shumov-ag/wp2017/README.md

# wp2017

The attempt to make the hardware write blocker for SATA drives.
As a result the sata repeater was made based on a Xilinx Artix-7 FPGA
