shumov-ag/wp2017/doc/WP2017-1803051133-N.pdf

#COMPANY# | #WP#2017#/1803051133-N

Страница 1 из 23

### Черновик

### Блокиратор записи для дисков с интерфейсом SATA –

### Заметки

### История расходов #2

Страница 2 из 23

## Оглавление

Страница 3 из 23

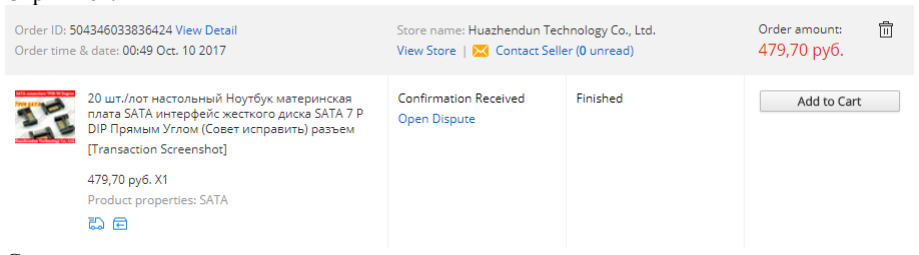
[picture p24: figure]
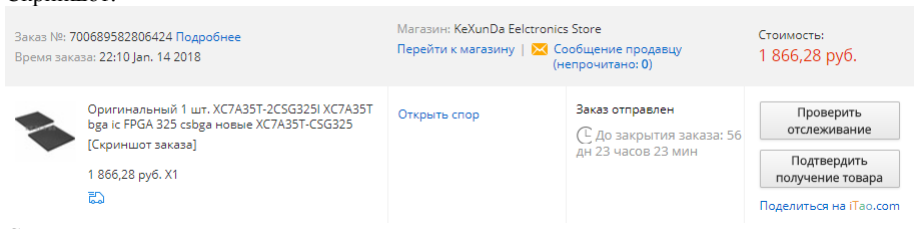
[picture p25: figure]
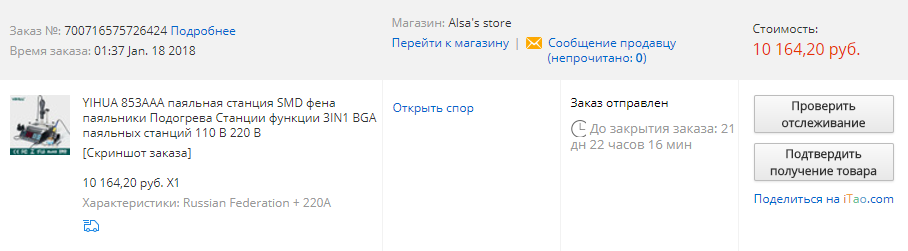
[picture p26: figure]

Страница 4 из 23

## Список заказов на aliexpress.com

### Заказ от 2017.10.10 00:49

Информация о заказе | Цена
Скриншот: Ссылки: • https://www.aliexpress.com/item/20pcs-lot-Notebook-desktop-motherboard-SATA-hard-disk-drive-interface-SATA-7P-DIP-Right-Angle-Board/32394016162.html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 (https://www.aliexpress.com/item/20pcs-lot-Notebook-desktop-motherboard-SATA-hard-disk-drive-interface-SATA-7P-DIP-Right-Angle-Board/32394016162.html) | 479 руб.

### Заказ от 2018.01.14 22:10

Информация о заказе | Цена
Скриншот: Ссылки: • https://www.aliexpress.com/item/Original-1PCS-XC7A35T-2CSG325I-XC7A35T-BGA-IC-FPGA-325CSBGA-NEWEST-XC7A35T-CSG325/32840221798.html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 (https://www.aliexpress.com/item/Original-1PCS-XC7A35T-2CSG325I-XC7A35T-BGA-IC-FPGA-325CSBGA-NEWEST-XC7A35T-CSG325/32840221798.html) | 1866 руб.

### Заказ от 2018.01.18 01:37

Информация о заказе | Цена
Скриншот: Ссылки: • https://www.aliexpress.com/item/YIHUA-853AAA-Bga-Rework-Station-SMD-Hot-Air-Gun-Soldering-Irons-Preheating-Station-Functions-3IN1-Bga/32663262041.html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 (https://www.aliexpress.com/item/YIHUA-853AAA-Bga-Rework-Station-SMD-Hot-Air-Gun-Soldering-Irons-Preheating-Station-Functions-3IN1-Bga/32663262041.html) | 10164 руб.

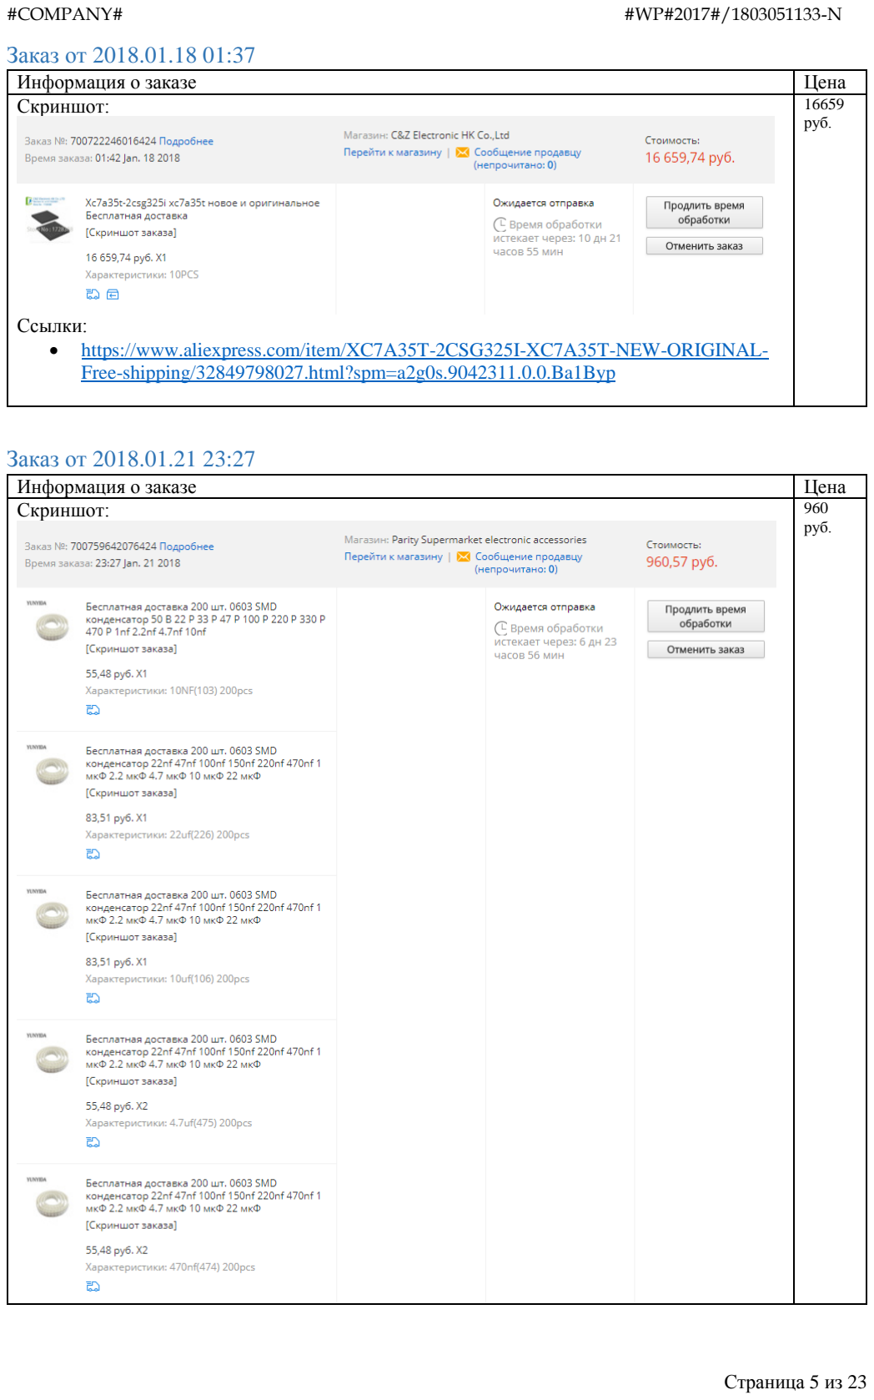
[picture p27: page 5]

Страница 5 из 23

### Заказ от 2018.01.18 01:37

Информация о заказе | Цена
Скриншот: Ссылки: • https://www.aliexpress.com/item/XC7A35T-2CSG325I-XC7A35T-NEW-ORIGINAL-Free-shipping/32849798027.html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 (https://www.aliexpress.com/item/XC7A35T-2CSG325I-XC7A35T-NEW-ORIGINAL-Free-shipping/32849798027.html) | 16659 руб.

### Заказ от 2018.01.21 23:27

Информация о заказе | Цена
Скриншот: | 960 руб.

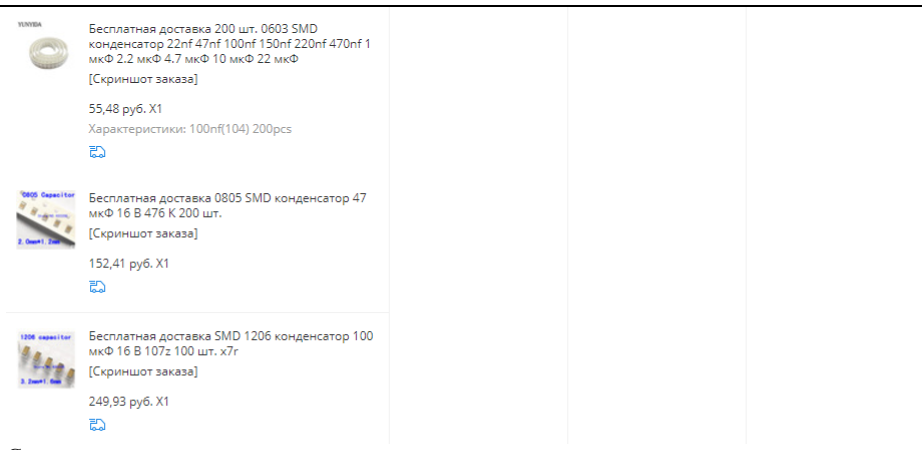
[picture p28: figure]

Страница 6 из 23

Ссылки:
- https://www.aliexpress.com/item/Free-shipping-200pcs-0603-SMD-capacitor-50V-22P-33P-47P-100P-220P-330P-470P-1NF-2/32371748593.html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 (https://www.aliexpress.com/item/Free-shipping-200pcs-0603-SMD-capacitor-50V-22P-33P-47P-100P-220P-330P-470P-1NF-2/32371748593.html)
- https://www.aliexpress.com/item/Free-shipping-200pcs-0603-SMD-capacitor-22nf-47nf-100nf-150nf-220nf-470nf-1uf-2-2uf-4/32371820116.html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
- https://www.aliexpress.com/item/Free-shipping-200pcs-0603-SMD-capacitor-22nf-47nf-100nf-150nf-220nf-470nf-1uf-2-2uf-4/32371820116.html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
- https://www.aliexpress.com/item/Free-shipping-200pcs-0603-SMD-capacitor-22nf-47nf-100nf-150nf-220nf-470nf-1uf-2-2uf-4/32371820116.html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
- https://www.aliexpress.com/item/Free-shipping-200pcs-0603-SMD-capacitor-22nf-47nf-100nf-150nf-220nf-470nf-1uf-2-2uf-4/32371820116.html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
- https://www.aliexpress.com/item/Free-shipping-200pcs-0603-SMD-capacitor-22nf-47nf-100nf-150nf-220nf-470nf-1uf-2-2uf-4/32371820116.html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 (https://www.aliexpress.com/item/Free-shipping-200pcs-0603-SMD-capacitor-22nf-47nf-100nf-150nf-220nf-470nf-1uf-2-2uf-4/32371820116.html)
- https://www.aliexpress.com/item/Free-shipping-0805-SMD-capacitor-47uf-16V-476K-200PCS/32374775645.html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 (https://www.aliexpress.com/item/Free-shipping-0805-SMD-capacitor-47uf-16V-476K-200PCS/32374775645.html)
- https://www.aliexpress.com/item/Free-shipping-1206-SMD-capacitor-100uf-16V-107Z-100pcs-X7R/32376068793.html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 (https://www.aliexpress.com/item/Free-shipping-1206-SMD-capacitor-100uf-16V-107Z-100pcs-X7R/32376068793.html)

### Заказ от 2018.01.21 23:28

Информация о заказе | Цена
Скриншот: Ссылки: • https://www.aliexpress.com/item/M705-Lead-free-silver-3-DIY-preferred-0-8mm-solder-wire-3Meters-tube-package/32472497164.html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 (https://www.aliexpress.com/item/M705-Lead-free-silver-3-DIY-preferred-0-8mm-solder-wire-3Meters-tube-package/32472497164.html) | 397 руб.

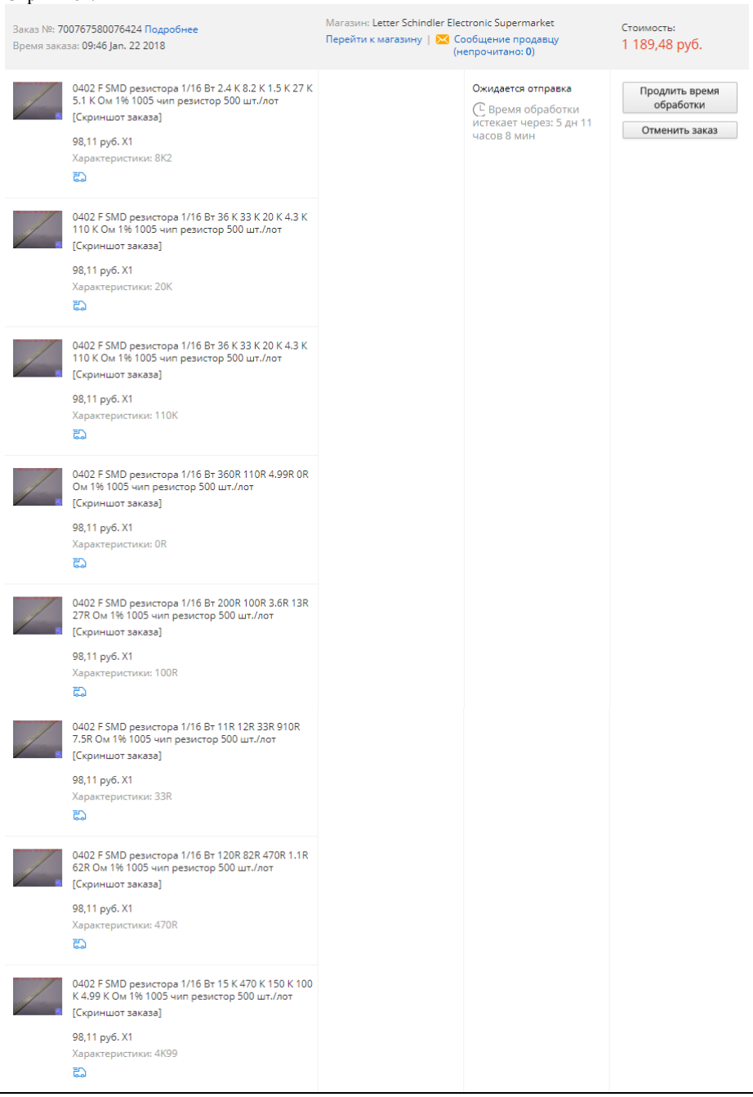
[picture p29: figure]

Страница 7 из 23

### Заказ от 2018.01.22 09:46

Информация о заказе | Цена
Скриншот: | 1189 руб.

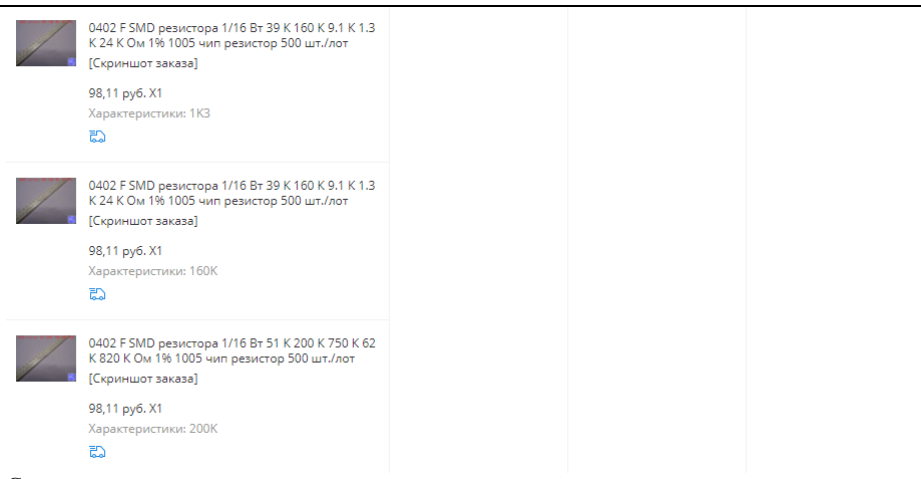
[picture p30: figure]

Страница 8 из 23

Ссылки:
- https://www.aliexpress.com/item/0402-F-SMD-resistor-1-16W-2-4K-8-2K-1-5K-27K-5-1K-ohm/32803590701.html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 (https://www.aliexpress.com/item/0402-F-SMD-resistor-1-16W-2-4K-8-2K-1-5K-27K-5-1K-ohm/32803590701.html)
- https://www.aliexpress.com/item/0402-F-SMD-resistor-1-16W-36K-33K-20K-4-3K-110K-ohm-1-1005-Chip/32803606372.html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
- https://www.aliexpress.com/item/0402-F-SMD-resistor-1-16W-36K-33K-20K-4-3K-110K-ohm-1-1005-Chip/32803606372.html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 (https://www.aliexpress.com/item/0402-F-SMD-resistor-1-16W-36K-33K-20K-4-3K-110K-ohm-1-1005-Chip/32803606372.html)
- https://www.aliexpress.com/item/0402-F-SMD-resistor-1-16W-360R-110R-4-99R-0R-ohm-1-1005-Chip-resistor/32803614373.html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 (https://www.aliexpress.com/item/0402-F-SMD-resistor-1-16W-360R-110R-4-99R-0R-ohm-1-1005-Chip-resistor/32803614373.html)
- https://www.aliexpress.com/item/0402-F-SMD-resistor-1-16W-200R-100R-3-6R-13R-27R-ohm-1-1005-Chip/32803860683.html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 (https://www.aliexpress.com/item/0402-F-SMD-resistor-1-16W-200R-100R-3-6R-13R-27R-ohm-1-1005-Chip/32803860683.html)
- https://www.aliexpress.com/item/0402-F-SMD-resistor-1-16W-11R-12R-33R-910R-7-5R-ohm-1-1005-Chip/32803868569.html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 (https://www.aliexpress.com/item/0402-F-SMD-resistor-1-16W-11R-12R-33R-910R-7-5R-ohm-1-1005-Chip/32803868569.html)
- https://www.aliexpress.com/item/0402-F-SMD-resistor-1-16W-120R-82R-470R-1-1R-62R-ohm-1-1005-Chip/32803900324.html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 (https://www.aliexpress.com/item/0402-F-SMD-resistor-1-16W-120R-82R-470R-1-1R-62R-ohm-1-1005-Chip/32803900324.html)
- https://www.aliexpress.com/item/0402-F-SMD-resistor-1-16W-15K-470K-150K-100K-4-99K-ohm-1-1005-Chip/32803908209.html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 (https://www.aliexpress.com/item/0402-F-SMD-resistor-1-16W-15K-470K-150K-100K-4-99K-ohm-1-1005-Chip/32803908209.html)
- https://www.aliexpress.com/item/0402-F-SMD-resistor-1-16W-39K-160K-9-1K-1-3K-24K-ohm-1-1005/32803928083.html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
- https://www.aliexpress.com/item/0402-F-SMD-resistor-1-16W-39K-160K-9-1K-1-3K-24K-ohm-1-1005/32803928083.html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 (https://www.aliexpress.com/item/0402-F-SMD-resistor-1-16W-39K-160K-9-1K-1-3K-24K-ohm-1-1005/32803928083.html)
- https://www.aliexpress.com/item/0402-F-SMD-resistor-1-16W-51K-200K-750K-62K-820K-ohm-1-1005-Chip-resistor/32805763665.html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 (https://www.aliexpress.com/item/0402-F-SMD-resistor-1-16W-51K-200K-750K-62K-820K-ohm-1-1005-Chip-resistor/32805763665.html)

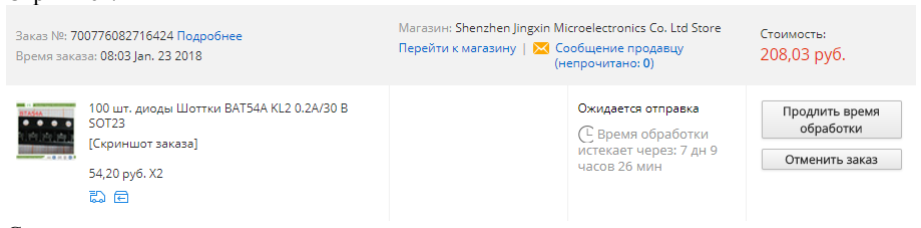
[picture p31: figure]
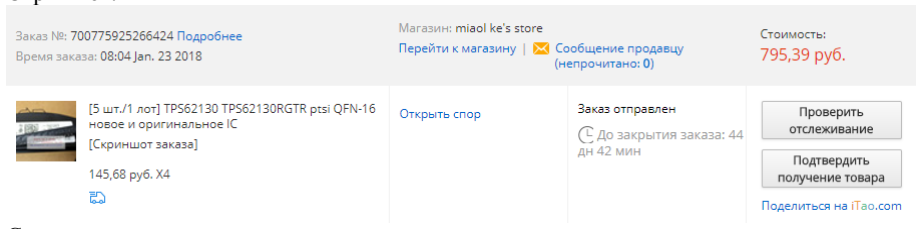
[picture p32: figure]

Страница 9 из 23

### Заказ от 2018.01.23 08:03

Информация о заказе | Цена
Скриншот: Ссылки: • https://www.aliexpress.com/item/100PCS-Schottky-diodes-BAT54A-KL2-0-2A-30V-SOT23/32759763930.html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 (https://www.aliexpress.com/item/100PCS-Schottky-diodes-BAT54A-KL2-0-2A-30V-SOT23/32759763930.html) | 208 руб.

### Заказ от 2018.01.23 08:04

Информация о заказе | Цена
Скриншот: Ссылки: • https://www.aliexpress.com/item/5pcs-1lot-TPS62130-TPS62130RGTR-PTSI-QFN-16-new-and-original-IC/32844557119.html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 (https://www.aliexpress.com/item/5pcs-1lot-TPS62130-TPS62130RGTR-PTSI-QFN-16-new-and-original-IC/32844557119.html) | 795 руб.


Страница 10 из 23

### Заказ от 2018.01.23 08:05

Информация о заказе | Цена
Скриншот:

Ссылки:
- https://www.aliexpress.com/item/MCIGICM-100pcs-0805-SMD-LED-light-Package-LED-Package-Red-White-Green-Blue-Yellow-0805-led/32669899450.html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 (https://www.aliexpress.com/item/MCIGICM-100pcs-0805-SMD-LED-light-Package-LED-Package-Red-White-Green-Blue-Yellow-0805-led/32669899450.html)
- https://www.aliexpress.com/item/MCIGICM-500pcs-0402-smd-capacitor-ceramic-10nf-100nf-1uf-2-2uf-4-7uf-10uf-capacitorsdiy/32840316447.html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
- https://www.aliexpress.com/item/MCIGICM-500pcs-0402-smd-capacitor-ceramic-10nf-100nf-1uf-2-2uf-4-7uf-10uf-capacitorsdiy/32840316447.html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
- https://www.aliexpress.com/item/MCIGICM-500pcs-0402-smd-capacitor-ceramic-10nf-100nf-1uf-2-2uf-4-7uf-10uf-capacitorsdiy/32840316447.html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
- https://www.aliexpress.com/item/MCIGICM-500pcs-0402-smd-capacitor-ceramic-10nf-100nf-1uf-2-2uf-4-7uf-10uf-capacitorsdiy/32840316447.html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 (https://www.aliexpress.com/item/MCIGICM-500pcs-0402-smd-capacitor-ceramic-10nf-100nf-1uf-2-2uf-4-7uf-10uf-capacitors-diy/32840316447.html)

1390
руб.

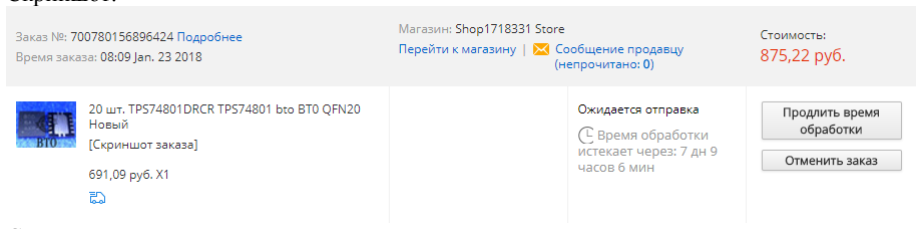
[picture p33: figure]

Страница 11 из 23

### Заказ от 2018.01.23 08:07

Информация о заказе | Цена
Скриншот: Ссылки: • https://www.aliexpress.com/item/1PCS-original-XHX-lead-free-high-temperature-solder-paste-Sn96-5Ag3Cu0-5-SAC305-Soldering-Flux-Welding/32794187353.html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 (https://www.aliexpress.com/item/1PCS-original-XHX-lead-free-high-temperature-solder-paste-Sn96-5Ag3Cu0-5-SAC305-Soldering-Flux-Welding/32794187353.html) | 485 руб.

### Заказ от 2018.01.23 08:09

Информация о заказе | Цена
Скриншот: Ссылки: • https://www.aliexpress.com/item/Free-shipping-high-quality-BAT54AW-7-F-BAT54AW-SOT323-50-PCS/32542328485.html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 (https://www.aliexpress.com/item/Free-shipping-high-quality-BAT54AW-7-F-BAT54AW-SOT323-50-PCS/32542328485.html) | 322 руб.

### Заказ от 2018.01.23 08:09

Информация о заказе | Цена
Скриншот: Ссылки: • https://www.aliexpress.com/item/20Pcs-TPS74801DRCR-TPS74801-BTO-BT0-QFN20-New/32829444686.html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 (https://www.aliexpress.com/item/20Pcs-TPS74801DRCR-TPS74801-BTO-BT0-QFN20-New/32829444686.html) | 875 руб.

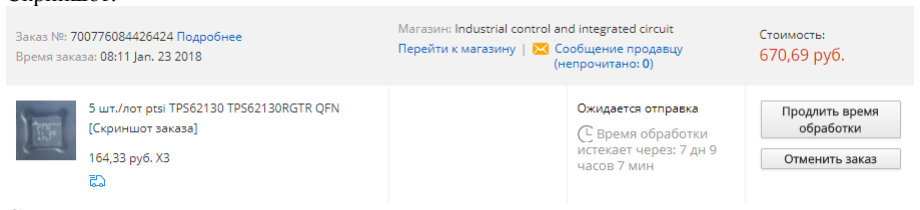
[picture p34: figure]
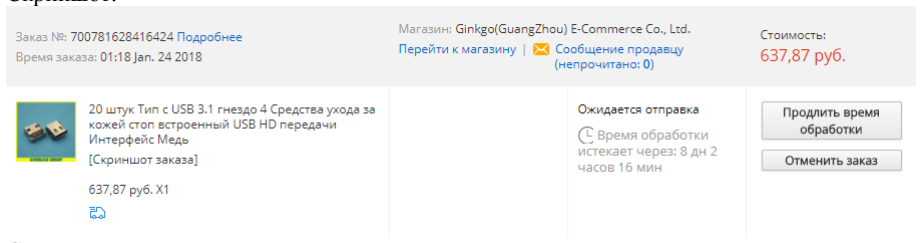
[picture p35: figure]

Страница 12 из 23

### Заказ от 2018.01.23 08:10

Информация о заказе | Цена
Скриншот: Ссылки: • https://www.aliexpress.com/item/2017-TPS74801DRCR-TPS74801DRCRG4-TPS74801-BTO-DFN10/32840690816.html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 (https://www.aliexpress.com/item/2017-TPS74801DRCR-TPS74801DRCRG4-TPS74801-BTO-DFN10/32840690816.html) | 527 руб.

### Заказ от 2018.01.23 08:11

Информация о заказе | Цена
Скриншот: Ссылки: • https://www.aliexpress.com/item/5pcs-lot-PTSI-TPS62130-TPS62130RGTR-QFN/32726983473.html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 (https://www.aliexpress.com/item/5pcs-lot-PTSI-TPS62130-TPS62130RGTR-QFN/32726983473.html) | 670 руб.

### Заказ от 2018.01.24 01:18

Информация о заказе | Цена
Скриншот: Ссылки: • https://www.aliexpress.com/item/20pcs-Type-C-USB-3-1-Female-Socket-4-Feet-Inline-USB-HD-Transfer-Interface-Copper/32847217188.html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 (https://www.aliexpress.com/item/20pcs-Type-C-USB-3-1-Female-Socket-4-Feet-Inline-USB-HD-Transfer-Interface-Copper/32847217188.html) | 637 руб.

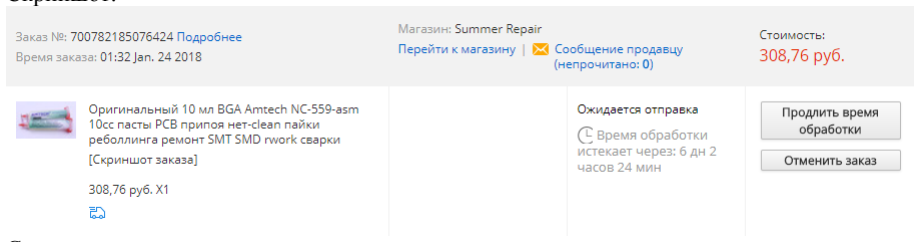
[picture p36: figure]
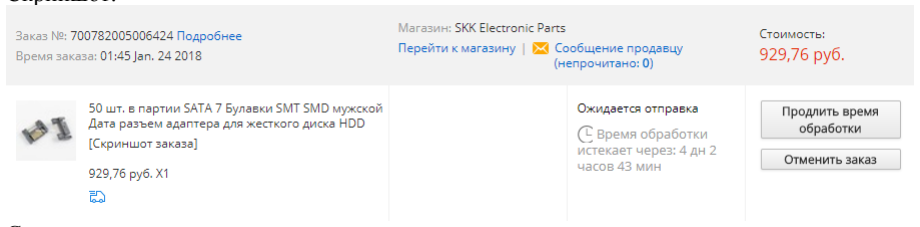
[picture p37: figure]
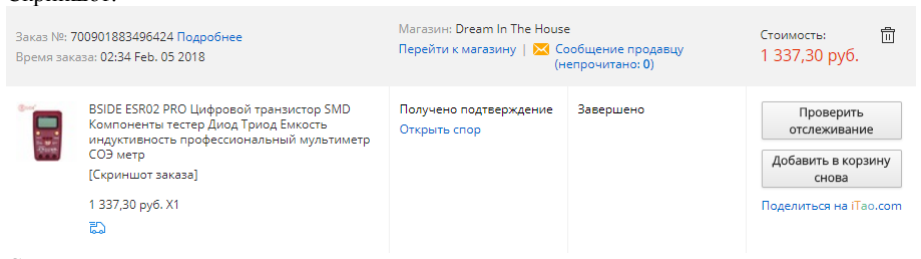
[picture p38: figure]

Страница 13 из 23

### Заказ от 2018.01.24 01:32

Информация о заказе | Цена
Скриншот: Ссылки: • https://www.aliexpress.com/item/Original-10ml-BGA-AMTECH-NC-559-ASM-10cc-Paste-PCB-Solder-Flux-No-Clean-Soldering-Reballing/32634810349.html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 (https://www.aliexpress.com/item/Original-10ml-BGA-AMTECH-NC-559-ASM-10cc-Paste-PCB-Solder-Flux-No-Clean-Soldering-Reballing/32634810349.html) | 308 руб.

### Заказ от 2018.01.24 01:45

Информация о заказе | Цена
Скриншот: Ссылки: • https://www.aliexpress.com/item/50pcs-Per-Lot-Sata-7-Pin-SMT-SMD-Male-Date-Adapter-Connector-For-Hard-Drive-HDD/32766705009.html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 (https://www.aliexpress.com/item/50pcs-Per-Lot-Sata-7-Pin-SMT-SMD-Male-Date-Adapter-Connector-For-Hard-Drive-HDD/32766705009.html) | 929 руб.

### Заказ от 2018.02.05 02:34

Информация о заказе | Цена
Скриншот: Ссылки: • https://ru.aliexpress.com/item/BSIDE-ESR02-PRO-SMD/32838890524.html?spm=a2g0s.9042311.0.0.Z4YG04 (https://ru.aliexpress.com/item/BSIDE-ESR02-PRO-SMD/32838890524.html?spm=a2g0s.9042311.0.0.Z4YG04) | 1337 руб.

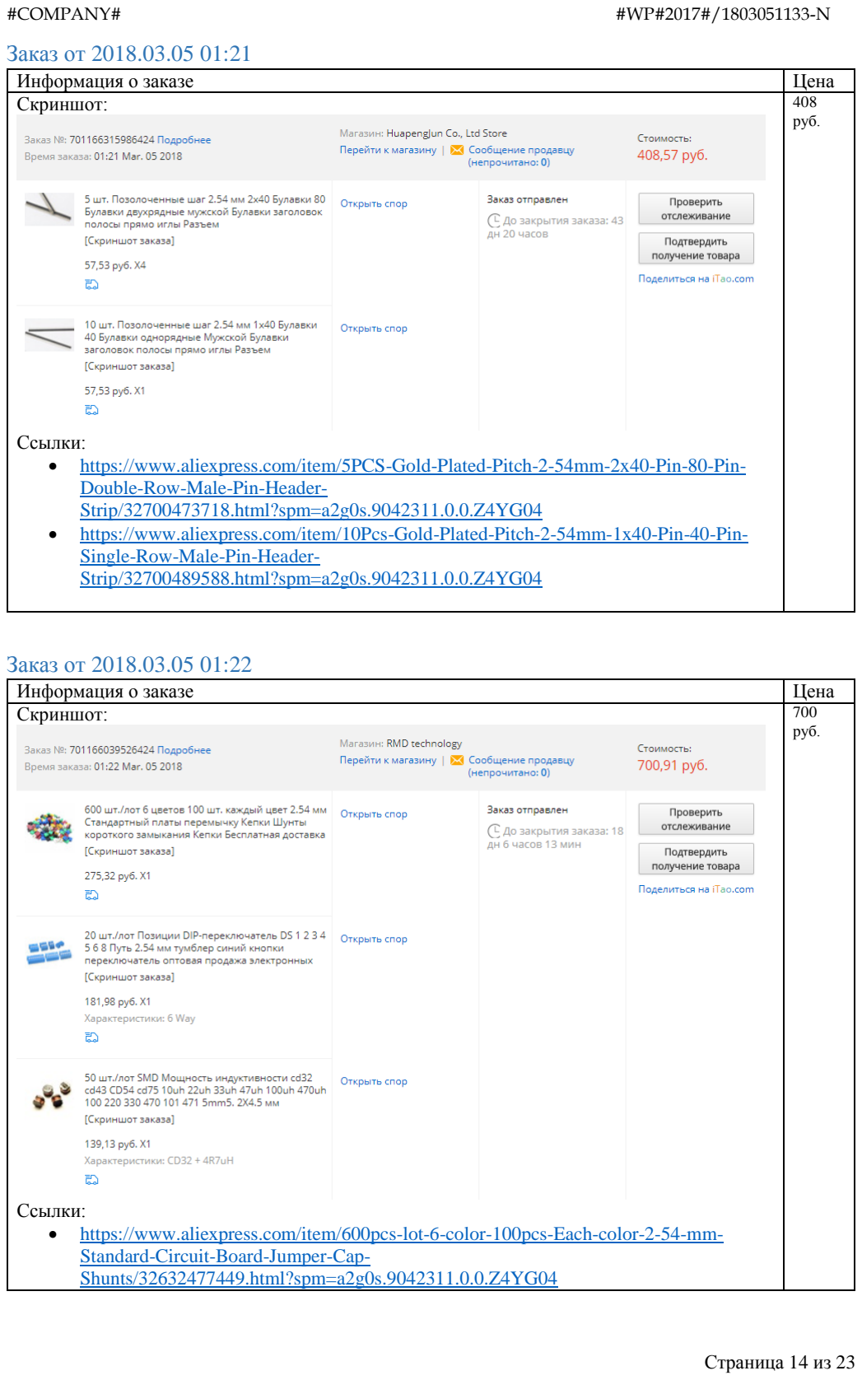
[picture p39: page 14]

Страница 14 из 23

### Заказ от 2018.03.05 01:21

Информация о заказе | Цена
Скриншот:

Ссылки:
- https://www.aliexpress.com/item/5PCS-Gold-Plated-Pitch-2-54mm-2x40-Pin-80-Pin-Double-Row-Male-Pin-Header-Strip/32700473718.html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 (https://www.aliexpress.com/item/5PCS-Gold-Plated-Pitch-2-54mm-2x40-Pin-80-Pin-Double-Row-Male-Pin-Header-Strip/32700473718.html)
- https://www.aliexpress.com/item/10Pcs-Gold-Plated-Pitch-2-54mm-1x40-Pin-40-Pin-Single-Row-Male-Pin-Header-Strip/32700489588.html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 (https://www.aliexpress.com/item/10Pcs-Gold-Plated-Pitch-2-54mm-1x40-Pin-40-Pin-Single-Row-Male-Pin-Header-Strip/32700489588.html)

408
руб.

### Заказ от 2018.03.05 01:22

Информация о заказе | Цена
Скриншот:

Ссылки:
- https://www.aliexpress.com/item/600pcs-lot-6-color-100pcs-Each-color-2-54-mm-Standard-Circuit-Board-Jumper-Cap-Shunts/32632477449.html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 (https://www.aliexpress.com/item/600pcs-lot-6-color-100pcs-Each-color-2-54-mm-Standard-Circuit-Board-Jumper-Cap-Shunts/32632477449.html)

700
руб.

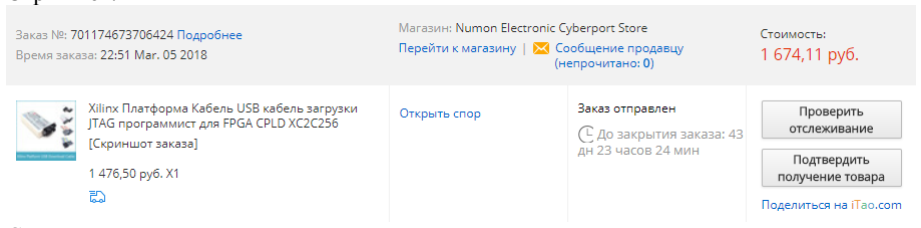
[picture p40: figure]

Страница 15 из 23

- https://www.aliexpress.com/item/20PCS-Lot-Positions-DIP-Switch-DS-1-2-3-4-5-6-8-Way-2-54/32653269068.html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 (https://www.aliexpress.com/item/20PCS-Lot-Positions-DIP-Switch-DS-1-2-3-4-5-6-8-Way-2-54/32653269068.html)
- https://www.aliexpress.com/item/50pcs-lot-SMD-Power-Inductor-CD32-CD43-CD54-CD75-10uH-22uH-33uH-47uH-100uH-470uH-100/32675375093.html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 (https://www.aliexpress.com/item/50pcs-lot-SMD-Power-Inductor-CD32-CD43-CD54-CD75-10uH-22uH-33uH-47uH-100uH-470uH-100/32675375093.html)

### Заказ от 2018.03.05 22:51

Информация о заказе | Цена
Скриншот: Ссылки: • https://www.aliexpress.com/item/Xilinx-Platform-Cable-USB-Download-Cable-Jtag-Programmer-for-FPGA-CPLD-XC2C256/32691266814.html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 (https://www.aliexpress.com/item/Xilinx-Platform-Cable-USB-Download-Cable-Jtag-Programmer-for-FPGA-CPLD-XC2C256/32691266814.html) | 1674 руб.

Страница 16 из 23

## Список заказов на alibaba.com

### Заказ от 2018.01.15 01:53

Информация о заказе | Цена
Скриншот: Ссылки: • https://wholesaler.alibaba.com/product-detail/-Interface-IC-VL716-Q4_60718969695.html (https://wholesaler.alibaba.com/product-detail/-Interface-IC-VL716-Q4_60718969695.html) | $38.60 (2289 руб.)


Страница 17 из 23

## Список заказов на ickey.com

### Заказ от 2017.09.17

Информация о заказе | Цена
Скриншот:

Ссылки:
- http://www.ickey.com/product/detail/1000210719492/TE0714-02-35-2I.html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 (http://www.ickey.com/product/detail/1000210719492/TE0714-02-35-2I.html)
- http://www.ickey.com/product/detail/100029247344/TE0790-02.html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 (http://www.ickey.com/product/detail/100029247344/TE0790-02.html)
- http://www.ickey.com/product/detail/1000210802015/TEBB0714-01.html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 (http://www.ickey.com/product/detail/1000210802015/TEBB0714-01.html)

$246
(14400
руб.)


Страница 18 из 23

### Заказ от 2018.01.23

Информация о заказе | Цена
Скриншот:

Ссылки:
- http://www.ickey.com/product/detail/10025041346533/TPD4E05U06DQAR.html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 (http://www.ickey.com/product/detail/10025041346533/TPD4E05U06DQAR.html)
- http://www.ickey.com/product/detail/10025031399757/HD3SS3415RUAR.html?_ga=2. 160502334.2057210972.1516871647-506423710.1515499514 (http://www.ickey.com/product/detail/10025031399757/HD3SS3415RUAR.html)
- http://www.ickey.com/product/detail/10025031399782/SN75LVPE802RTJR.html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 (http://www.ickey.com/product/detail/10025031399782/SN75LVPE802RTJR.html)
- http://www.ickey.com/product/detail/10025031291659/IHLP1212BZER2R2M11.html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 (http://www.ickey.com/product/detail/10025031291659/IHLP1212BZER2R2M11.html)
- http://www.ickey.com/product/detail/10025031399198/SiT1602BI-23-33E-25.000000G.html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 (http://www.ickey.com/product/detail/10025031399198/SiT1602BI-23-33E-25.000000G.html)
- http://www.ickey.com/product/detail/10025041347132/BKP1608HS121-T.html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 (http://www.ickey.com/product/detail/10025041347132/BKP1608HS121-T.html)
- http://www.ickey.com/product/detail/10025031296564/SN74LVC1G14DBVR.html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 (http://www.ickey.com/product/detail/10025031296564/SN74LVC1G14DBVR.html)
- http://www.ickey.com/product/detail/10025031348963/DSC1123CI2-200.0000.html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 (http://www.ickey.com/product/detail/10025031348963/DSC1123CI2-200.0000.html)
- http://www.ickey.com/product/detail/10025031359166/TPS3805H33DCKR.html?_ga=2 .194581038.2057210972.1516871647-506423710.1515499514 (http://www.ickey.com/product/detail/10025031359166/TPS3805H33DCKR.html)

$379
(21982
руб.)

Страница 19 из 23

- http://www.ickey.com/product/detail/10025031398039/TPS22918DBVR.html?_ga=2.18 6897835.2057210972.1516871647-506423710.1515499514 (http://www.ickey.com/product/detail/10025031398039/TPS22918DBVR.html)
- http://www.ickey.com/product/detail/10025031328175/TPS82085SILR.html?_ga=2.221 83480.2057210972.1516871647-506423710.1515499514 (http://www.ickey.com/product/detail/10025031328175/TPS82085SILR.html)
- http://www.ickey.com/product/detail/10025031392363/LXDC2HL18A-052.html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 (http://www.ickey.com/product/detail/10025031392363/LXDC2HL18A-052.html)
- http://www.ickey.com/product/detail/1000210719492/TE0714-02-35-2I.html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 (http://www.ickey.com/product/detail/1000210719492/TE0714-02-35-2I.html)
- http://www.ickey.com/product/detail/10025031355738/S25FL256SAGNFI001.html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 (http://www.ickey.com/product/detail/10025031355738/S25FL256SAGNFI001.html)


Страница 20 из 23

## Список заказов на migoff.net

### Заказ от 2017.10.31

Информация о заказе | Цена
Скриншот: Ссылки: • https://migoff.net/ | $50 (2890 руб.)

### Заказ от 2018.02.08

Информация о заказе | Цена
Скриншот: Ссылки: • https://migoff.net/ | $57 (3415 руб.)


Страница 21 из 23

## Список заказов на domko.ru

### Заказ от 2017.11.02

Информация о заказе | Цена
Скриншот: Ссылки: • https://www.domko.ru/item/MCRCH/DSC1123CI2-200.0000 | 1274 руб.

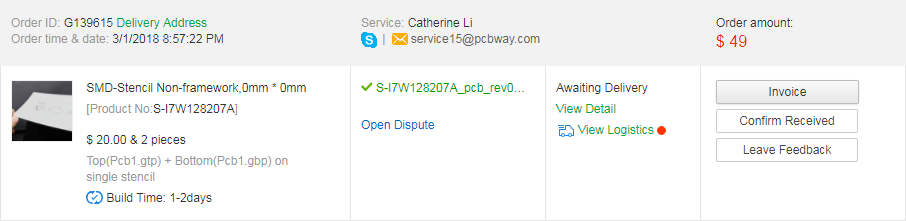
[picture p41: figure]
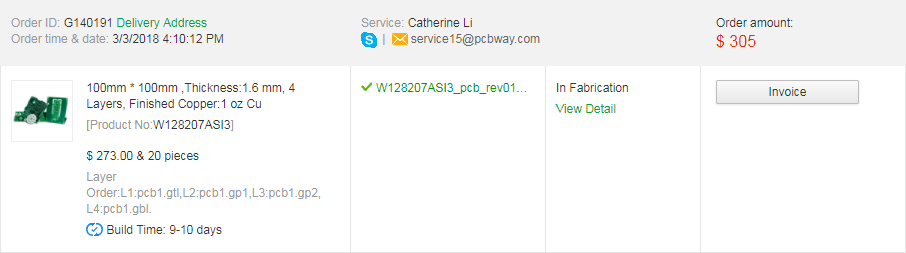
[picture p42: figure]

Страница 22 из 23

## Список заказов на pcbway.com

### Заказ от 2018.03.01

Информация о заказе | Цена
Скриншот: Ссылки: • https://www.pcbway.com | $49 (2856 руб.)

### Заказ от 2018.03.03

Информация о заказе | Цена
Скриншот: Ссылки: • https://www.pcbway.com | $305 (17926 руб.)

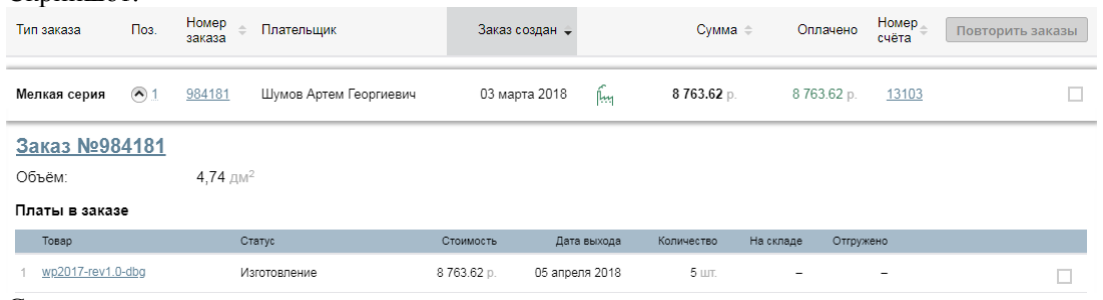
[picture p43: figure]

Страница 23 из 23

## Список заказов на rezonit.ru

### Заказ от 2018.03.03

Информация о заказе | Цена
Скриншот: Ссылки: • https://www.rezonit.ru | 8763 руб.
