shumov-ag/wp2017/doc/WP2017-1804291737-N.pdf

#COMPANY# | #WP#2017#/1804291737-N

Страница 1 из 6

### Черновик

### Блокиратор записи для дисков с интерфейсом SATA –

### Заметки

### Сборка отладочной печатной платы (не завершено)

Страница 2 из 6

## Оглавление

## Сравнение печатных плат под микроскопом

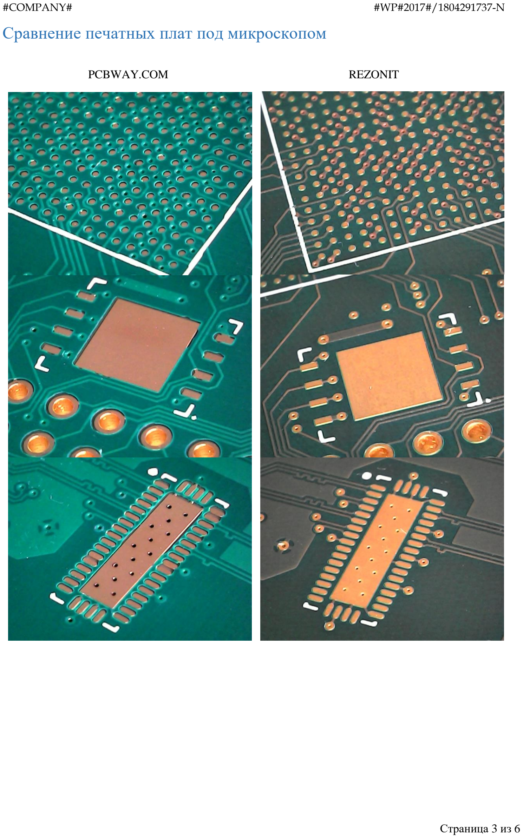
[picture p64: page 3]

Страница 3 из 6

PCBWAY.COM | REZONIT

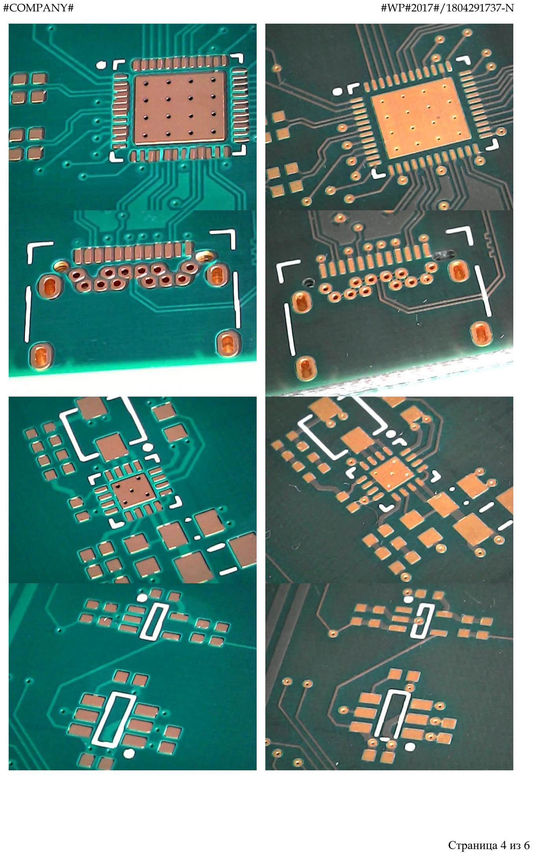
[picture p65: page 4]

Страница 4 из 6

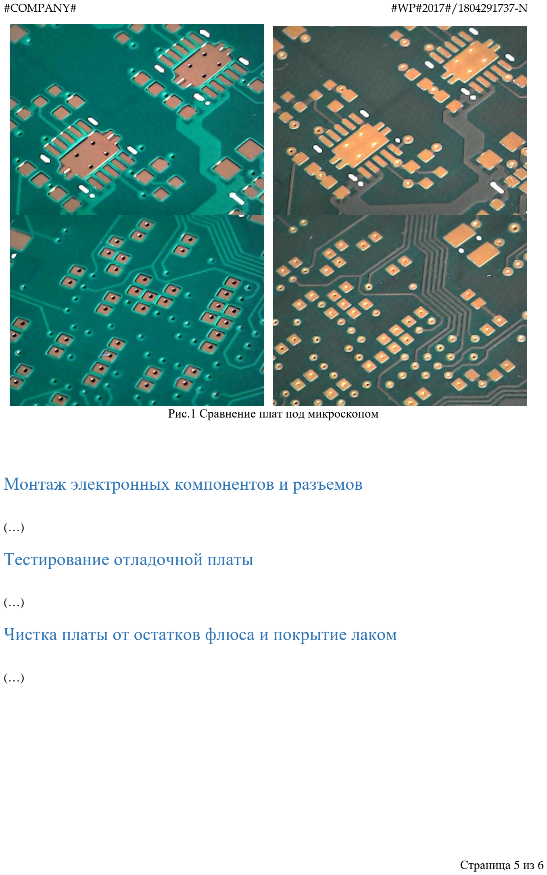
[picture p66: page 5]

Страница 5 из 6

Рис.1 Сравнение плат под микроскопом

## Монтаж электронных компонентов и разъемов

(…)

## Тестирование отладочной платы

(…)

## Чистка платы от остатков флюса и покрытие лаком

(…)

Страница 6 из 6

## Итог

Качество печатных плат, изготовленных Резонитом выше чем у PCBWAY. В первую очередь это касается качества нанесения паяльной маски. Толщина фольги на платах Резонита в 2 раза меньше, однако сопротивление проводников на них меньше чем на платах PCBWAY где-то на 20%.

Тем не менее отличий в работе устройств, собранных на базе этих плат, не замечено.
