shumov-ag/wp2017/doc/WP2017-1801091425-N.pdf

#COMPANY# | #WP#2017#/1801091425-N

Страница 1 из 6

### Черновик

### Блокиратор записи для дисков с интерфейсом SATA –

### Заметки

Страница 2 из 6

## Оглавление

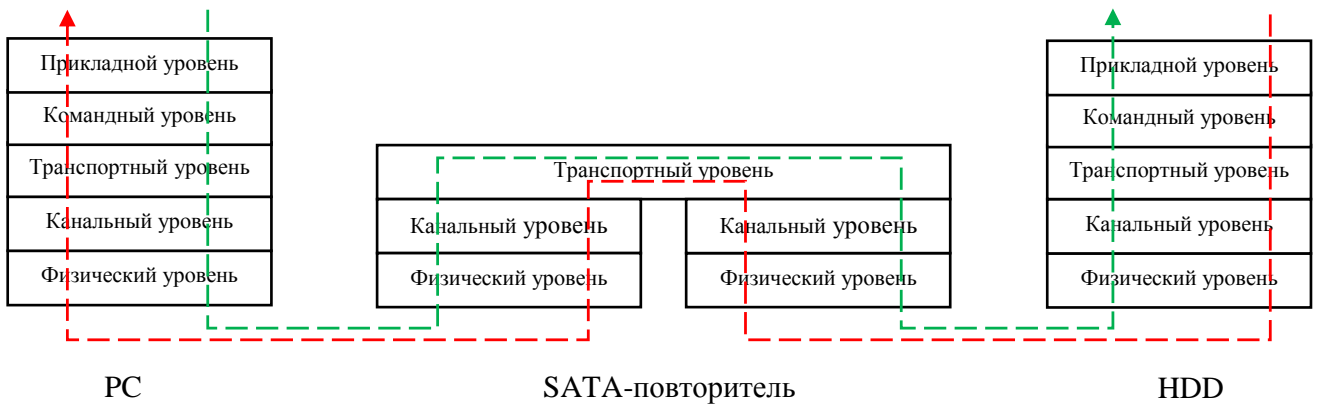
[picture p70: figure]
Физический уровень; Канальный уровень; Транспортный уровень; Командный уровень; Прикладной уровень; SATA-повторитель; HDD

Страница 3 из 6

## SATA-повторитель (теория)

SATA-повторитель – это устройство, прозрачно передающее данные между хостом (PC) и девайсом (HDD) через интерфейс SATA. Идеальный SATA-повторитель PC и HDD воспринимают как обычный SATA-кабель.

Аппаратный блокиратор записи данных на диск с интерфейсом SATA – это идеальный SATA-повторитель, снабженный логикой, ограничивающей передачу запрещенных команд от PC к HDD. Т.к. для работы этой логики необходимо иметь возможность управления потоком данных, то SATA-повторитель должен работать на канальном или более высоком уровне протокола SATA. Схема взаимодействия PC и HDD через SATA-повторитель показана на рис.1.

Рис.1 Схема взаимодействия PC и HDD через с SATA-повторитель

Логика работы такого устройства напоминает логику работы SATA-мультиплексора (SATA Multiplier), которая подробно описана в последних спецификациях на Serial ATA.

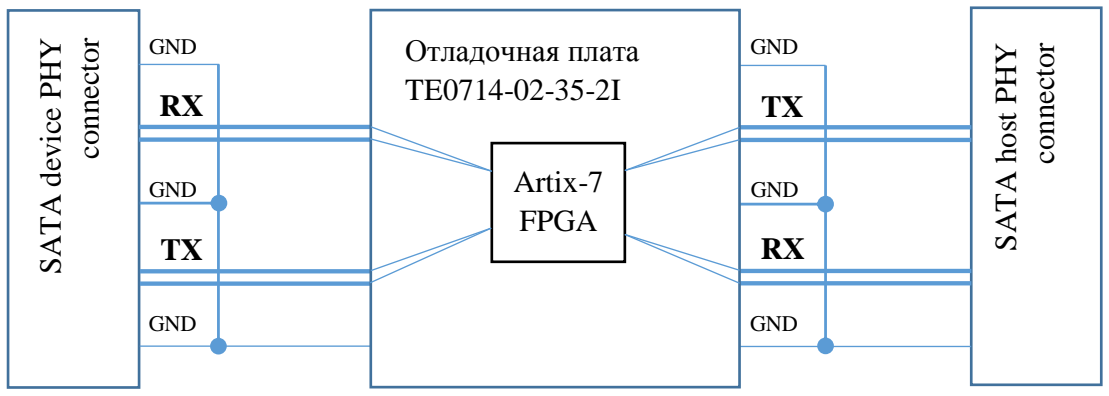
[picture p71: figure]
GND; SATA host PHY; connector; SATA device PHY; Отладочная плата TE0714-02-35-2I; Artix-7 FPGA
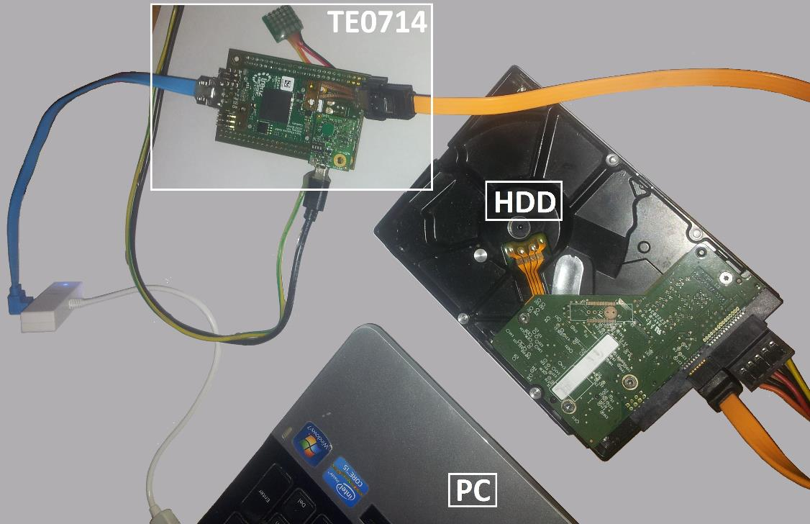
[picture p72: figure]

Страница 4 из 6

## SATA-повторитель (практика)

Для реализации простейшего SATA-повторителя использовался отладочный набор фирмы Trenz Electronic на базе FPGA Artix-7 XC7A35T-2CSG325I. Состав набора:

- TE0714-02-35-2I¹
(Artix Micromodule A35 with Xilinx XC7A35T-2CSG325I)
- TEBB0714-01²
(Simple Base for TE0714)
- TE0790-02³
(XMOD FTDI JTAG Adapter - Xilinx compatible)

Для программирования логики работы устройства использовалась среда Vivado Design Suite - HLx Editions - 2017.2⁴

Структурная схема реализованного SATA-повторителя показана на рис.2.

Рис.2 Структурная схема SATA-повторителя на базе отладочной платы TE0714-02-35-2I

Изображение реализованного SATA-повторителя показано на рис.3.

Рис.3 Изображение SATA-повторителя на базе отладочной платы TE0714-02-35-2I, подключенного к HDD с одной стороны, и к PC (через USB-SATA адаптер), с другой стороны.

1 https://shop.trenz-electronic.de/en/TE0714-02-35-2I-Artix-Micromodule-A35-with-Xilinx-XC7A35T-2CSG325Ispeedgrade-2I (https://shop.trenz-electronic.de/en/TE0714-02-35-2I-Artix-Micromodule-A35-with-Xilinx-XC7A35T-2CSG325I-speedgrade-2I)
2 https://shop.trenz-electronic.de/en/TEBB0714-01-Simple-Base-for-TE0714
3 https://shop.trenz-electronic.de/en/TE0790-02-XMOD-FTDI-JTAG-Adapter-Xilinx-compatible
4 https://www.xilinx.com/content/xilinx/en/downloadNav/vivado-design-tools/2017-2.html

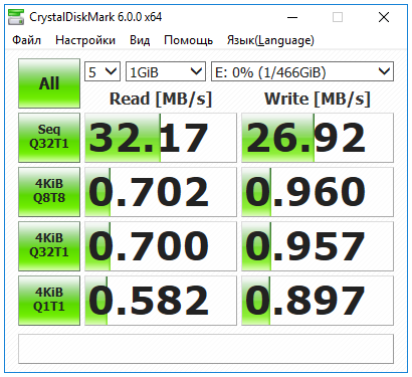
[picture p73: figure]
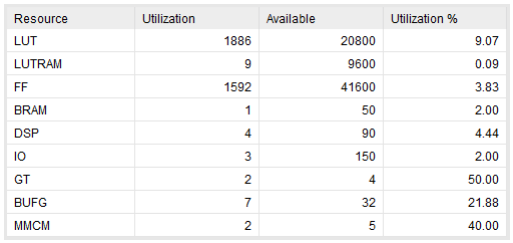
[picture p74: figure]

Страница 5 из 6

Скорость ввода-вывода данных с HDD через SATA-повторитель уменьшается. Результаты сравнения скорости ввода-вывода показаны на рис.4. Во время тестов диск подключался к ПК через USB2.0-SATA адаптер, из-за чего абсолютные скорости ввода-вывода были ограничены пропускной способностью интерфейса USB2.0. Тем не менее, величина относительного падения пропускной способности в случае использования текущей версии SATA-повторителя, может считаться допустимой.

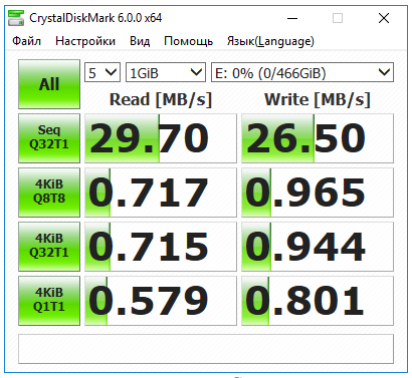
[picture p75: figure]

Рис.4 Сравнение скорости ввода-вывода данных с HDD. слева: [PC] – [USB2.0-to-SATA-адаптер] – [SATA-повторитель] – [HDD], справа: [PC] – [USB2.0-to-SATA-адаптер] – [HDD]

Из-за неполной (около 40 %) реализации физического (Phy) уровня, разработанный SATA-повторитель работает только на скорости 1.5 Гт/с. Канальный (Link) уровень большей частью реализован (около 70 %). Отсутствие некоторых функций не создает серьезных ограничений для работы устройства. Учитывая степень реализации проекта и количество занятого в FPGA пространства под этот проект (9 % наиболее используемых логических элементов LUT) можно предположить, что ресурса используемой FPGA достаточно для создания более завершенного SATA-повторителя, и на его основе – блокиратора записи данных.

Рис.5 Ресурсы FPGA XC7A35T-2CSG325I, занятые под логику работы SATA-повторителя.

Страница 6 из 6

## Итог

В итоге, имеем устройство, на базе которого можно создавать блокиратор записи. Параллельно с этим, можно дорабатывать физический и канальный уровни, делая их максимально соответствующими спецификации на протокол.
