shumov-ag/wp2017/pcb/img/5607-4200-SH.stp

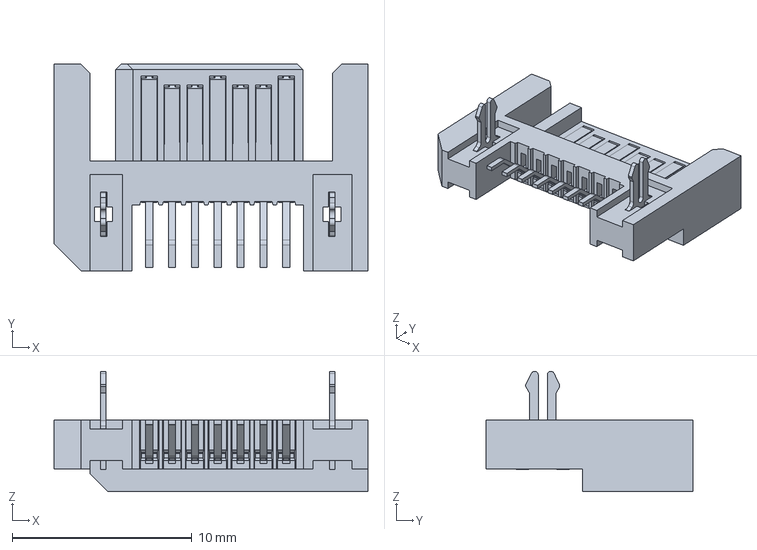
[picture p76: CAD file, 2023-07-20]
pcb/img/5607-4200-SH.stp
17.5 x 11.5 x 6.70 mm
