shumov-ag/wp2017/doc/WP2017-1803221239-SCH.pdf

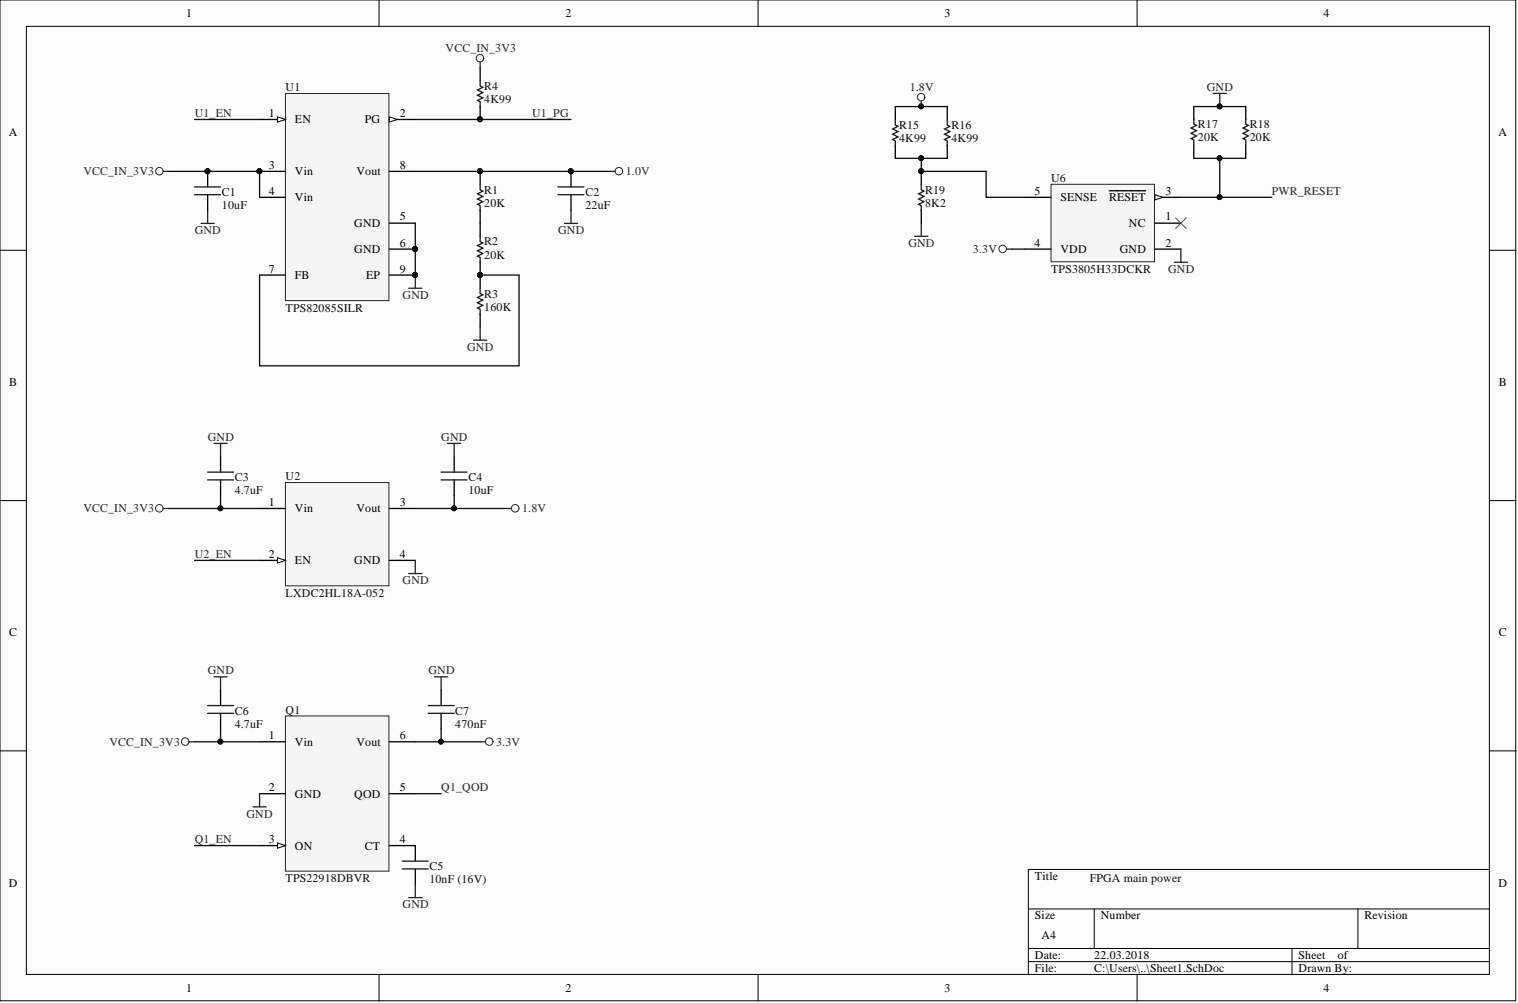
[picture p77: page 1]

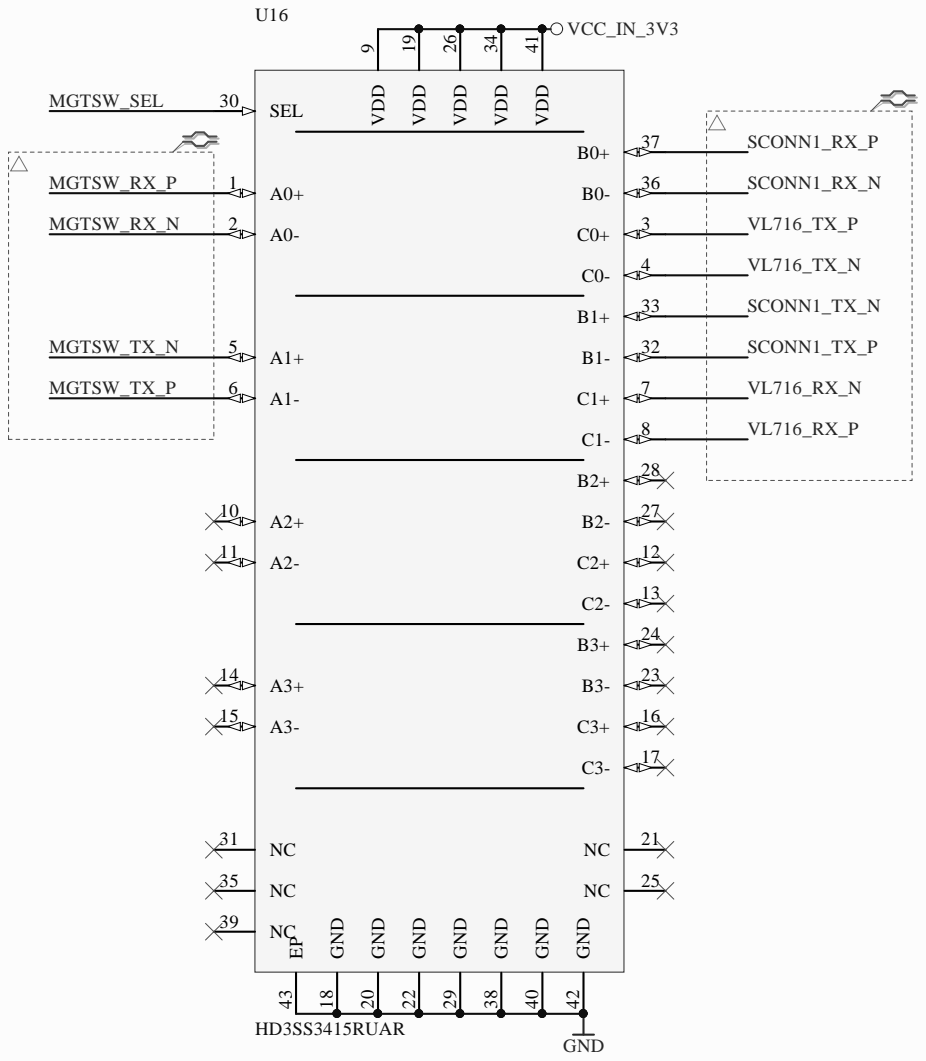
[picture p78: page 2]

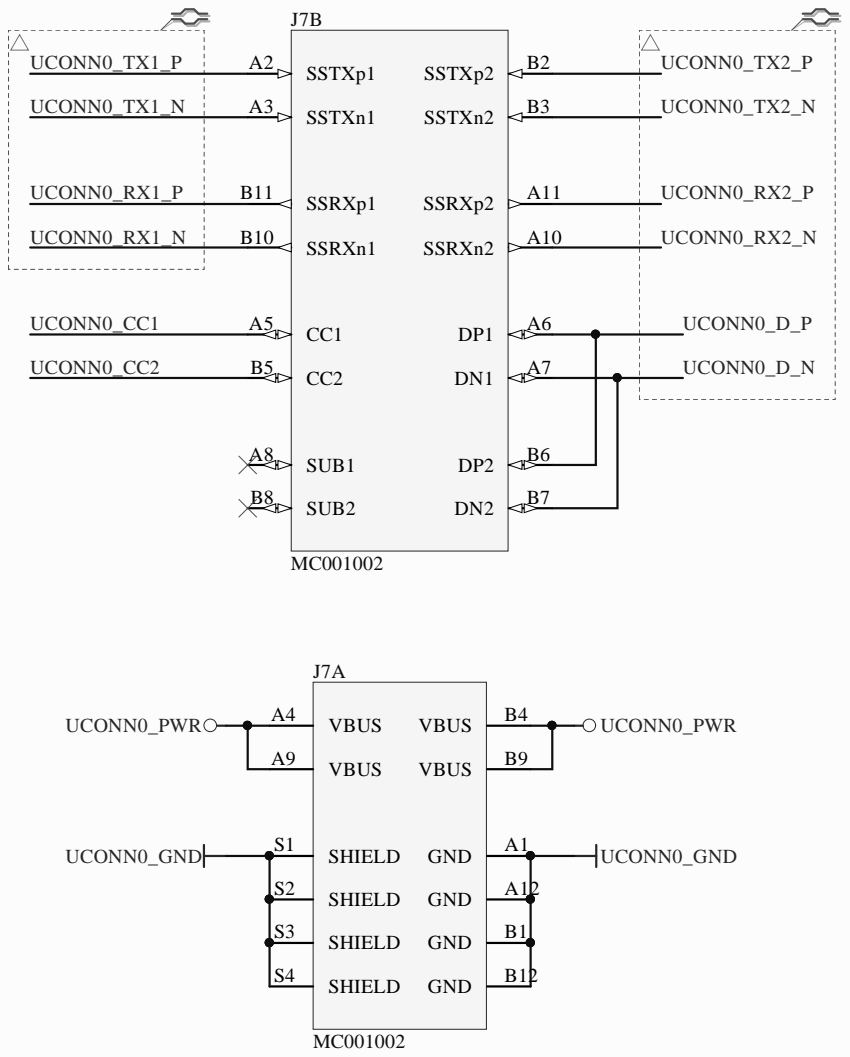
[picture p79: page 3]

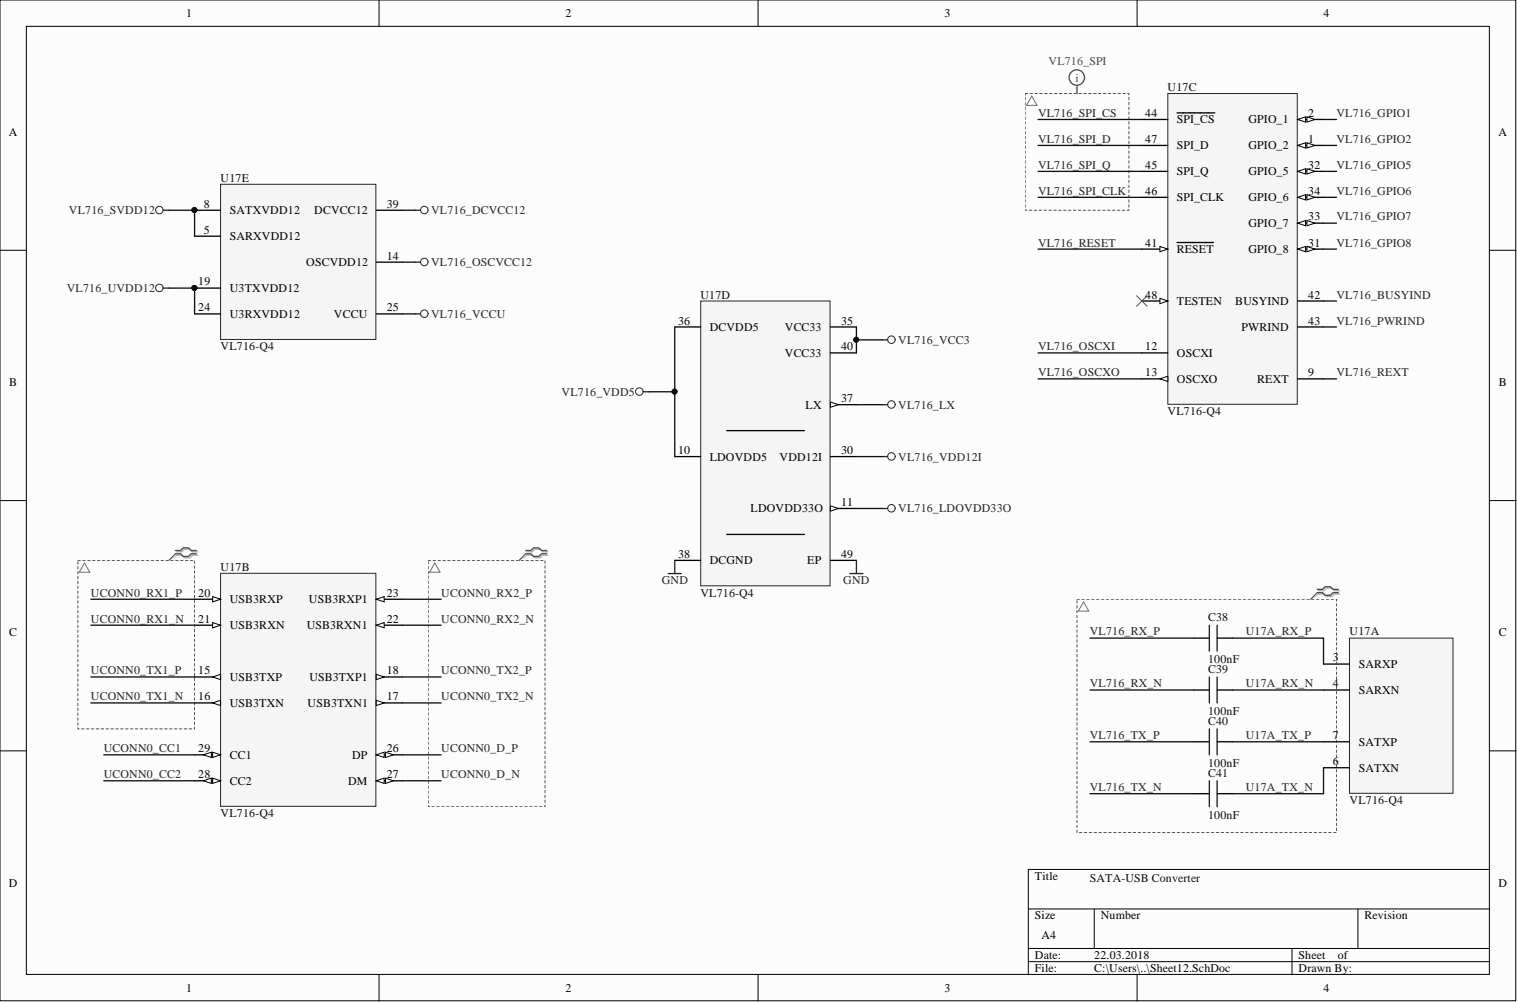
[picture p80: page 4]

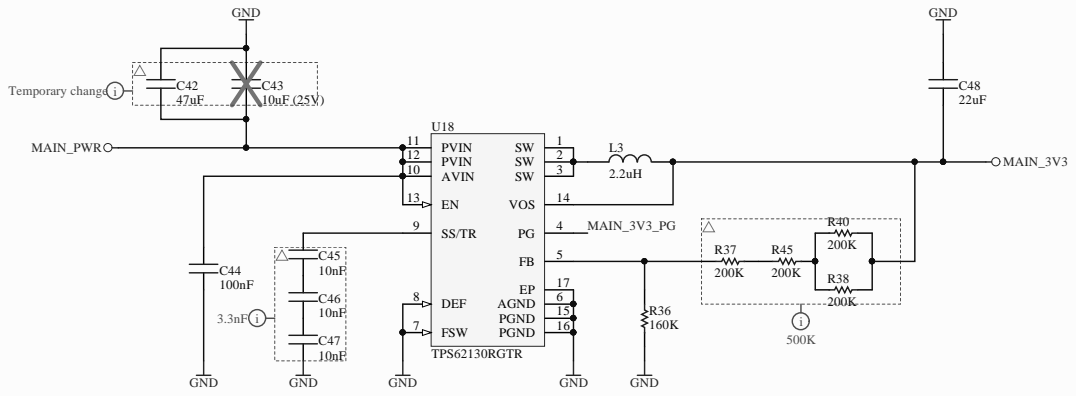
[picture p81: page 5]

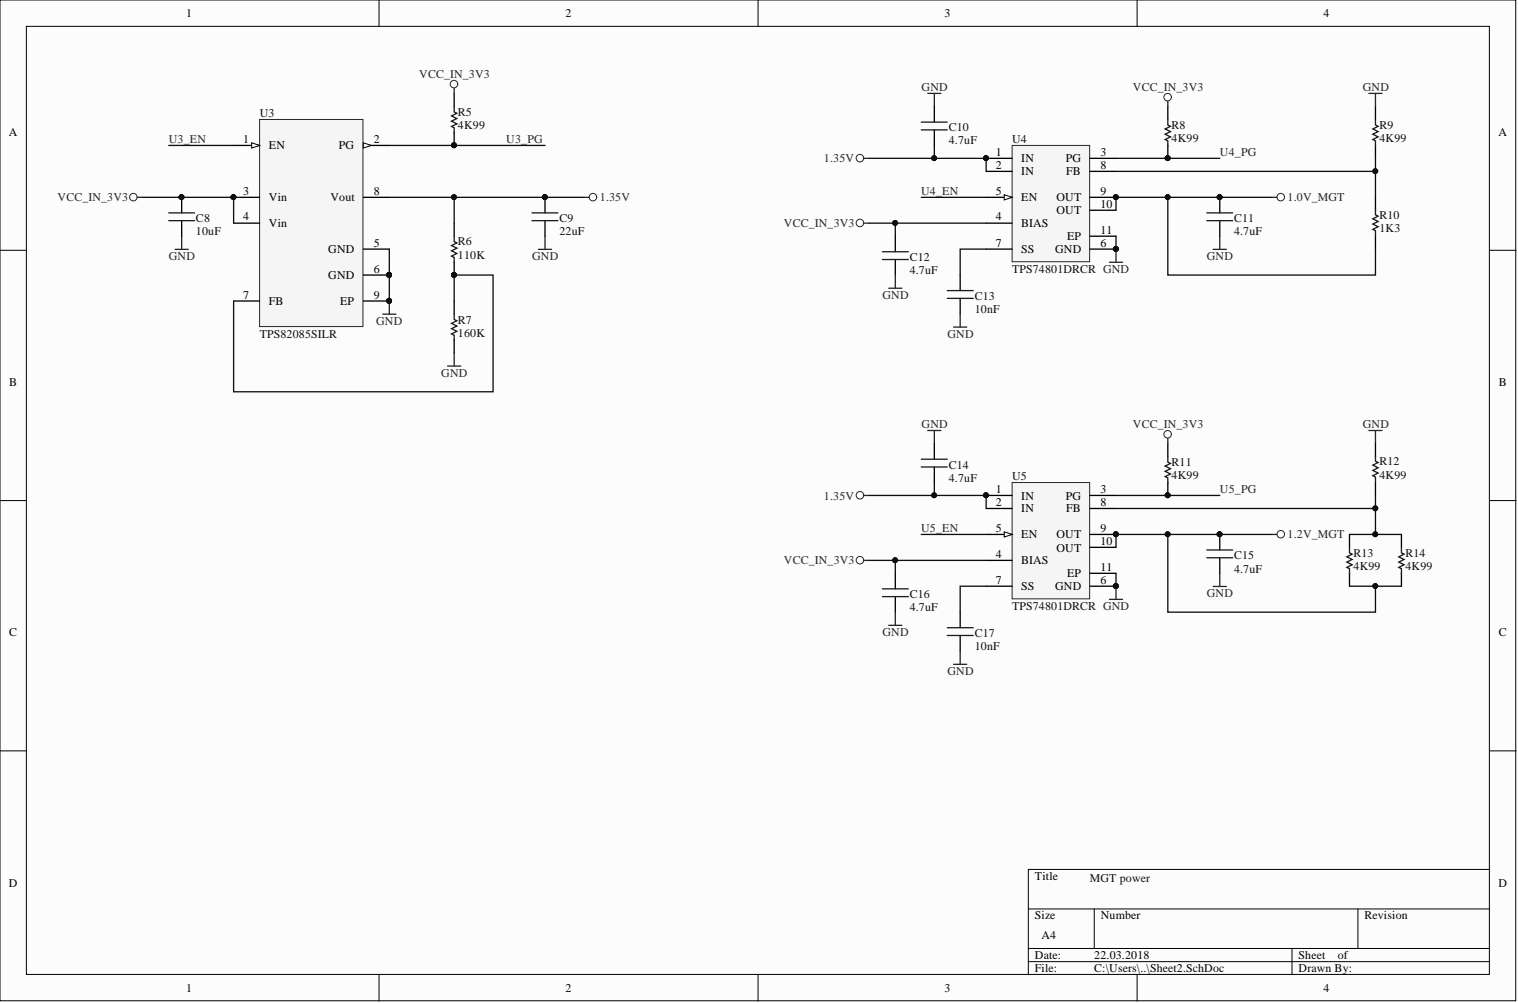
[picture p82: page 6]

1 0 | | | R1 3

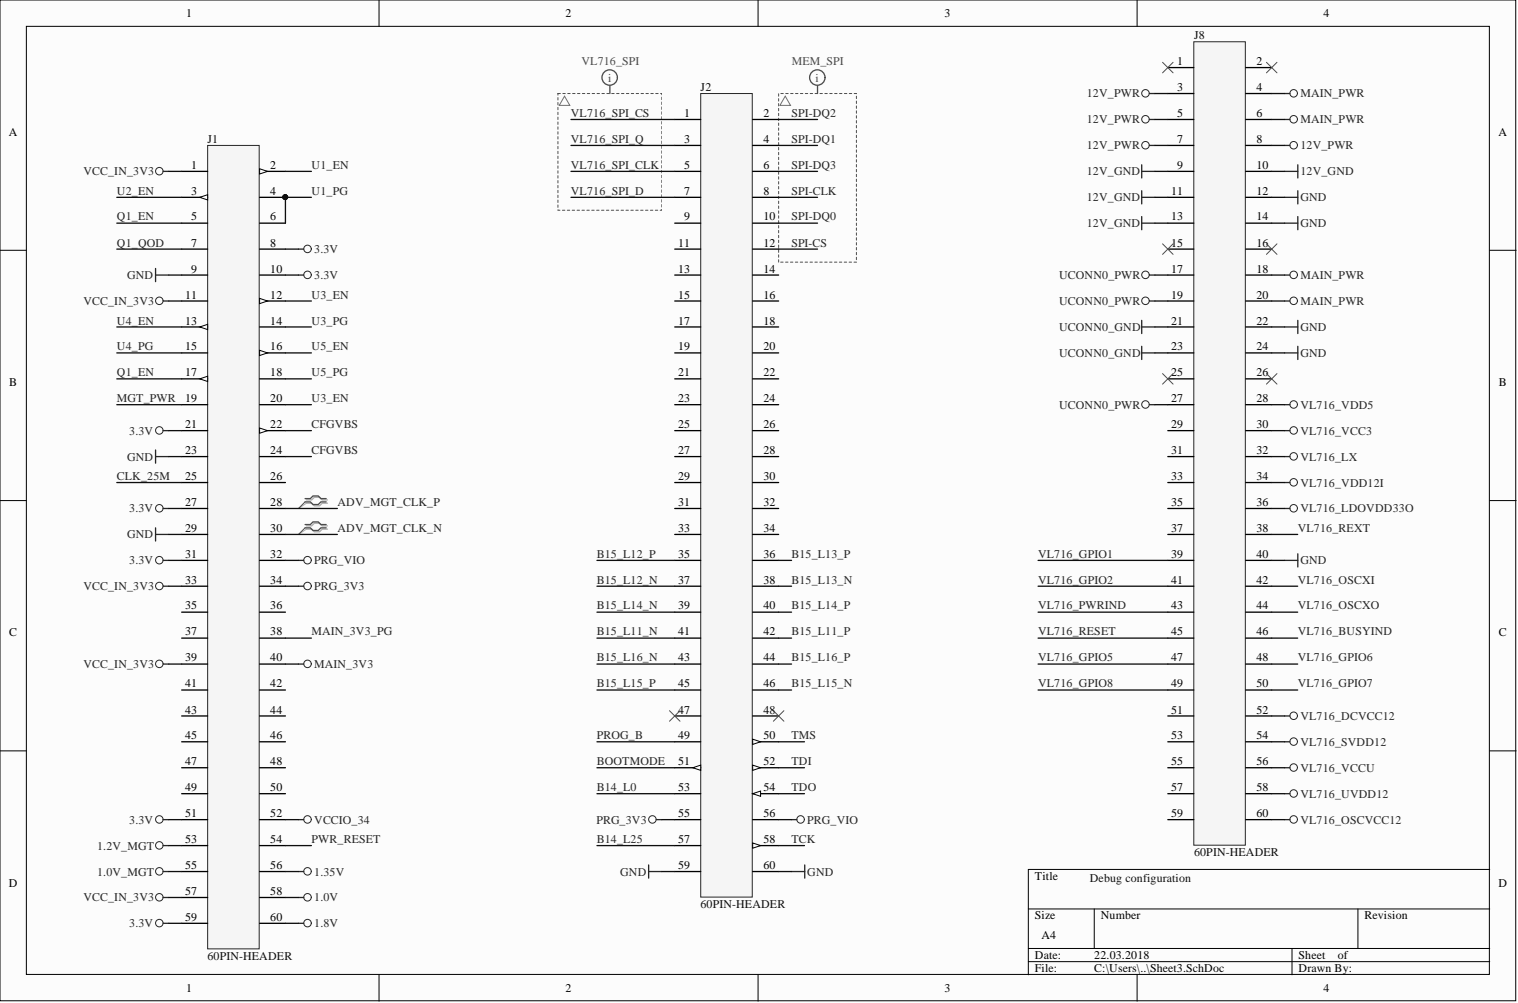
[picture p83: page 7]

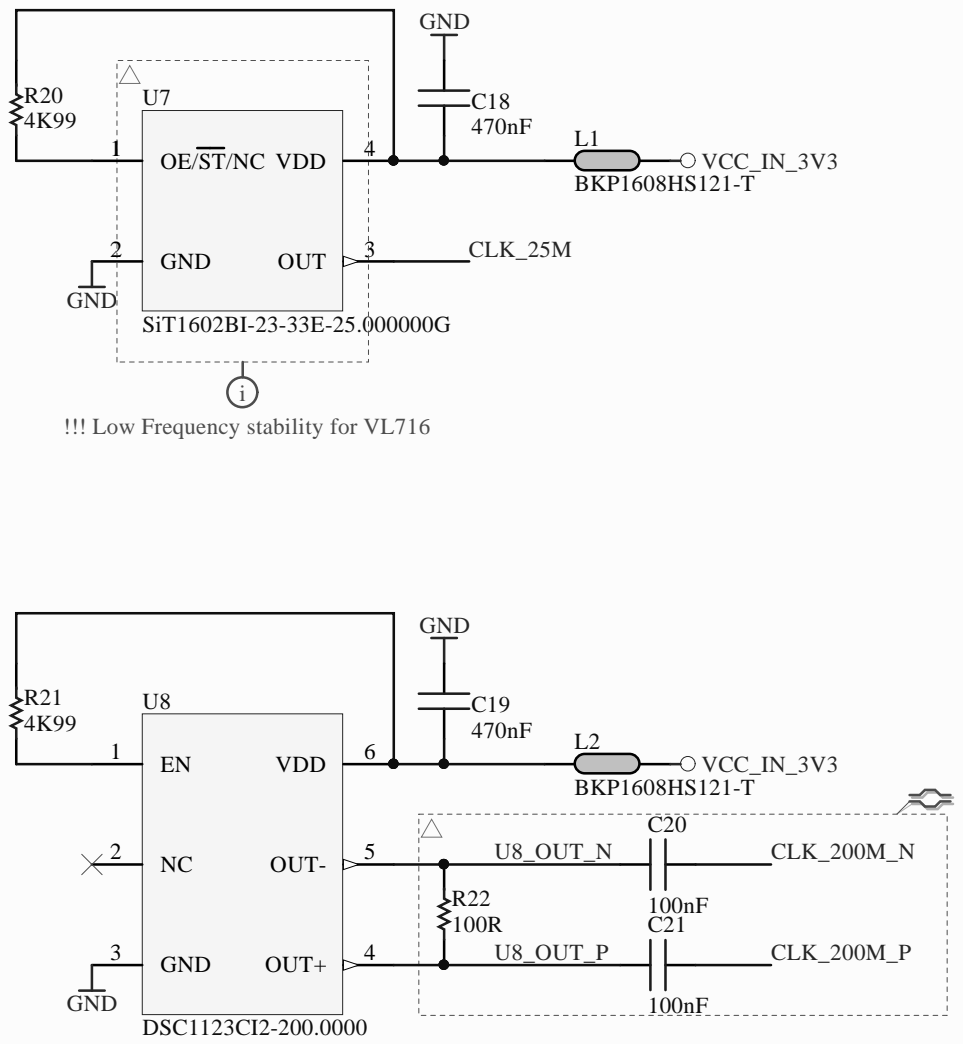
[picture p84: page 8]

!!! Low Frequency stability for VL716

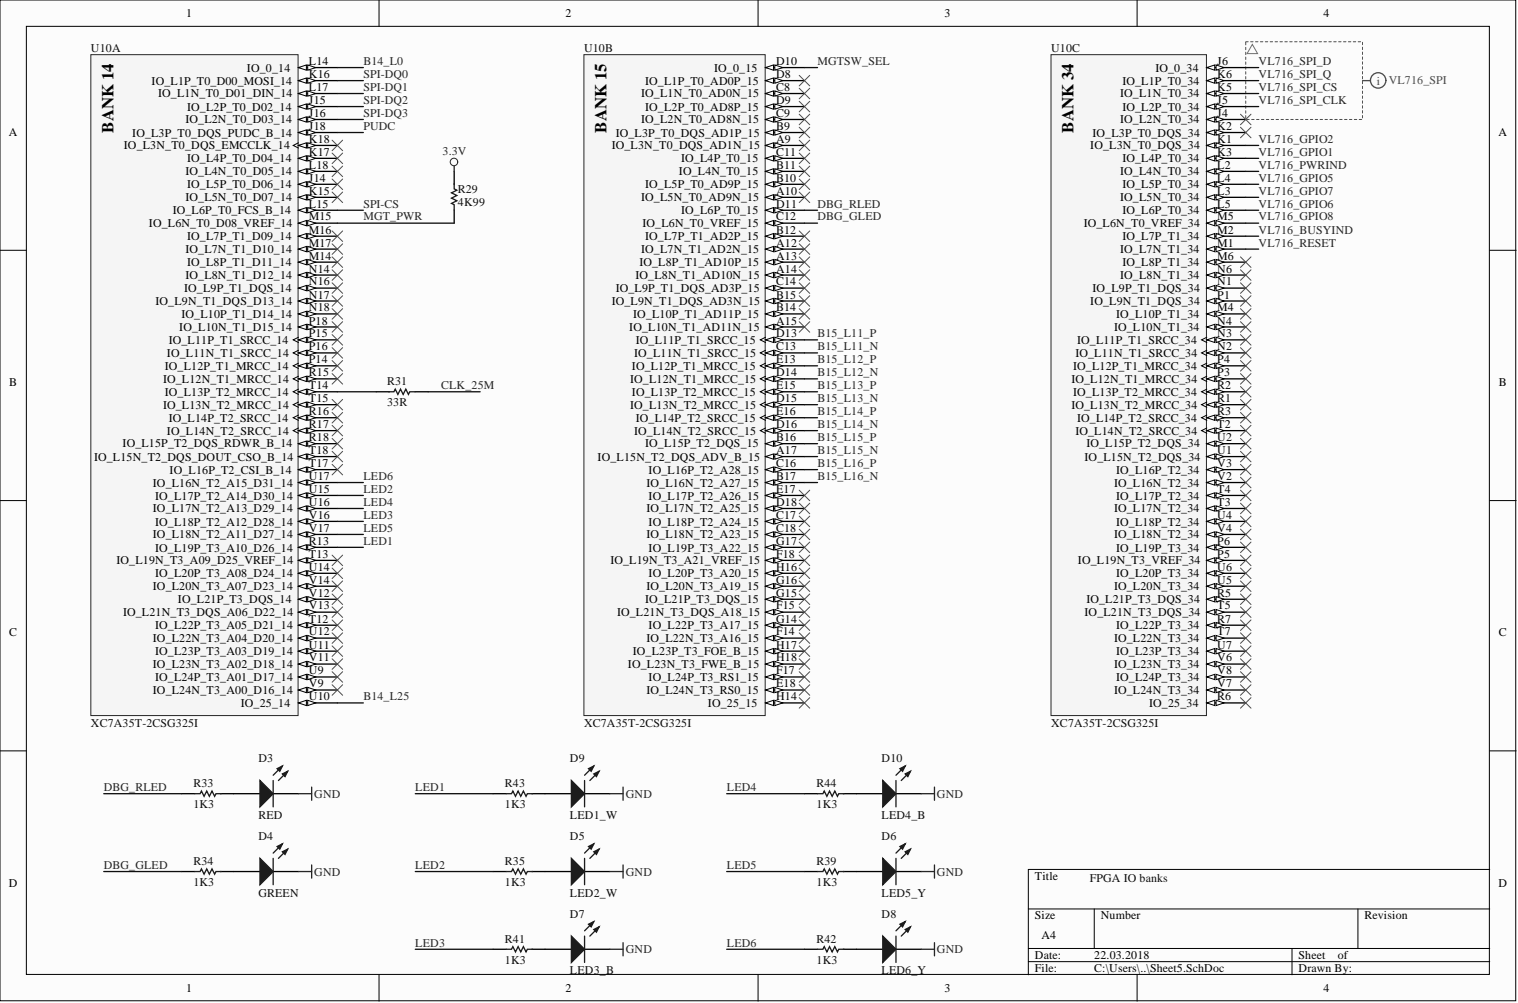
[picture p85: page 9]

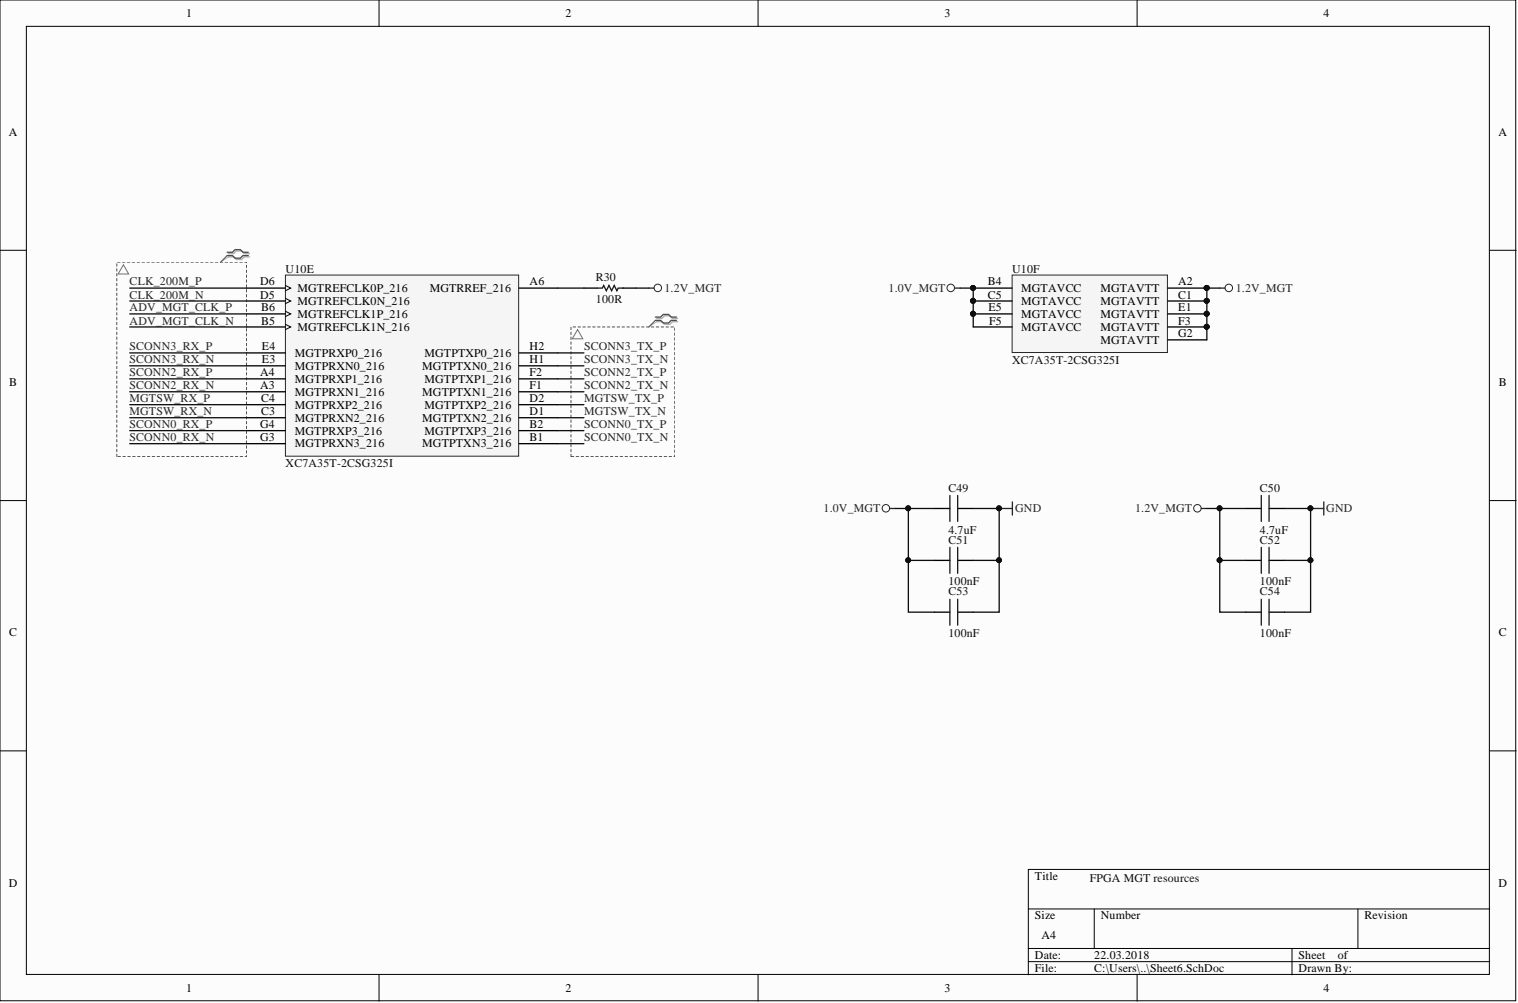
[picture p86: page 10]

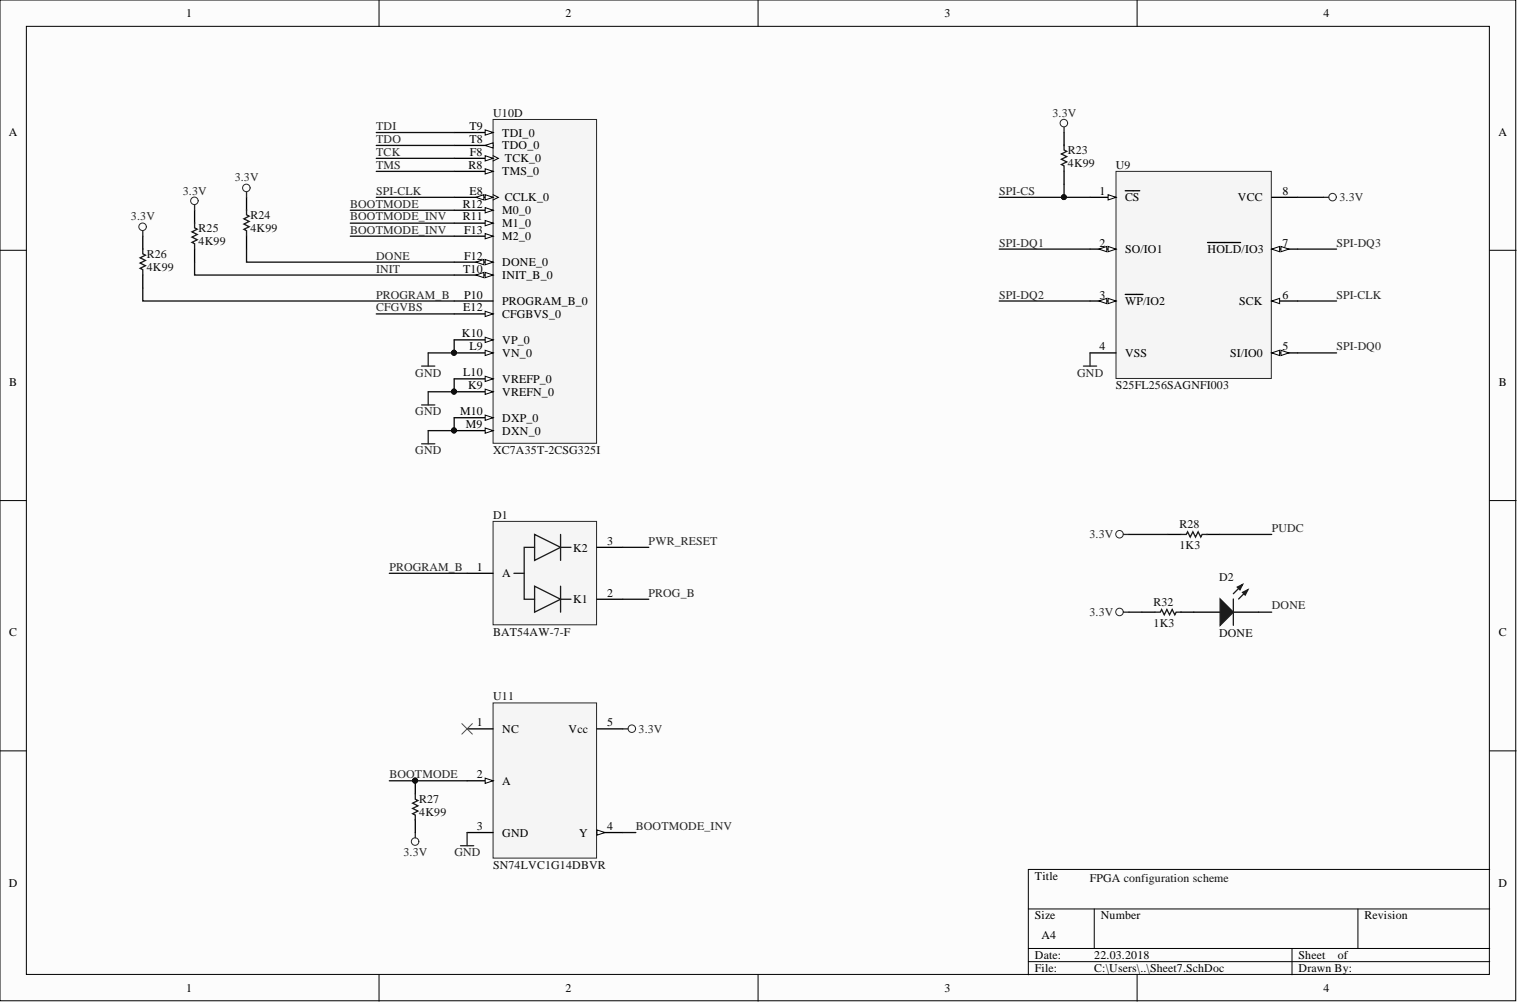
[picture p87: page 11]

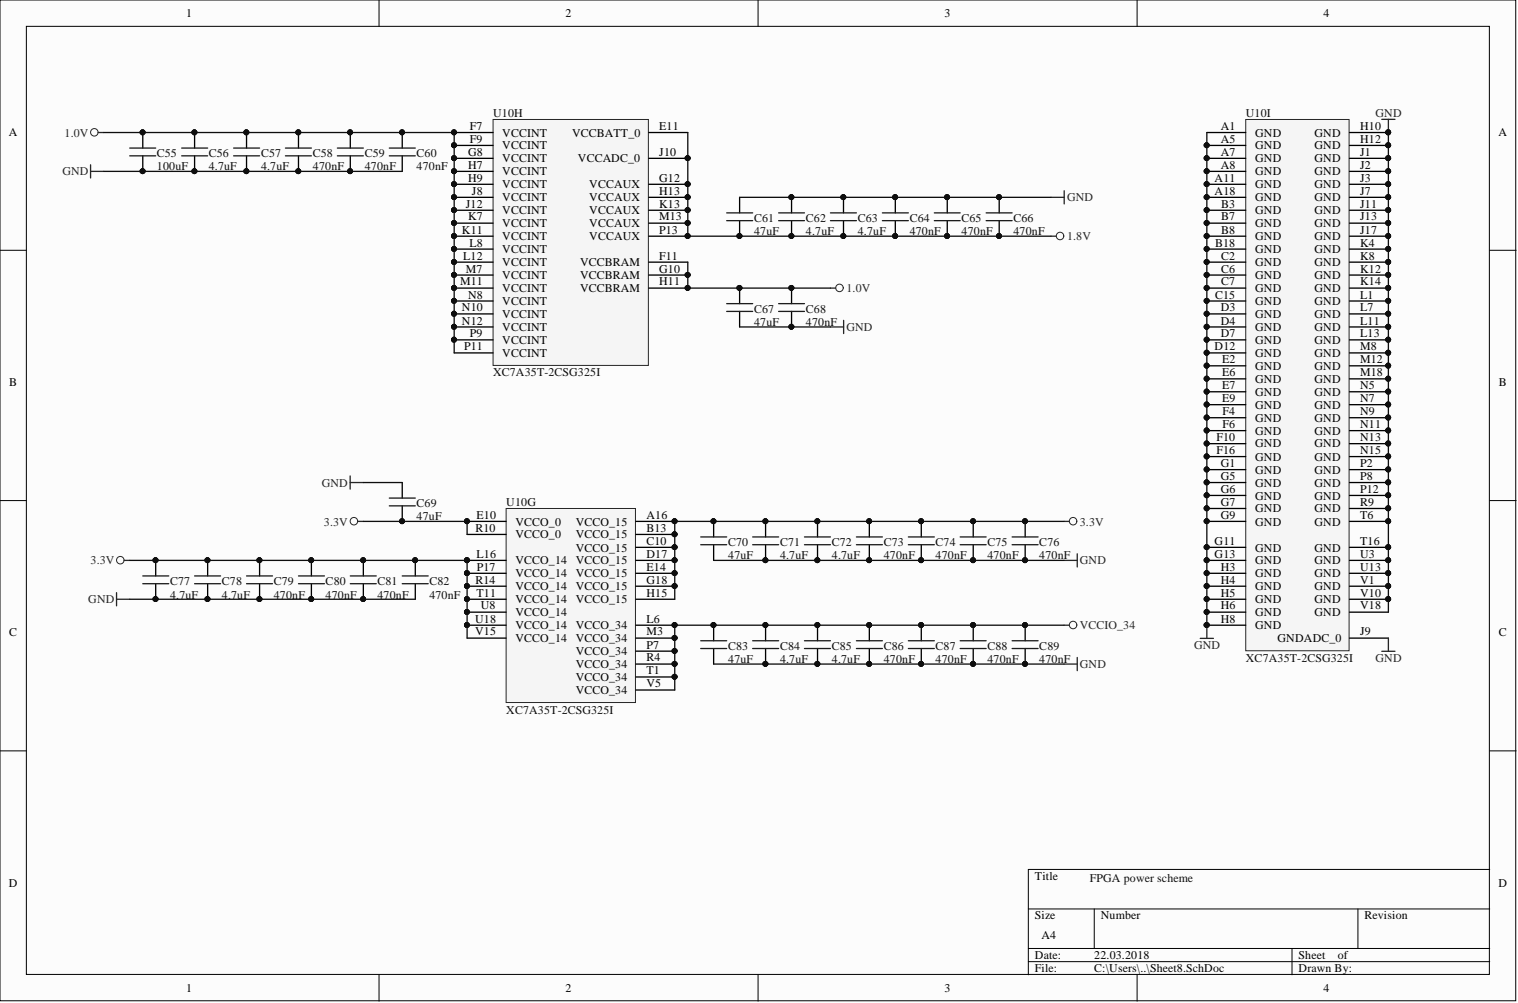
[picture p88: page 12]

E 1 4 | U 1 3
G 1 8 | V 1

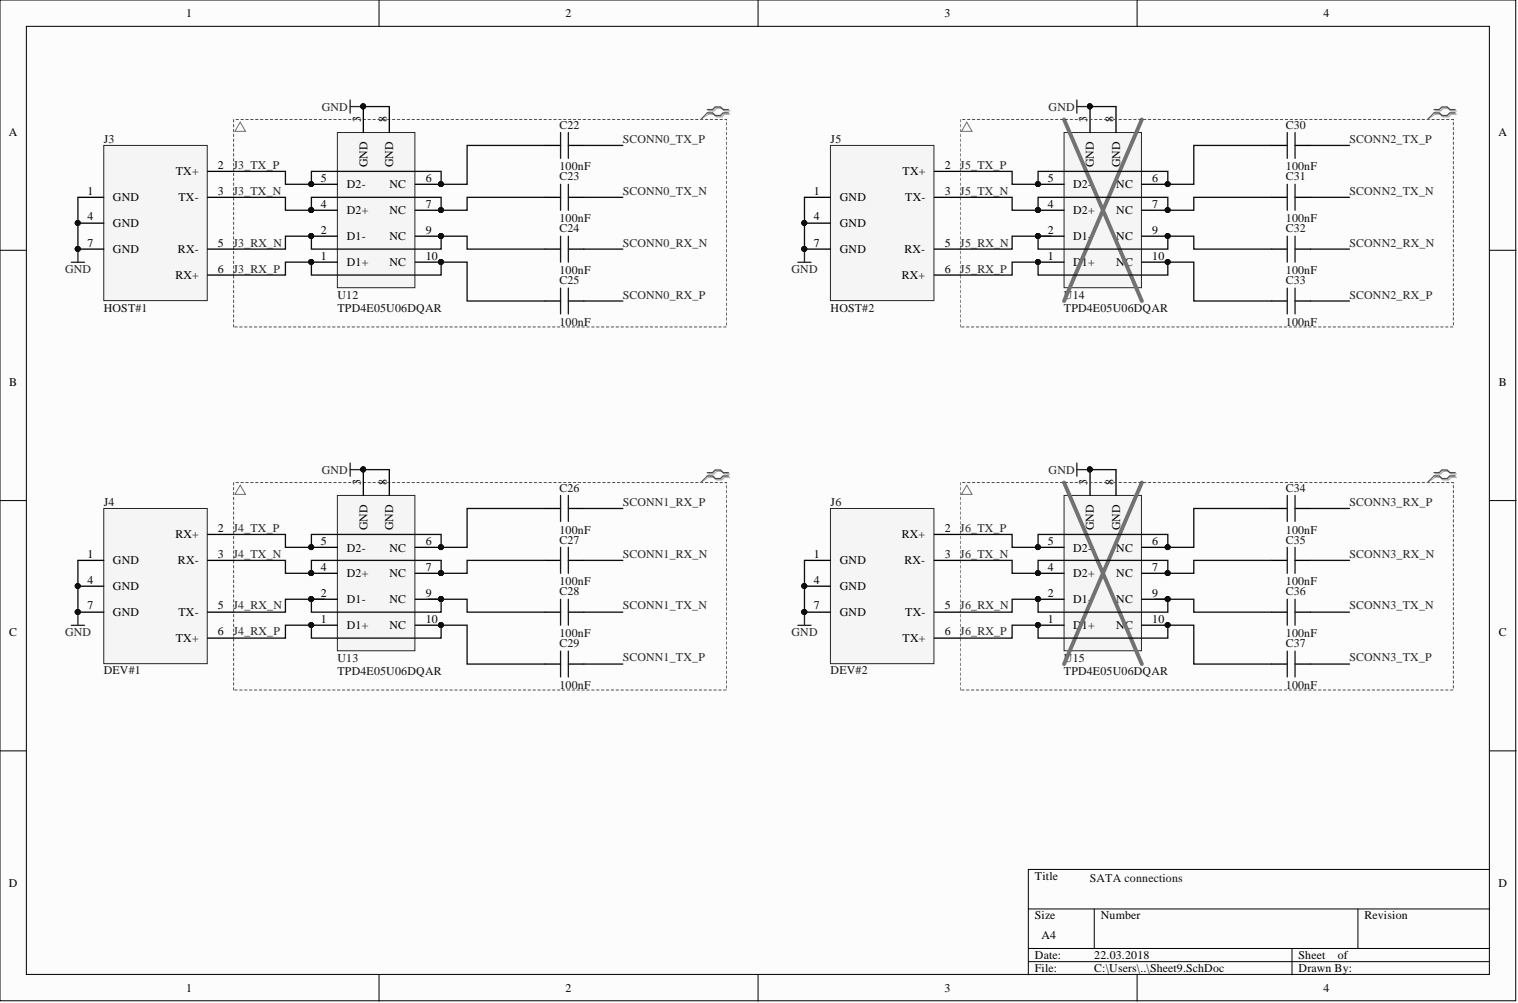
[picture p89: page 13]
