shumov-ag/wp2017/pcb/doc/5607-4200-SH__doc_tech.pdf

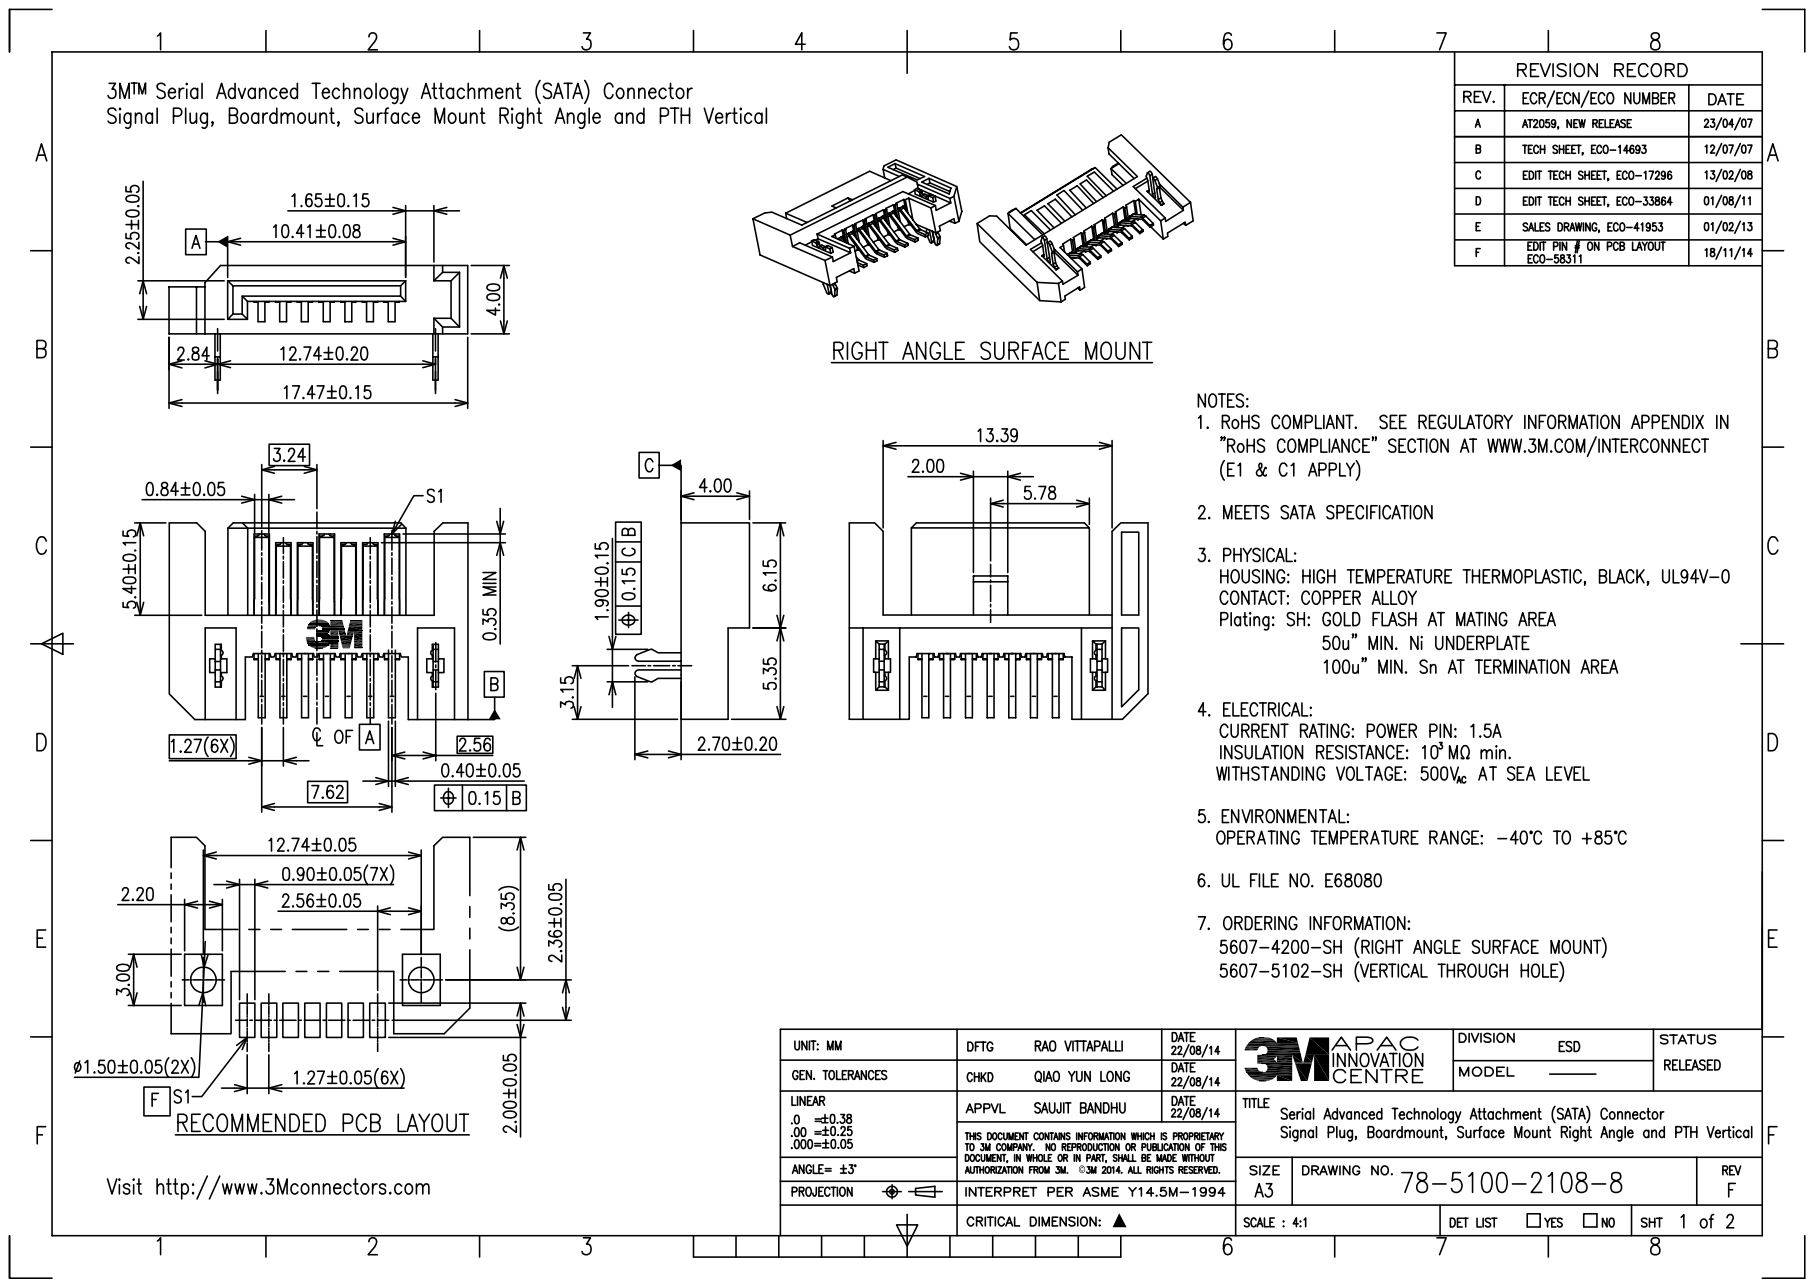
[picture p90: page 1]

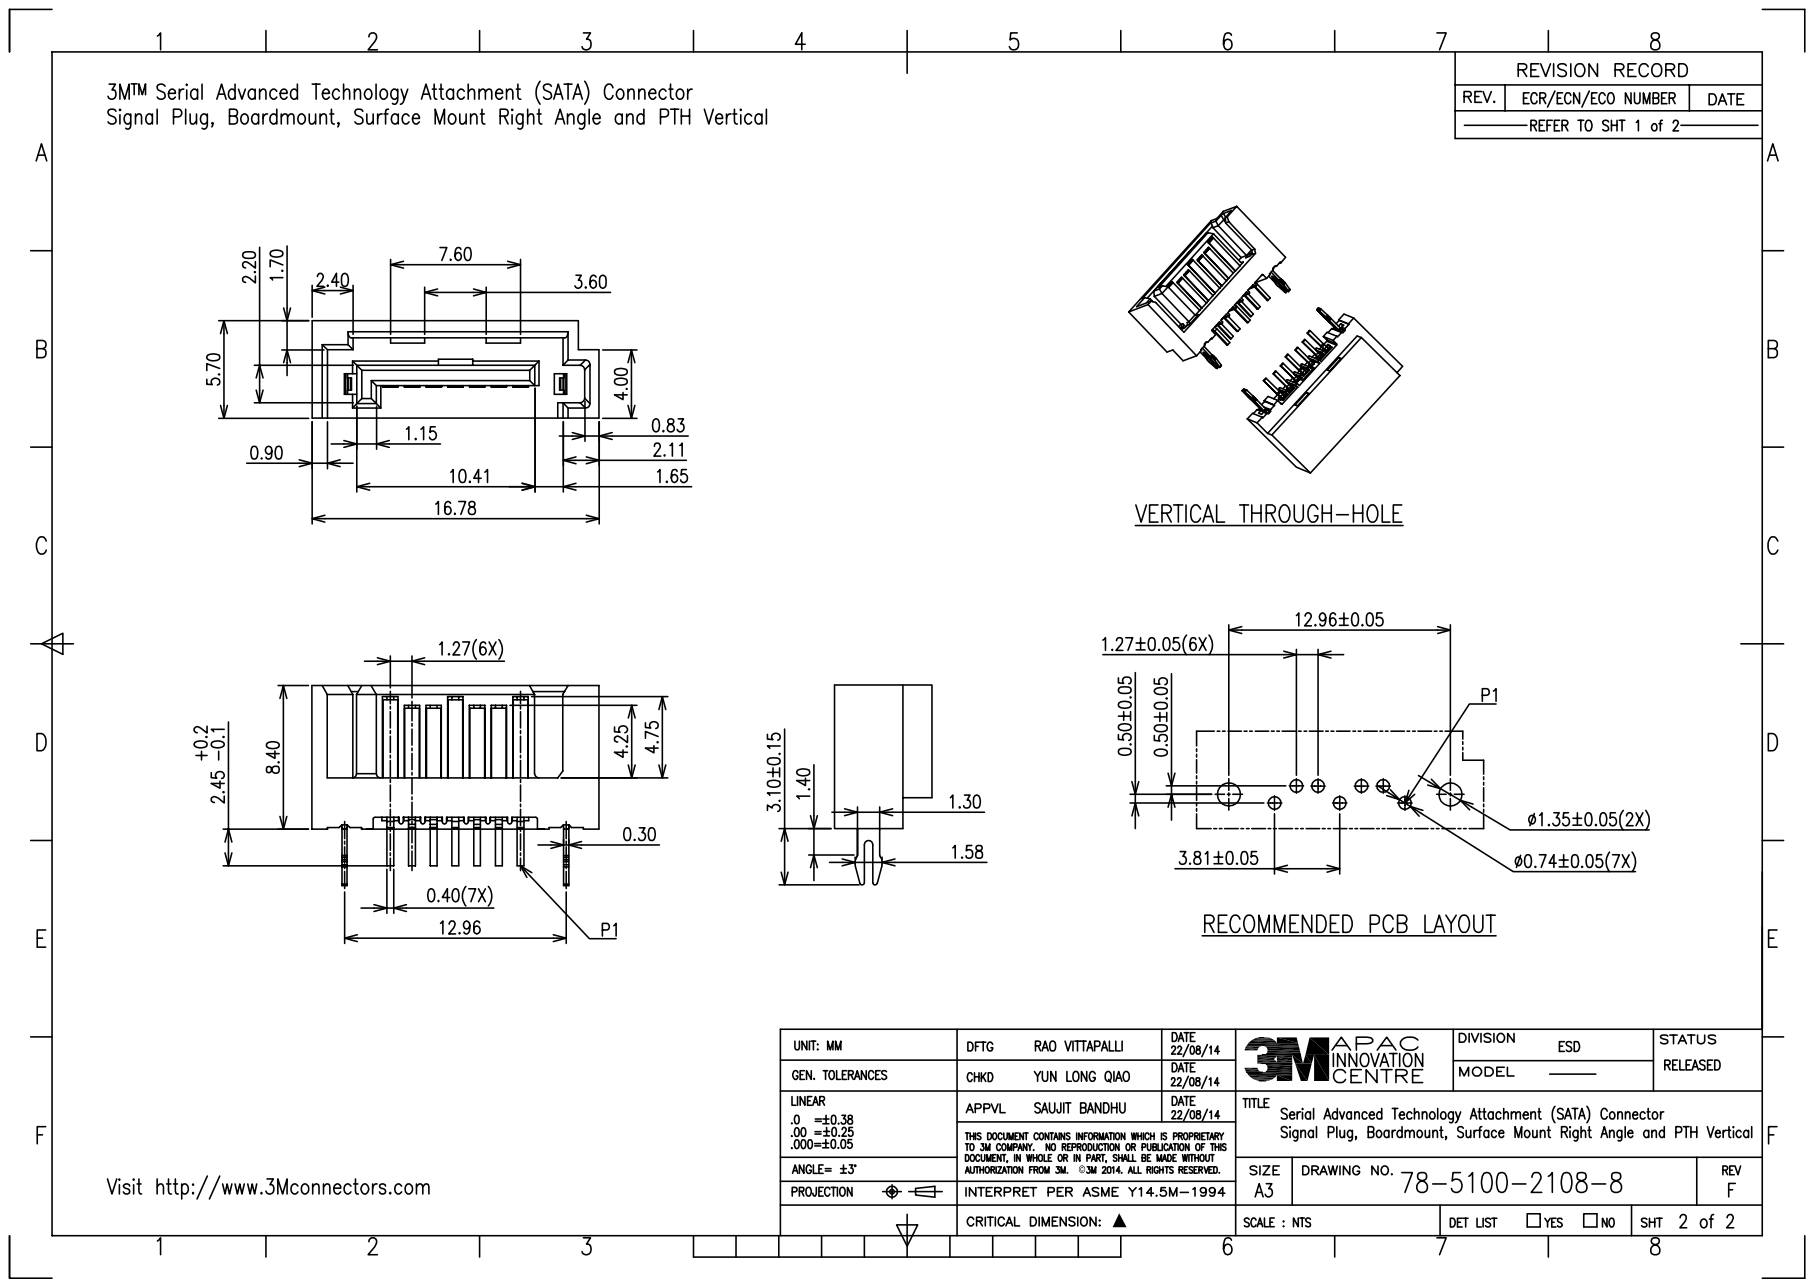
[picture p91: page 2]
