shumov-ag/wp2017/(list of files, drawings)

Other design files:
pcb/prj/pcb_rev01/PCB1.PcbDoc
pcb/prj/pcb_rev01/pcb_rev01.PrjPcb
pcb/prj/pcb_rev01/Sheet1.SchDoc
pcb/prj/pcb_rev01/Sheet2.SchDoc
pcb/prj/pcb_rev01/Sheet3.SchDoc
pcb/prj/pcb_rev01/Sheet4.SchDoc
pcb/prj/pcb_rev01/Sheet5.SchDoc
pcb/prj/pcb_rev01/Sheet6.SchDoc
pcb/prj/pcb_rev01/Sheet7.SchDoc
pcb/prj/pcb_rev01/Sheet8.SchDoc
pcb/prj/pcb_rev01/Sheet9.SchDoc
pcb/prj/pcb_rev01/Sheet10.SchDoc
pcb/prj/pcb_rev01/Sheet11.SchDoc
pcb/prj/pcb_rev01/Sheet12.SchDoc
pcb/prj/pcb_rev01/Sheet13.SchDoc
