shumov-ag/wp2017/src/sata_repeater_gen1/sata_repeater_gen1.srcs/sources_1/ip/gtwizard_0/gtwizard_0_init.v

//------------------------------------------------------------------------------
//   ____  ____
//  /   /\/   /
// /___/  \  /    Vendor: Xilinx
// \   \   \/     Version : 3.6
//  \   \         Application : 7 Series FPGAs Transceivers Wizard 
//  /   /         Filename : gtwizard_0_init.v
// /___/   /\      
// \   \  /  \ 
//  \___\/\___\
//
//  Description : This module instantiates the modules required for
//                reset and initialisation of the Transceiver
//
// Module gtwizard_0_init
// Generated by Xilinx 7 Series FPGAs Transceivers Wizard
// 
// 
// (c) Copyright 2010-2012 Xilinx, Inc. All rights reserved.
// 
// This file contains confidential and proprietary information
// of Xilinx, Inc. and is protected under U.S. and
// international copyright and other intellectual property
// laws.
// 
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
// CRITICAL APPLICATIONS
// Xilinx products are not designed or intended to be fail-
// safe, or for use in any application requiring fail-safe
// performance, such as life-support or safety devices or
// systems, Class III medical devices, nuclear facilities,
// applications related to the deployment of airbags, or any
// other applications that could lead to death, personal
// injury, or severe property or environmental damage
// (individually and collectively, "Critical
// Applications"). Customer assumes the sole risk and
// liability of any use of Xilinx products in Critical
// Applications, subject only to applicable laws and
// regulations governing limitations on product liability.
// 
// THIS COPYRIGHT NOTICE AND DISCLAIMER MUST BE RETAINED AS
// PART OF THIS FILE AT ALL TIMES. 


`timescale 1ns / 1ps
`define DLY #1

//***********************************Entity Declaration************************
(* DowngradeIPIdentifiedWarnings="yes" *)
module gtwizard_0_init #
(
    parameter EXAMPLE_SIM_GTRESET_SPEEDUP            = "FALSE",     // Simulation setting for GT SecureIP model
    parameter EXAMPLE_SIMULATION                     =  0,         // Set to 1 for simulation
    parameter STABLE_CLOCK_PERIOD                    = 40,         //Period of the stable clock driving this state-machine, unit is [ns]
    parameter EXAMPLE_USE_CHIPSCOPE                  =  0          // Set to 1 to use Chipscope to drive resets

)
(
input           sysclk_in,
input           soft_reset_tx_in,
input           soft_reset_rx_in,
input           dont_reset_on_data_error_in,
output          gt0_drp_busy_out,
output          gt0_tx_fsm_reset_done_out,
output          gt0_rx_fsm_reset_done_out,
input           gt0_data_valid_in,
input           gt0_tx_mmcm_lock_in,
output          gt0_tx_mmcm_reset_out,
output          gt1_drp_busy_out,
output          gt1_tx_fsm_reset_done_out,
output          gt1_rx_fsm_reset_done_out,
input           gt1_data_valid_in,
input           gt1_tx_mmcm_lock_in,
output          gt1_tx_mmcm_reset_out,

    //_________________________________________________________________________
    //GT0  (X0Y2)
    //____________________________CHANNEL PORTS________________________________
    //-------------------------- Channel - DRP Ports  --------------------------
    input   [8:0]   gt0_drpaddr_in,
    input           gt0_drpclk_in,
    input   [15:0]  gt0_drpdi_in,
    output  [15:0]  gt0_drpdo_out,
    input           gt0_drpen_in,
    output          gt0_drprdy_out,
    input           gt0_drpwe_in,
    //--------------------------- PCI Express Ports ----------------------------
    input   [2:0]   gt0_rxrate_in,
    //------------------- RX Initialization and Reset Ports --------------------
    input           gt0_eyescanreset_in,
    input           gt0_rxuserrdy_in,
    //------------------------ RX Margin Analysis Ports ------------------------
    output          gt0_eyescandataerror_out,
    input           gt0_eyescantrigger_in,
    //----------------------------- Receive Ports ------------------------------
    input           gt0_sigvalidclk_in,
    //----------------------- Receive Ports - CDR Ports ------------------------
    input           gt0_rxcdrhold_in,
    //---------------- Receive Ports - FPGA RX Interface Ports -----------------
    output  [15:0]  gt0_rxdata_out,
    input           gt0_rxusrclk_in,
    input           gt0_rxusrclk2_in,
    //---------------- Receive Ports - RX 8B/10B Decoder Ports -----------------
    output  [1:0]   gt0_rxchariscomma_out,
    output  [1:0]   gt0_rxcharisk_out,
    output  [1:0]   gt0_rxdisperr_out,
    output  [1:0]   gt0_rxnotintable_out,
    //---------------------- Receive Ports - RX AFE Ports ----------------------
    input           gt0_gtprxn_in,
    input           gt0_gtprxp_in,
    //------------ Receive Ports - RX Byte and Word Alignment Ports ------------
    output          gt0_rxbyteisaligned_out,
    output          gt0_rxbyterealign_out,
    output          gt0_rxcommadet_out,
    //---------- Receive Ports - RX Decision Feedback Equalizer(DFE) -----------
    output  [14:0]  gt0_dmonitorout_out,
    //------------------ Receive Ports - RX Equailizer Ports -------------------
    input           gt0_rxlpmhfhold_in,
    input           gt0_rxlpmhfovrden_in,
    input           gt0_rxlpmlfhold_in,
    //---------- Receive Ports - RX Fabric ClocK Output Control Ports ----------
    output          gt0_rxratedone_out,
    //------------- Receive Ports - RX Fabric Output Control Ports -------------
    output          gt0_rxoutclk_out,
    output          gt0_rxoutclkfabric_out,
    //----------- Receive Ports - RX Initialization and Reset Ports ------------
    input           gt0_gtrxreset_in,
    input           gt0_rxlpmreset_in,
    input           gt0_rxpmareset_in,
    //----------------- Receive Ports - RX OOB Signaling ports -----------------
    output          gt0_rxcomsasdet_out,
    output          gt0_rxcomwakedet_out,
    //---------------- Receive Ports - RX OOB Signaling ports  -----------------
    output          gt0_rxcominitdet_out,
    //---------------- Receive Ports - RX OOB signalling Ports -----------------
    output          gt0_rxelecidle_out,
    //--------------- Receive Ports - RX Polarity Control Ports ----------------
    input           gt0_rxpolarity_in,
    //------------ Receive Ports -RX Initialization and Reset Ports ------------
    output          gt0_rxresetdone_out,
    //------------------- TX Initialization and Reset Ports --------------------
    input           gt0_gttxreset_in,
    input           gt0_txuserrdy_in,
    //---------------- Transmit Ports - FPGA TX Interface Ports ----------------
    input   [15:0]  gt0_txdata_in,
    input           gt0_txusrclk_in,
    input           gt0_txusrclk2_in,
    //------------------- Transmit Ports - PCI Express Ports -------------------
    input           gt0_txelecidle_in,
    input   [2:0]   gt0_txrate_in,
    //---------------- Transmit Ports - TX 8B/10B Encoder Ports ----------------
    input   [1:0]   gt0_txcharisk_in,
    //------------- Transmit Ports - TX Configurable Driver Ports --------------
    output          gt0_gtptxn_out,
    output          gt0_gtptxp_out,
    //--------- Transmit Ports - TX Fabric Clock Output Control Ports ----------
    output          gt0_txoutclk_out,
    output          gt0_txoutclkfabric_out,
    output          gt0_txoutclkpcs_out,
    output          gt0_txratedone_out,
    //----------- Transmit Ports - TX Initialization and Reset Ports -----------
    output          gt0_txresetdone_out,
    //---------------- Transmit Ports - TX OOB signalling Ports ----------------
    output          gt0_txcomfinish_out,
    input           gt0_txcominit_in,
    input           gt0_txcomwake_in,
    //--------------- Transmit Ports - TX Polarity Control Ports ---------------
    input           gt0_txpolarity_in,

    //GT1  (X0Y3)
    //____________________________CHANNEL PORTS________________________________
    //-------------------------- Channel - DRP Ports  --------------------------
    input   [8:0]   gt1_drpaddr_in,
    input           gt1_drpclk_in,
    input   [15:0]  gt1_drpdi_in,
    output  [15:0]  gt1_drpdo_out,
    input           gt1_drpen_in,
    output          gt1_drprdy_out,
    input           gt1_drpwe_in,
    //--------------------------- PCI Express Ports ----------------------------
    input   [2:0]   gt1_rxrate_in,
    //------------------- RX Initialization and Reset Ports --------------------
    input           gt1_eyescanreset_in,
    input           gt1_rxuserrdy_in,
    //------------------------ RX Margin Analysis Ports ------------------------
    output          gt1_eyescandataerror_out,
    input           gt1_eyescantrigger_in,
    //----------------------------- Receive Ports ------------------------------
    input           gt1_sigvalidclk_in,
    //----------------------- Receive Ports - CDR Ports ------------------------
    input           gt1_rxcdrhold_in,
    //---------------- Receive Ports - FPGA RX Interface Ports -----------------
    output  [15:0]  gt1_rxdata_out,
    input           gt1_rxusrclk_in,
    input           gt1_rxusrclk2_in,
    //---------------- Receive Ports - RX 8B/10B Decoder Ports -----------------
    output  [1:0]   gt1_rxchariscomma_out,
    output  [1:0]   gt1_rxcharisk_out,
    output  [1:0]   gt1_rxdisperr_out,
    output  [1:0]   gt1_rxnotintable_out,
    //---------------------- Receive Ports - RX AFE Ports ----------------------
    input           gt1_gtprxn_in,
    input           gt1_gtprxp_in,
    //------------ Receive Ports - RX Byte and Word Alignment Ports ------------
    output          gt1_rxbyteisaligned_out,
    output          gt1_rxbyterealign_out,
    output          gt1_rxcommadet_out,
    //---------- Receive Ports - RX Decision Feedback Equalizer(DFE) -----------
    output  [14:0]  gt1_dmonitorout_out,
    //------------------ Receive Ports - RX Equailizer Ports -------------------
    input           gt1_rxlpmhfhold_in,
    input           gt1_rxlpmhfovrden_in,
    input           gt1_rxlpmlfhold_in,
    //---------- Receive Ports - RX Fabric ClocK Output Control Ports ----------
    output          gt1_rxratedone_out,
    //------------- Receive Ports - RX Fabric Output Control Ports -------------
    output          gt1_rxoutclk_out,
    output          gt1_rxoutclkfabric_out,
    //----------- Receive Ports - RX Initialization and Reset Ports ------------
    input           gt1_gtrxreset_in,
    input           gt1_rxlpmreset_in,
    input           gt1_rxpmareset_in,
    //----------------- Receive Ports - RX OOB Signaling ports -----------------
    output          gt1_rxcomsasdet_out,
    output          gt1_rxcomwakedet_out,
    //---------------- Receive Ports - RX OOB Signaling ports  -----------------
    output          gt1_rxcominitdet_out,
    //---------------- Receive Ports - RX OOB signalling Ports -----------------
    output          gt1_rxelecidle_out,
    //--------------- Receive Ports - RX Polarity Control Ports ----------------
    input           gt1_rxpolarity_in,
    //------------ Receive Ports -RX Initialization and Reset Ports ------------
    output          gt1_rxresetdone_out,
    //------------------- TX Initialization and Reset Ports --------------------
    input           gt1_gttxreset_in,
    input           gt1_txuserrdy_in,
    //---------------- Transmit Ports - FPGA TX Interface Ports ----------------
    input   [15:0]  gt1_txdata_in,
    input           gt1_txusrclk_in,
    input           gt1_txusrclk2_in,
    //------------------- Transmit Ports - PCI Express Ports -------------------
    input           gt1_txelecidle_in,
    input   [2:0]   gt1_txrate_in,
    //---------------- Transmit Ports - TX 8B/10B Encoder Ports ----------------
    input   [1:0]   gt1_txcharisk_in,
    //------------- Transmit Ports - TX Configurable Driver Ports --------------
    output          gt1_gtptxn_out,
    output          gt1_gtptxp_out,
    //--------- Transmit Ports - TX Fabric Clock Output Control Ports ----------
    output          gt1_txoutclk_out,
    output          gt1_txoutclkfabric_out,
    output          gt1_txoutclkpcs_out,
    output          gt1_txratedone_out,
    //----------- Transmit Ports - TX Initialization and Reset Ports -----------
    output          gt1_txresetdone_out,
    //---------------- Transmit Ports - TX OOB signalling Ports ----------------
    output          gt1_txcomfinish_out,
    input           gt1_txcominit_in,
    input           gt1_txcomwake_in,
    //--------------- Transmit Ports - TX Polarity Control Ports ---------------
    input           gt1_txpolarity_in,


    //____________________________COMMON PORTS________________________________
   output     gt0_pll0reset_out,
    input          gt0_pll0outclk_in,
    input          gt0_pll0outrefclk_in,
    input          gt0_pll0lock_in,
    input          gt0_pll0refclklost_in,    
    input          gt0_pll1outclk_in,
    input          gt0_pll1outrefclk_in

);



//***********************************Parameter Declarations********************


    //Typical CDRLOCK Time is 50,000UI, as per DS183
    localparam RX_CDRLOCK_TIME      = (EXAMPLE_SIMULATION == 1) ? 1000 : 100000/1.5;
       
    localparam integer   WAIT_TIME_CDRLOCK    = RX_CDRLOCK_TIME / STABLE_CLOCK_PERIOD;      

//-------------------------- GT Wrapper Wires ------------------------------
    wire           gt0_rxpmaresetdone_i;
    wire           gt0_txpmaresetdone_i;
    wire           gt0_txresetdone_i;
    wire           gt0_txresetdone_ii;
    wire           gt0_rxresetdone_i;
    wire           gt0_rxresetdone_ii;
    wire           gt0_gttxreset_i;
    wire           gt0_gttxreset_t;
    wire           gt0_gtrxreset_i;
    wire           gt0_gtrxreset_t;
    wire           gt0_txuserrdy_i;
    wire           gt0_txuserrdy_t;
    wire           gt0_rxuserrdy_i;
    wire           gt0_rxuserrdy_t;



    wire           gt1_rxpmaresetdone_i;
    wire           gt1_txpmaresetdone_i;
    wire           gt1_txresetdone_i;
    wire           gt1_txresetdone_ii;
    wire           gt1_rxresetdone_i;
    wire           gt1_rxresetdone_ii;
    wire           gt1_gttxreset_i;
    wire           gt1_gttxreset_t;
    wire           gt1_gtrxreset_i;
    wire           gt1_gtrxreset_t;
    wire           gt1_txuserrdy_i;
    wire           gt1_txuserrdy_t;
    wire           gt1_rxuserrdy_i;
    wire           gt1_rxuserrdy_t;




    wire           gt0_pll0reset_i;
    wire           gt0_pll0reset_t;
    wire           gt0_pll0refclklost_i;
    wire           gt0_pll0lock_i;


//------------------------------- Global Signals -----------------------------
    wire          tied_to_ground_i;
    wire          tied_to_vcc_i;

    wire           gt0_txoutclk_i;
    wire           gt0_rxoutclk_i;
    wire           gt0_rxoutclk_i2;
    wire           gt0_txoutclk_i2;
    wire           gt0_recclk_stable_i;
    reg            gt0_rx_cdrlocked;
    integer  gt0_rx_cdrlock_counter= 0;

    wire           gt1_txoutclk_i;
    wire           gt1_rxoutclk_i;
    wire           gt1_rxoutclk_i2;
    wire           gt1_txoutclk_i2;
    wire           gt1_recclk_stable_i;
    reg            gt1_rx_cdrlocked;
    integer  gt1_rx_cdrlock_counter= 0;







reg              rx_cdrlocked;


 


//**************************** Main Body of Code *******************************
    //  Static signal Assigments
assign  tied_to_ground_i                     =  1'b0;
assign  tied_to_vcc_i                        =  1'b1;

//    ----------------------------- The GT Wrapper -----------------------------
    
    // Use the instantiation template in the example directory to add the GT wrapper to your design.
    // In this example, the wrapper is wired up for basic operation with a frame generator and frame 
    // checker. The GTs will reset, then attempt to align and transmit data. If channel bonding is 
    // enabled, bonding should occur after alignment.


    gtwizard_0_multi_gt #
    (
        .EXAMPLE_SIMULATION             (EXAMPLE_SIMULATION),
        .WRAPPER_SIM_GTRESET_SPEEDUP    (EXAMPLE_SIM_GTRESET_SPEEDUP)
    )
    gtwizard_0_i
    (
        .gt0_drp_busy_out               (gt0_drp_busy_out),
        .gt0_rxpmaresetdone_out         (gt0_rxpmaresetdone_i),
        .gt0_txpmaresetdone_out         (gt0_txpmaresetdone_i),
 
        //_____________________________________________________________________
        //_____________________________________________________________________
        //GT0  (X0Y2)

        //-------------------------- Channel - DRP Ports  --------------------------
        .gt0_drpaddr_in                 (gt0_drpaddr_in), // input wire [8:0] gt0_drpaddr_in
        .gt0_drpclk_in                  (gt0_drpclk_in), // input wire gt0_drpclk_in
        .gt0_drpdi_in                   (gt0_drpdi_in), // input wire [15:0] gt0_drpdi_in
        .gt0_drpdo_out                  (gt0_drpdo_out), // output wire [15:0] gt0_drpdo_out
        .gt0_drpen_in                   (gt0_drpen_in), // input wire gt0_drpen_in
        .gt0_drprdy_out                 (gt0_drprdy_out), // output wire gt0_drprdy_out
        .gt0_drpwe_in                   (gt0_drpwe_in), // input wire gt0_drpwe_in
        //--------------------------- PCI Express Ports ----------------------------
        .gt0_rxrate_in                  (gt0_rxrate_in), // input wire [2:0] gt0_rxrate_in
        //------------------- RX Initialization and Reset Ports --------------------
        .gt0_eyescanreset_in            (gt0_eyescanreset_in), // input wire gt0_eyescanreset_in
        .gt0_rxuserrdy_in               (gt0_rxuserrdy_i), // input wire gt0_rxuserrdy_i
        //------------------------ RX Margin Analysis Ports ------------------------
        .gt0_eyescandataerror_out       (gt0_eyescandataerror_out), // output wire gt0_eyescandataerror_out
        .gt0_eyescantrigger_in          (gt0_eyescantrigger_in), // input wire gt0_eyescantrigger_in
        //----------------------------- Receive Ports ------------------------------
        .gt0_sigvalidclk_in             (gt0_sigvalidclk_in), // input wire gt0_sigvalidclk_in
        //----------------------- Receive Ports - CDR Ports ------------------------
        .gt0_rxcdrhold_in               (gt0_rxcdrhold_in), // input wire gt0_rxcdrhold_in
        //---------------- Receive Ports - FPGA RX Interface Ports -----------------
        .gt0_rxdata_out                 (gt0_rxdata_out), // output wire [15:0] gt0_rxdata_out
        .gt0_rxusrclk_in                (gt0_rxusrclk_in), // input wire gt0_rxusrclk_in
        .gt0_rxusrclk2_in               (gt0_rxusrclk2_in), // input wire gt0_rxusrclk2_in
        //---------------- Receive Ports - RX 8B/10B Decoder Ports -----------------
        .gt0_rxchariscomma_out          (gt0_rxchariscomma_out), // output wire [1:0] gt0_rxchariscomma_out
        .gt0_rxcharisk_out              (gt0_rxcharisk_out), // output wire [1:0] gt0_rxcharisk_out
        .gt0_rxdisperr_out              (gt0_rxdisperr_out), // output wire [1:0] gt0_rxdisperr_out
        .gt0_rxnotintable_out           (gt0_rxnotintable_out), // output wire [1:0] gt0_rxnotintable_out
        //---------------------- Receive Ports - RX AFE Ports ----------------------
        .gt0_gtprxn_in                  (gt0_gtprxn_in), // input wire gt0_gtprxn_in
        .gt0_gtprxp_in                  (gt0_gtprxp_in), // input wire gt0_gtprxp_in
        //------------ Receive Ports - RX Byte and Word Alignment Ports ------------
        .gt0_rxbyteisaligned_out        (gt0_rxbyteisaligned_out), // output wire gt0_rxbyteisaligned_out
        .gt0_rxbyterealign_out          (gt0_rxbyterealign_out), // output wire gt0_rxbyterealign_out
        .gt0_rxcommadet_out             (gt0_rxcommadet_out), // output wire gt0_rxcommadet_out
        //---------- Receive Ports - RX Decision Feedback Equalizer(DFE) -----------
        .gt0_dmonitorout_out            (gt0_dmonitorout_out), // output wire [14:0] gt0_dmonitorout_out
        //------------------ Receive Ports - RX Equailizer Ports -------------------
        .gt0_rxlpmhfhold_in             (gt0_rxlpmhfhold_in), // input wire gt0_rxlpmhfhold_in
        .gt0_rxlpmhfovrden_in           (gt0_rxlpmhfovrden_in), // input wire gt0_rxlpmhfovrden_in
        .gt0_rxlpmlfhold_in             (gt0_rxlpmlfhold_in), // input wire gt0_rxlpmlfhold_in
        //---------- Receive Ports - RX Fabric ClocK Output Control Ports ----------
        .gt0_rxratedone_out             (gt0_rxratedone_out), // output wire gt0_rxratedone_out
        //------------- Receive Ports - RX Fabric Output Control Ports -------------
        .gt0_rxoutclk_out               (gt0_rxoutclk_i), // output wire gt0_rxoutclk_i
        .gt0_rxoutclkfabric_out         (gt0_rxoutclkfabric_out), // output wire gt0_rxoutclkfabric_out
        //----------- Receive Ports - RX Initialization and Reset Ports ------------
        .gt0_gtrxreset_in               (gt0_gtrxreset_i), // input wire gt0_gtrxreset_i
        .gt0_rxlpmreset_in              (gt0_rxlpmreset_in), // input wire gt0_rxlpmreset_in
        .gt0_rxpmareset_in              (gt0_rxpmareset_in), // input wire gt0_rxpmareset_in
        //----------------- Receive Ports - RX OOB Signaling ports -----------------
        .gt0_rxcomsasdet_out            (gt0_rxcomsasdet_out), // output wire gt0_rxcomsasdet_out
        .gt0_rxcomwakedet_out           (gt0_rxcomwakedet_out), // output wire gt0_rxcomwakedet_out
        //---------------- Receive Ports - RX OOB Signaling ports  -----------------
        .gt0_rxcominitdet_out           (gt0_rxcominitdet_out), // output wire gt0_rxcominitdet_out
        //---------------- Receive Ports - RX OOB signalling Ports -----------------
        .gt0_rxelecidle_out             (gt0_rxelecidle_out), // output wire gt0_rxelecidle_out
        //--------------- Receive Ports - RX Polarity Control Ports ----------------
        .gt0_rxpolarity_in              (gt0_rxpolarity_in), // input wire gt0_rxpolarity_in
        //------------ Receive Ports -RX Initialization and Reset Ports ------------
        .gt0_rxresetdone_out            (gt0_rxresetdone_i), // output wire gt0_rxresetdone_i
        //------------------- TX Initialization and Reset Ports --------------------
        .gt0_gttxreset_in               (gt0_gttxreset_i), // input wire gt0_gttxreset_i
        .gt0_txuserrdy_in               (gt0_txuserrdy_i), // input wire gt0_txuserrdy_i
        //---------------- Transmit Ports - FPGA TX Interface Ports ----------------
        .gt0_txdata_in                  (gt0_txdata_in), // input wire [15:0] gt0_txdata_in
        .gt0_txusrclk_in                (gt0_txusrclk_in), // input wire gt0_txusrclk_in
        .gt0_txusrclk2_in               (gt0_txusrclk2_in), // input wire gt0_txusrclk2_in
        //------------------- Transmit Ports - PCI Express Ports -------------------
        .gt0_txelecidle_in              (gt0_txelecidle_in), // input wire gt0_txelecidle_in
        .gt0_txrate_in                  (gt0_txrate_in), // input wire [2:0] gt0_txrate_in
        //---------------- Transmit Ports - TX 8B/10B Encoder Ports ----------------
        .gt0_txcharisk_in               (gt0_txcharisk_in), // input wire [1:0] gt0_txcharisk_in
        //------------- Transmit Ports - TX Configurable Driver Ports --------------
        .gt0_gtptxn_out                 (gt0_gtptxn_out), // output wire gt0_gtptxn_out
        .gt0_gtptxp_out                 (gt0_gtptxp_out), // output wire gt0_gtptxp_out
        //--------- Transmit Ports - TX Fabric Clock Output Control Ports ----------
        .gt0_txoutclk_out               (gt0_txoutclk_i), // output wire gt0_txoutclk_i
        .gt0_txoutclkfabric_out         (gt0_txoutclkfabric_out), // output wire gt0_txoutclkfabric_out
        .gt0_txoutclkpcs_out            (gt0_txoutclkpcs_out), // output wire gt0_txoutclkpcs_out
        .gt0_txratedone_out             (gt0_txratedone_out), // output wire gt0_txratedone_out
        //----------- Transmit Ports - TX Initialization and Reset Ports -----------
        .gt0_txresetdone_out            (gt0_txresetdone_i), // output wire gt0_txresetdone_i
        //---------------- Transmit Ports - TX OOB signalling Ports ----------------
        .gt0_txcomfinish_out            (gt0_txcomfinish_out), // output wire gt0_txcomfinish_out
        .gt0_txcominit_in               (gt0_txcominit_in), // input wire gt0_txcominit_in
        .gt0_txcomwake_in               (gt0_txcomwake_in), // input wire gt0_txcomwake_in
        //--------------- Transmit Ports - TX Polarity Control Ports ---------------
        .gt0_txpolarity_in              (gt0_txpolarity_in), // input wire gt0_txpolarity_in


        .gt1_drp_busy_out               (gt1_drp_busy_out),
        .gt1_rxpmaresetdone_out         (gt1_rxpmaresetdone_i),
        .gt1_txpmaresetdone_out         (gt1_txpmaresetdone_i),
 
        //_____________________________________________________________________
        //_____________________________________________________________________
        //GT1  (X0Y3)

        //-------------------------- Channel - DRP Ports  --------------------------
        .gt1_drpaddr_in                 (gt1_drpaddr_in), // input wire [8:0] gt1_drpaddr_in
        .gt1_drpclk_in                  (gt1_drpclk_in), // input wire gt1_drpclk_in
        .gt1_drpdi_in                   (gt1_drpdi_in), // input wire [15:0] gt1_drpdi_in
        .gt1_drpdo_out                  (gt1_drpdo_out), // output wire [15:0] gt1_drpdo_out
        .gt1_drpen_in                   (gt1_drpen_in), // input wire gt1_drpen_in
        .gt1_drprdy_out                 (gt1_drprdy_out), // output wire gt1_drprdy_out
        .gt1_drpwe_in                   (gt1_drpwe_in), // input wire gt1_drpwe_in
        //--------------------------- PCI Express Ports ----------------------------
        .gt1_rxrate_in                  (gt1_rxrate_in), // input wire [2:0] gt1_rxrate_in
        //------------------- RX Initialization and Reset Ports --------------------
        .gt1_eyescanreset_in            (gt1_eyescanreset_in), // input wire gt1_eyescanreset_in
        .gt1_rxuserrdy_in               (gt1_rxuserrdy_i), // input wire gt1_rxuserrdy_i
        //------------------------ RX Margin Analysis Ports ------------------------
        .gt1_eyescandataerror_out       (gt1_eyescandataerror_out), // output wire gt1_eyescandataerror_out
        .gt1_eyescantrigger_in          (gt1_eyescantrigger_in), // input wire gt1_eyescantrigger_in
        //----------------------------- Receive Ports ------------------------------
        .gt1_sigvalidclk_in             (gt1_sigvalidclk_in), // input wire gt1_sigvalidclk_in
        //----------------------- Receive Ports - CDR Ports ------------------------
        .gt1_rxcdrhold_in               (gt1_rxcdrhold_in), // input wire gt1_rxcdrhold_in
        //---------------- Receive Ports - FPGA RX Interface Ports -----------------
        .gt1_rxdata_out                 (gt1_rxdata_out), // output wire [15:0] gt1_rxdata_out
        .gt1_rxusrclk_in                (gt1_rxusrclk_in), // input wire gt1_rxusrclk_in
        .gt1_rxusrclk2_in               (gt1_rxusrclk2_in), // input wire gt1_rxusrclk2_in
        //---------------- Receive Ports - RX 8B/10B Decoder Ports -----------------
        .gt1_rxchariscomma_out          (gt1_rxchariscomma_out), // output wire [1:0] gt1_rxchariscomma_out
        .gt1_rxcharisk_out              (gt1_rxcharisk_out), // output wire [1:0] gt1_rxcharisk_out
        .gt1_rxdisperr_out              (gt1_rxdisperr_out), // output wire [1:0] gt1_rxdisperr_out
        .gt1_rxnotintable_out           (gt1_rxnotintable_out), // output wire [1:0] gt1_rxnotintable_out
        //---------------------- Receive Ports - RX AFE Ports ----------------------
        .gt1_gtprxn_in                  (gt1_gtprxn_in), // input wire gt1_gtprxn_in
        .gt1_gtprxp_in                  (gt1_gtprxp_in), // input wire gt1_gtprxp_in
        //------------ Receive Ports - RX Byte and Word Alignment Ports ------------
        .gt1_rxbyteisaligned_out        (gt1_rxbyteisaligned_out), // output wire gt1_rxbyteisaligned_out
        .gt1_rxbyterealign_out          (gt1_rxbyterealign_out), // output wire gt1_rxbyterealign_out
        .gt1_rxcommadet_out             (gt1_rxcommadet_out), // output wire gt1_rxcommadet_out
        //---------- Receive Ports - RX Decision Feedback Equalizer(DFE) -----------
        .gt1_dmonitorout_out            (gt1_dmonitorout_out), // output wire [14:0] gt1_dmonitorout_out
        //------------------ Receive Ports - RX Equailizer Ports -------------------
        .gt1_rxlpmhfhold_in             (gt1_rxlpmhfhold_in), // input wire gt1_rxlpmhfhold_in
        .gt1_rxlpmhfovrden_in           (gt1_rxlpmhfovrden_in), // input wire gt1_rxlpmhfovrden_in
        .gt1_rxlpmlfhold_in             (gt1_rxlpmlfhold_in), // input wire gt1_rxlpmlfhold_in
        //---------- Receive Ports - RX Fabric ClocK Output Control Ports ----------
        .gt1_rxratedone_out             (gt1_rxratedone_out), // output wire gt1_rxratedone_out
        //------------- Receive Ports - RX Fabric Output Control Ports -------------
        .gt1_rxoutclk_out               (gt1_rxoutclk_i), // output wire gt1_rxoutclk_i
        .gt1_rxoutclkfabric_out         (gt1_rxoutclkfabric_out), // output wire gt1_rxoutclkfabric_out
        //----------- Receive Ports - RX Initialization and Reset Ports ------------
        .gt1_gtrxreset_in               (gt1_gtrxreset_i), // input wire gt1_gtrxreset_i
        .gt1_rxlpmreset_in              (gt1_rxlpmreset_in), // input wire gt1_rxlpmreset_in
        .gt1_rxpmareset_in              (gt1_rxpmareset_in), // input wire gt1_rxpmareset_in
        //----------------- Receive Ports - RX OOB Signaling ports -----------------
        .gt1_rxcomsasdet_out            (gt1_rxcomsasdet_out), // output wire gt1_rxcomsasdet_out
        .gt1_rxcomwakedet_out           (gt1_rxcomwakedet_out), // output wire gt1_rxcomwakedet_out
        //---------------- Receive Ports - RX OOB Signaling ports  -----------------
        .gt1_rxcominitdet_out           (gt1_rxcominitdet_out), // output wire gt1_rxcominitdet_out
        //---------------- Receive Ports - RX OOB signalling Ports -----------------
        .gt1_rxelecidle_out             (gt1_rxelecidle_out), // output wire gt1_rxelecidle_out
        //--------------- Receive Ports - RX Polarity Control Ports ----------------
        .gt1_rxpolarity_in              (gt1_rxpolarity_in), // input wire gt1_rxpolarity_in
        //------------ Receive Ports -RX Initialization and Reset Ports ------------
        .gt1_rxresetdone_out            (gt1_rxresetdone_i), // output wire gt1_rxresetdone_i
        //------------------- TX Initialization and Reset Ports --------------------
        .gt1_gttxreset_in               (gt1_gttxreset_i), // input wire gt1_gttxreset_i
        .gt1_txuserrdy_in               (gt1_txuserrdy_i), // input wire gt1_txuserrdy_i
        //---------------- Transmit Ports - FPGA TX Interface Ports ----------------
        .gt1_txdata_in                  (gt1_txdata_in), // input wire [15:0] gt1_txdata_in
        .gt1_txusrclk_in                (gt1_txusrclk_in), // input wire gt1_txusrclk_in
        .gt1_txusrclk2_in               (gt1_txusrclk2_in), // input wire gt1_txusrclk2_in
        //------------------- Transmit Ports - PCI Express Ports -------------------
        .gt1_txelecidle_in              (gt1_txelecidle_in), // input wire gt1_txelecidle_in
        .gt1_txrate_in                  (gt1_txrate_in), // input wire [2:0] gt1_txrate_in
        //---------------- Transmit Ports - TX 8B/10B Encoder Ports ----------------
        .gt1_txcharisk_in               (gt1_txcharisk_in), // input wire [1:0] gt1_txcharisk_in
        //------------- Transmit Ports - TX Configurable Driver Ports --------------
        .gt1_gtptxn_out                 (gt1_gtptxn_out), // output wire gt1_gtptxn_out
        .gt1_gtptxp_out                 (gt1_gtptxp_out), // output wire gt1_gtptxp_out
        //--------- Transmit Ports - TX Fabric Clock Output Control Ports ----------
        .gt1_txoutclk_out               (gt1_txoutclk_i), // output wire gt1_txoutclk_i
        .gt1_txoutclkfabric_out         (gt1_txoutclkfabric_out), // output wire gt1_txoutclkfabric_out
        .gt1_txoutclkpcs_out            (gt1_txoutclkpcs_out), // output wire gt1_txoutclkpcs_out
        .gt1_txratedone_out             (gt1_txratedone_out), // output wire gt1_txratedone_out
        //----------- Transmit Ports - TX Initialization and Reset Ports -----------
        .gt1_txresetdone_out            (gt1_txresetdone_i), // output wire gt1_txresetdone_i
        //---------------- Transmit Ports - TX OOB signalling Ports ----------------
        .gt1_txcomfinish_out            (gt1_txcomfinish_out), // output wire gt1_txcomfinish_out
        .gt1_txcominit_in               (gt1_txcominit_in), // input wire gt1_txcominit_in
        .gt1_txcomwake_in               (gt1_txcomwake_in), // input wire gt1_txcomwake_in
        //--------------- Transmit Ports - TX Polarity Control Ports ---------------
        .gt1_txpolarity_in              (gt1_txpolarity_in), // input wire gt1_txpolarity_in




    //____________________________COMMON PORTS________________________________
        .gt0_pll0reset_in               (gt0_pll0reset_t),
        .gt0_pll0outclk_in              (gt0_pll0outclk_in),
        .gt0_pll0outrefclk_in           (gt0_pll0outrefclk_in),
        .gt0_pll1outclk_in              (gt0_pll1outclk_in),
        .gt0_pll1outrefclk_in           (gt0_pll1outrefclk_in)

    );




assign  gt0_txresetdone_out                  =  gt0_txresetdone_i;
assign  gt0_rxresetdone_out                  =  gt0_rxresetdone_i;
assign  gt0_rxoutclk_out                     =  gt0_rxoutclk_i;
assign  gt0_txoutclk_out                     =  gt0_txoutclk_i;
assign  gt1_txresetdone_out                  =  gt1_txresetdone_i;
assign  gt1_rxresetdone_out                  =  gt1_rxresetdone_i;
assign  gt1_rxoutclk_out                     =  gt1_rxoutclk_i;
assign  gt1_txoutclk_out                     =  gt1_txoutclk_i;
assign  gt0_pll0reset_out                    =  gt0_pll0reset_t;

generate
if (EXAMPLE_USE_CHIPSCOPE == 1) 
begin : chipscope
assign  gt0_gttxreset_i                      =  gt0_gttxreset_in || gt0_gttxreset_t;
assign  gt0_gtrxreset_i                      =  gt0_gtrxreset_in || gt0_gtrxreset_t;
assign  gt0_txuserrdy_i                      =  gt0_txuserrdy_in && gt0_txuserrdy_t;
assign  gt0_rxuserrdy_i                      =  gt0_rxuserrdy_in && gt0_rxuserrdy_t;
assign  gt1_gttxreset_i                      =  gt1_gttxreset_in || gt1_gttxreset_t;
assign  gt1_gtrxreset_i                      =  gt1_gtrxreset_in || gt1_gtrxreset_t;
assign  gt1_txuserrdy_i                      =  gt1_txuserrdy_in && gt1_txuserrdy_t;
assign  gt1_rxuserrdy_i                      =  gt1_rxuserrdy_in && gt1_rxuserrdy_t;
end
endgenerate 

generate
if (EXAMPLE_USE_CHIPSCOPE == 0) 
begin : no_chipscope
assign  gt0_gttxreset_i                      =  gt0_gttxreset_t;
assign  gt0_gtrxreset_i                      =  gt0_gtrxreset_t;
assign  gt0_txuserrdy_i                      =  gt0_txuserrdy_t;
assign  gt0_rxuserrdy_i                      =  gt0_rxuserrdy_t;
assign  gt1_gttxreset_i                      =  gt1_gttxreset_t;
assign  gt1_gtrxreset_i                      =  gt1_gtrxreset_t;
assign  gt1_txuserrdy_i                      =  gt1_txuserrdy_t;
assign  gt1_rxuserrdy_i                      =  gt1_rxuserrdy_t;
end
endgenerate 


gtwizard_0_TX_STARTUP_FSM #
          (
           .EXAMPLE_SIMULATION       (EXAMPLE_SIMULATION),
           .STABLE_CLOCK_PERIOD      (STABLE_CLOCK_PERIOD),           // Period of the stable clock driving this state-machine, unit is [ns]
           .RETRY_COUNTER_BITWIDTH   (8), 
           .TX_PLL0_USED             ("TRUE"),                        // the TX and RX Reset FSMs must 
           .RX_PLL0_USED             ("TRUE"),                        // share these two generic values
           .PHASE_ALIGNMENT_MANUAL   ("FALSE")               // Decision if a manual phase-alignment is necessary or the automatic 
                                                                     // is enough. For single-lane applications the automatic alignment is 
                                                                     // sufficient              
             ) 
gt0_txresetfsm_i      
            ( 
        .STABLE_CLOCK                   (sysclk_in),
        .TXUSERCLK                      (gt0_txusrclk_in),
        .SOFT_RESET                     (soft_reset_tx_in),
        .PLL0REFCLKLOST                 (gt0_pll0refclklost_in),
        .PLL0LOCK                       (gt0_pll0lock_in),
        .PLL1REFCLKLOST                 (tied_to_ground_i),
        .PLL1LOCK                       (tied_to_vcc_i),
        .TXRESETDONE                    (gt0_txresetdone_i),
        .MMCM_LOCK                      (gt0_tx_mmcm_lock_in),
        .GTTXRESET                      (gt0_gttxreset_t),
        .MMCM_RESET                     (gt0_tx_mmcm_reset_out),
        .PLL0_RESET                     (gt0_pll0reset_t),
        .PLL1_RESET                     (),
        .TX_FSM_RESET_DONE              (gt0_tx_fsm_reset_done_out),
        .TXUSERRDY                      (gt0_txuserrdy_t),
        .RUN_PHALIGNMENT                (),
        .RESET_PHALIGNMENT              (),
        .PHALIGNMENT_DONE               (tied_to_vcc_i),
        .RETRY_COUNTER                  ()
           );


gtwizard_0_TX_STARTUP_FSM #
          (
           .EXAMPLE_SIMULATION       (EXAMPLE_SIMULATION),
           .STABLE_CLOCK_PERIOD      (STABLE_CLOCK_PERIOD),           // Period of the stable clock driving this state-machine, unit is [ns]
           .RETRY_COUNTER_BITWIDTH   (8), 
           .TX_PLL0_USED             ("TRUE"),                        // the TX and RX Reset FSMs must 
           .RX_PLL0_USED             ("TRUE"),                        // share these two generic values
           .PHASE_ALIGNMENT_MANUAL   ("FALSE")               // Decision if a manual phase-alignment is necessary or the automatic 
                                                                     // is enough. For single-lane applications the automatic alignment is 
                                                                     // sufficient              
             ) 
gt1_txresetfsm_i      
            ( 
        .STABLE_CLOCK                   (sysclk_in),
        .TXUSERCLK                      (gt1_txusrclk_in),
        .SOFT_RESET                     (soft_reset_tx_in),
        .PLL0REFCLKLOST                 (gt0_pll0refclklost_in),
        .PLL0LOCK                       (gt0_pll0lock_in),
        .PLL1REFCLKLOST                 (tied_to_ground_i),
        .PLL1LOCK                       (tied_to_vcc_i),
        .TXRESETDONE                    (gt1_txresetdone_i),
        .MMCM_LOCK                      (gt1_tx_mmcm_lock_in),
        .GTTXRESET                      (gt1_gttxreset_t),
        .MMCM_RESET                     (gt1_tx_mmcm_reset_out),
        .PLL0_RESET                     (),
        .PLL1_RESET                     (),
        .TX_FSM_RESET_DONE              (gt1_tx_fsm_reset_done_out),
        .TXUSERRDY                      (gt1_txuserrdy_t),
        .RUN_PHALIGNMENT                (),
        .RESET_PHALIGNMENT              (),
        .PHALIGNMENT_DONE               (tied_to_vcc_i),
        .RETRY_COUNTER                  ()
           );





gtwizard_0_RX_STARTUP_FSM  #
          (
           .EXAMPLE_SIMULATION       (EXAMPLE_SIMULATION),
           .STABLE_CLOCK_PERIOD      (STABLE_CLOCK_PERIOD),              //Period of the stable clock driving this state-machine, unit is [ns]
           .RETRY_COUNTER_BITWIDTH   (8), 
           .TX_PLL0_USED             ("TRUE"),                           // the TX and RX Reset FSMs must 
           .RX_PLL0_USED             ("TRUE"),                           // share these two generic values
           .PHASE_ALIGNMENT_MANUAL   ("FALSE")                 // Decision if a manual phase-alignment is necessary or the automatic 
                                                                         // is enough. For single-lane applications the automatic alignment is 
                                                                         // sufficient              
             )     
gt0_rxresetfsm_i
             ( 
        .STABLE_CLOCK                   (sysclk_in),
        .RXUSERCLK                      (gt0_rxusrclk_in),
        .SOFT_RESET                     (soft_reset_rx_in),
        .RXPMARESETDONE                 (gt0_rxpmaresetdone_i),
        .RXOUTCLK                       (gt0_rxusrclk_in),
        .DONT_RESET_ON_DATA_ERROR       (dont_reset_on_data_error_in),
        .PLL0REFCLKLOST                 (gt0_pll0refclklost_in),
        .PLL0LOCK                       (gt0_pll0lock_in),
        .PLL1REFCLKLOST                 (tied_to_ground_i),
        .PLL1LOCK                       (tied_to_vcc_i),
        .RXRESETDONE                    (gt0_rxresetdone_i),
        .MMCM_LOCK                      (tied_to_vcc_i),
        .RECCLK_STABLE                  (gt0_recclk_stable_i),
        .RECCLK_MONITOR_RESTART         (tied_to_ground_i),
        .DATA_VALID                     (gt0_data_valid_in),
        .TXUSERRDY                      (tied_to_vcc_i),
        .GTRXRESET                      (gt0_gtrxreset_t),
        .MMCM_RESET                     (),
        .PLL0_RESET                     (),
        .PLL1_RESET                     (),
        .RX_FSM_RESET_DONE              (gt0_rx_fsm_reset_done_out),
        .RXUSERRDY                      (gt0_rxuserrdy_t),
        .RUN_PHALIGNMENT                (),
        .RESET_PHALIGNMENT              (),
        .PHALIGNMENT_DONE               (tied_to_vcc_i),
        .RETRY_COUNTER                  ()
           );

gtwizard_0_RX_STARTUP_FSM  #
          (
           .EXAMPLE_SIMULATION       (EXAMPLE_SIMULATION),
           .STABLE_CLOCK_PERIOD      (STABLE_CLOCK_PERIOD),              //Period of the stable clock driving this state-machine, unit is [ns]
           .RETRY_COUNTER_BITWIDTH   (8), 
           .TX_PLL0_USED             ("TRUE"),                           // the TX and RX Reset FSMs must 
           .RX_PLL0_USED             ("TRUE"),                           // share these two generic values
           .PHASE_ALIGNMENT_MANUAL   ("FALSE")                 // Decision if a manual phase-alignment is necessary or the automatic 
                                                                         // is enough. For single-lane applications the automatic alignment is 
                                                                         // sufficient              
             )     
gt1_rxresetfsm_i
             ( 
        .STABLE_CLOCK                   (sysclk_in),
        .RXUSERCLK                      (gt1_rxusrclk_in),
        .SOFT_RESET                     (soft_reset_rx_in),
        .RXPMARESETDONE                 (gt1_rxpmaresetdone_i),
        .RXOUTCLK                       (gt1_rxusrclk_in),
        .DONT_RESET_ON_DATA_ERROR       (dont_reset_on_data_error_in),
        .PLL0REFCLKLOST                 (gt0_pll0refclklost_in),
        .PLL0LOCK                       (gt0_pll0lock_in),
        .PLL1REFCLKLOST                 (tied_to_ground_i),
        .PLL1LOCK                       (tied_to_vcc_i),
        .RXRESETDONE                    (gt1_rxresetdone_i),
        .MMCM_LOCK                      (tied_to_vcc_i),
        .RECCLK_STABLE                  (gt1_recclk_stable_i),
        .RECCLK_MONITOR_RESTART         (tied_to_ground_i),
        .DATA_VALID                     (gt1_data_valid_in),
        .TXUSERRDY                      (tied_to_vcc_i),
        .GTRXRESET                      (gt1_gtrxreset_t),
        .MMCM_RESET                     (),
        .PLL0_RESET                     (),
        .PLL1_RESET                     (),
        .RX_FSM_RESET_DONE              (gt1_rx_fsm_reset_done_out),
        .RXUSERRDY                      (gt1_rxuserrdy_t),
        .RUN_PHALIGNMENT                (),
        .RESET_PHALIGNMENT              (),
        .PHALIGNMENT_DONE               (tied_to_vcc_i),
        .RETRY_COUNTER                  ()
           );

  always @(posedge sysclk_in)
  begin
        if(gt0_gtrxreset_i)
        begin
          gt0_rx_cdrlocked       <= `DLY    1'b0;
          gt0_rx_cdrlock_counter <= `DLY    0;      
        end                
        else if (gt0_rx_cdrlock_counter == WAIT_TIME_CDRLOCK) 
        begin
          gt0_rx_cdrlocked       <= `DLY    1'b1;
          gt0_rx_cdrlock_counter <= `DLY    gt0_rx_cdrlock_counter;
        end
        else
          gt0_rx_cdrlock_counter <= `DLY    gt0_rx_cdrlock_counter + 1;
  end 

  always @(posedge sysclk_in)
  begin
        if(gt1_gtrxreset_i)
        begin
          gt1_rx_cdrlocked       <= `DLY    1'b0;
          gt1_rx_cdrlock_counter <= `DLY    0;      
        end                
        else if (gt1_rx_cdrlock_counter == WAIT_TIME_CDRLOCK) 
        begin
          gt1_rx_cdrlocked       <= `DLY    1'b1;
          gt1_rx_cdrlock_counter <= `DLY    gt1_rx_cdrlock_counter;
        end
        else
          gt1_rx_cdrlock_counter <= `DLY    gt1_rx_cdrlock_counter + 1;
  end 

assign  gt0_recclk_stable_i                  =  gt0_rx_cdrlocked;
assign  gt1_recclk_stable_i                  =  gt1_rx_cdrlocked;







endmodule
