shumov-ag/wp2017/src/sata_repeater_gen1/sata_repeater_gen1.srcs/sources_1/ip/gtwizard_0/gtwizard_0/example_design/gtwizard_0_rx_startup_fsm.v

////////////////////////////////////////////////////////////////////////////////
//   ____  ____ 
//  /   /\/   / 
// /___/  \  /    Vendor: Xilinx 
// \   \   \/     Version : 3.6
//  \   \         Application : 7 Series FPGAs Transceivers Wizard 
//  /   /         Filename : gtwizard_0_rx_startup_fsm.v
// /___/   /\     
// \   \  /  \ 
//  \___\/\___\ 
//
//
//  Description :     This module performs RX reset and initialization.
//                     
//
//
// Module gtwizard_0_rx_startup_fsm
// Generated by Xilinx 7 Series FPGAs Transceivers Wizard
// 
// 
// (c) Copyright 2010-2012 Xilinx, Inc. All rights reserved.
// 
// This file contains confidential and proprietary information
// of Xilinx, Inc. and is protected under U.S. and
// international copyright and other intellectual property
// laws.
// 
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
// CRITICAL APPLICATIONS
// Xilinx products are not designed or intended to be fail-
// safe, or for use in any application requiring fail-safe
// performance, such as life-support or safety devices or
// systems, Class III medical devices, nuclear facilities,
// applications related to the deployment of airbags, or any
// other applications that could lead to death, personal
// injury, or severe property or environmental damage
// (individually and collectively, "Critical
// Applications"). Customer assumes the sole risk and
// liability of any use of Xilinx products in Critical
// Applications, subject only to applicable laws and
// regulations governing limitations on product liability.
// 
// THIS COPYRIGHT NOTICE AND DISCLAIMER MUST BE RETAINED AS
// PART OF THIS FILE AT ALL TIMES. 


//*****************************************************************************

`timescale 1ns / 1ps
`define DLY #1
`define CLOG2(x) \
   (x <= 2) ? 1 : \
   (x <= 4) ? 2 : \
   (x <= 8) ? 3 : \
   (x <= 16) ? 4 : \
   (x <= 32) ? 5 : \
   (x <= 64) ? 6 : \
   (x <= 128) ? 7 : \
   (x <= 256) ? 8 : \
   (x <= 512) ? 9 : \
   (x <= 1024) ? 10 : \
   (x <= 2048) ? 11 : \
   (x <= 4096) ? 12 : \
   (x <= 8192) ? 13 : \
   (x <= 16384) ? 14 : \
   (x <= 32768) ? 15 : \
   (x <= 65536) ? 16 : \
   (x <= 131072) ? 17 : \
   (x <= 262144) ? 18 : \
   (x <= 524288) ? 19 : \
   -1

module gtwizard_0_RX_STARTUP_FSM #
   (
       parameter     EXAMPLE_SIMULATION      = 0,          // Set to 1 for Simulation
       parameter     STABLE_CLOCK_PERIOD     = 8,           //Period of the stable clock driving this state-machine, unit is [ns]
       parameter     RETRY_COUNTER_BITWIDTH  = 8, 
      parameter      TX_PLL0_USED            = "FALSE",  // the TX and RX Reset FSMs must
      parameter      RX_PLL0_USED            = "FALSE",  // share these two generic values

       parameter     PHASE_ALIGNMENT_MANUAL  = "TRUE"       // Decision if a manual phase-alignment is necessary or the automatic 
                                                            // is enough. For single-lane applications the automatic alignment is 
                                                            // sufficient                         
   )
   ( 
       input       wire     STABLE_CLOCK,     //Stable Clock, either a stable clock from the PCB
                                              //or reference-clock present at startup.
       input       wire     RXUSERCLK,        //RXUSERCLK as used in the design
       input       wire     SOFT_RESET,       //User Reset, can be pulled any time
      input  wire      RXPMARESETDONE,               
      input  wire      RXOUTCLK, 
              
       input       wire     PLL0REFCLKLOST,   //PLL0 Reference-clock for the GT is lost
       input       wire     PLL1REFCLKLOST,   //PLL1 Reference-clock for the GT is lost
       input       wire     PLL0LOCK,         //Lock Detect from the PLL0 of the GT
       input       wire     PLL1LOCK ,        //Lock Detect from the PLL1 of the GT
       input       wire     RXRESETDONE,
       input       wire     MMCM_LOCK,
       input       wire     RECCLK_STABLE,
       input       wire     RECCLK_MONITOR_RESTART,
       input       wire     DATA_VALID,
       input       wire     TXUSERRDY,                //TXUSERRDY from GT
       input       wire     DONT_RESET_ON_DATA_ERROR, //Used to control the Auto-Reset of FSM when Data Error is detected
       output            GTRXRESET ,
       output            MMCM_RESET ,
       output      reg      PLL0_RESET = 1'b0,        //Reset PLL0
       output      reg      PLL1_RESET = 1'b0,        //Reset PLL1
       output               RX_FSM_RESET_DONE,        //Reset-sequence has sucessfully been finished.
       output      reg      RXUSERRDY = 1'b0,
       output      wire     RUN_PHALIGNMENT,
       input       wire     PHALIGNMENT_DONE,
       output      reg      RESET_PHALIGNMENT = 1'b0,           
       output      wire     [RETRY_COUNTER_BITWIDTH-1:0] RETRY_COUNTER // Number of 
                                                                       // Retries it took to get the transceiver up and running
       ); 
           

//Interdependencies:
// * Timing depends on the frequency of the stable clock. Hence counters-sizes
//   are calculated at design-time based on the Generics
//   
// * if either of the PLLs is reset during TX-startup, it does not need to be reset again by RX
//   => signal which PLL has been reset
// * 



  localparam [3:0] 
             INIT                 = 4'b0000,
             ASSERT_ALL_RESETS    = 4'b0001,
             WAIT_FOR_PLL_LOCK    = 4'b0010,
             RELEASE_PLL_RESET    = 4'b0011,
             VERIFY_RECCLK_STABLE = 4'b0100,
             RELEASE_MMCM_RESET   = 4'b0101,
             WAIT_FOR_RXUSRCLK    = 4'b0110,
             WAIT_RESET_DONE      = 4'b0111,
             DO_PHASE_ALIGNMENT   = 4'b1000,
             MONITOR_DATA_VALID   = 4'b1001,
             FSM_DONE             = 4'b1010;
    
  reg [3:0] rx_state = INIT;

  //This function decides how many clock-cycle need to be waited until 
  // a time-out occurs for bypassing the TX-Buffer
  function [12:0] get_max_wait_bypass;
    input manual_mode;
    reg [12:0] max_wait_cnt;
  begin
    if (manual_mode == "TRUE") 
      max_wait_cnt = 5000;
    else
      max_wait_cnt = 3100;
    get_max_wait_bypass = max_wait_cnt;
  end
  endfunction

  localparam integer MMCM_LOCK_CNT_MAX = 256;
  localparam integer STARTUP_DELAY = 500;//AR43482: Transceiver needs to wait for 500 ns after configuration
  localparam integer WAIT_CYCLES = STARTUP_DELAY / STABLE_CLOCK_PERIOD; // Number of Clock-Cycles to wait after configuration
  localparam integer WAIT_MAX = WAIT_CYCLES + 10;                       // 500 ns plus some additional margin
  localparam integer WAIT_TIMEOUT_2ms   = 3000000 / STABLE_CLOCK_PERIOD;  //3 ms time-out
  localparam integer WAIT_TLOCK_MAX     = 100000 / STABLE_CLOCK_PERIOD;   //100 us time-out
  localparam integer WAIT_TIMEOUT_500us = 500000 / STABLE_CLOCK_PERIOD;   //500 us time-out
  localparam integer WAIT_TIMEOUT_1us   = 1000 / STABLE_CLOCK_PERIOD;     //1 us time-out
  localparam integer WAIT_TIMEOUT_100us = 100000 / STABLE_CLOCK_PERIOD;   //100us time-out
  localparam integer WAIT_TIME_ADAPT    = (37000000 /1.5)/STABLE_CLOCK_PERIOD;
  localparam integer WAIT_TIME_MAX   = EXAMPLE_SIMULATION? 100 : 10000 / STABLE_CLOCK_PERIOD;
  localparam integer PORT_WIDTH   = `CLOG2(WAIT_TIMEOUT_2ms);
    
  reg [7:0] init_wait_count = 0;
  reg       init_wait_done = 1'b0;
  reg       pll_reset_asserted = 1'b0;


  reg       rx_fsm_reset_done_int = 1'b0;
  wire      rx_fsm_reset_done_int_s2;
  reg       rx_fsm_reset_done_int_s3 = 1'b0;

  localparam integer MAX_RETRIES = 2**RETRY_COUNTER_BITWIDTH-1; 
  reg [7:0]  retry_counter_int = 0;  
  reg [PORT_WIDTH-1:0] time_out_counter = 0;
  reg [1:0]  recclk_mon_restart_count = 0 ;
  reg        recclk_mon_count_reset = 0;
  
  reg        reset_time_out = 1'b0;
  reg        time_out_2ms = 1'b0;  //--\Flags that the various time-out points 
  reg        time_tlock_max = 1'b0; //--|have been reached.
  reg        time_out_500us = 1'b0; //--|
  reg        time_out_1us = 1'b0;   //--|
  reg        time_out_100us = 1'b0;  //--/
  reg        check_tlock_max = 1'b0;
    
  reg [9:0]  mmcm_lock_count = 1'b0;
  reg        mmcm_lock_int = 1'b0;
  wire       mmcm_lock_i;
  reg        mmcm_lock_reclocked = 1'b0;
    
  reg       run_phase_alignment_int = 1'b0;
  wire      run_phase_alignment_int_s2;
  reg       run_phase_alignment_int_s3 = 1'b0;

  wire     txpmaresetdone_s;
  wire     reset_stage1;
  wire     reset_stage1_tx;
  wire     gtrxreset_s; 
  wire     gtrxreset_tx_s; 


  localparam integer MAX_WAIT_BYPASS = 5000;//5000 RXUSRCLK cycles is the max time for Multi Lane designs

  reg [12:0] wait_bypass_count = 0;
  reg        time_out_wait_bypass = 1'b0;
  wire       time_out_wait_bypass_s2;
  reg        time_out_wait_bypass_s3 = 1'b0;
  reg        gtrxreset_i = 1'b0;
  reg        mmcm_reset_i = 1'b1;
  reg        rxpmaresetdone_i = 1'b0;
  reg        txpmaresetdone_i = 1'b0;

  wire       refclk_lost;
  wire       rxpmaresetdone_sync;
  wire       txpmaresetdone_sync;
  wire       rxpmaresetdone_s;
  reg       rxpmaresetdone_ss = 1'b0;
  wire      rxpmaresetdone_rx_s ;
  reg       pmaresetdone_fallingedge_detect = 1'b0;
  wire       pmaresetdone_fallingedge_detect_s ;

  wire      rxresetdone_s2;
  reg       rxresetdone_s3 = 1'b0;
  wire      data_valid_sync;
  reg      gtrxreset_tx_i = 1'b0;
  reg      gtrxreset_rx_i = 1'b0;

  wire      pll0lock_sync;
  wire      pll1lock_sync;
  reg       pll0lock_ris_edge = 1'b0;
  reg       pll1lock_ris_edge = 1'b0;
  reg       pll0lock_prev;
  reg       pll1lock_prev;

  reg   [15:0] wait_time_cnt;
  wire  wait_time_done; 

  //Alias section, signals used within this module mapped to output ports:
  assign    RETRY_COUNTER     = retry_counter_int;
  assign    RUN_PHALIGNMENT   = run_phase_alignment_int;
  assign    RX_FSM_RESET_DONE = rx_fsm_reset_done_int;
  assign    GTRXRESET = gtrxreset_i;
  assign    MMCM_RESET = mmcm_reset_i;

 always @(posedge STABLE_CLOCK or posedge SOFT_RESET)
  begin
      // The counter starts running when configuration has finished and 
      // the clock is stable. When its maximum count-value has been reached,
      // the 500 ns from Answer Record 43482 have been passed.
     if(SOFT_RESET)
      begin
          init_wait_count <= `DLY 8'h0;
          init_wait_done  <= `DLY 1'b0;
      end
      else if (init_wait_count == WAIT_MAX) 
          init_wait_done <= `DLY  1'b1;
      else
        init_wait_count <= `DLY  init_wait_count + 1;
   end 

 

 always @(posedge STABLE_CLOCK)
  begin
   gtrxreset_rx_i <= `DLY gtrxreset_i;
  end
  (* shreg_extract = "no", ASYNC_REG = "TRUE" *)
  FDP #(
   .INIT (1'b0)
  ) reset_sync1_rx (
  .C  (RXOUTCLK), 
  .PRE(gtrxreset_rx_i),
  .D  (1'b0),
  .Q  (reset_stage1) 
  );
  
  (* shreg_extract = "no", ASYNC_REG = "TRUE" *)
  FDP #(
   .INIT (1'b0)
  ) reset_sync2_rx (
  .C  (RXOUTCLK), 
  .PRE(gtrxreset_rx_i),
  .D  (reset_stage1),
  .Q  (gtrxreset_s) 
  );


   always @(posedge RXOUTCLK,posedge gtrxreset_s)
  begin
      if(gtrxreset_s == 1'b1)
        rxpmaresetdone_i <= `DLY 1'b0;
      else
        rxpmaresetdone_i <= `DLY pmaresetdone_fallingedge_detect_s & rxpmaresetdone_rx_s;
  end

  gtwizard_0_sync_block sync_rxpmaresetdone_rx 
        (
           .clk             (RXOUTCLK),
           .data_in         (RXPMARESETDONE),
           .data_out        (rxpmaresetdone_rx_s)
        );
  gtwizard_0_sync_block sync2_pmaresetdone 
        (
           .clk             (STABLE_CLOCK),
           .data_in         (rxpmaresetdone_i),
           .data_out        (rxpmaresetdone_sync)
        );
  gtwizard_0_sync_block sync_pmaresetdone 
        (
           .clk             (STABLE_CLOCK),
           .data_in         (RXPMARESETDONE),
           .data_out        (rxpmaresetdone_s)
        );
 always @(posedge STABLE_CLOCK)
  begin
   rxpmaresetdone_ss <= `DLY rxpmaresetdone_s;
  end


 always @(posedge STABLE_CLOCK)
  begin
  if(gtrxreset_i ==1'b1)
  pmaresetdone_fallingedge_detect <= `DLY 1'b0;
   else if(!rxpmaresetdone_s && rxpmaresetdone_ss)
  pmaresetdone_fallingedge_detect <= `DLY 1'b1;
   else
  pmaresetdone_fallingedge_detect <= `DLY pmaresetdone_fallingedge_detect;
  end

  gtwizard_0_sync_block sync_pmaresetdone_fallingedge_detect
        (
           .clk             (RXOUTCLK),
           .data_in         (pmaresetdone_fallingedge_detect),
           .data_out        (pmaresetdone_fallingedge_detect_s)
        );

  always @(posedge STABLE_CLOCK)
  begin
    //This counter monitors, how many retries the CDR Lock Detection
    //runs. If during startup too many retries are necessary, the whole 
    //initialisation-process of the transceivers gets restarted.
      if (recclk_mon_count_reset == 1)
        recclk_mon_restart_count <= `DLY  0;
      else if (RECCLK_MONITOR_RESTART == 1) 
      begin
        if (recclk_mon_restart_count == 3)
          recclk_mon_restart_count <= `DLY  0;
        else 
          recclk_mon_restart_count <= `DLY  recclk_mon_restart_count + 1;
      end
  end


  always @(posedge STABLE_CLOCK)
  begin
      // One common large counter for generating three time-out signals.
      // Intermediate time-outs are derived from calculated values, based
      // on the period of the provided clock.
      if (reset_time_out == 1)
      begin
        time_out_counter  <= `DLY  0;
        time_out_2ms      <= `DLY  1'b0;
        time_tlock_max    <= `DLY  1'b0;
        time_out_500us    <= `DLY  1'b0;
        time_out_1us      <= `DLY  1'b0;
        time_out_100us    <= `DLY  1'b0;
      end
      else
      begin
        if (time_out_counter == WAIT_TIMEOUT_2ms)
          time_out_2ms <= `DLY  1'b1;
        else
          time_out_counter <= `DLY  time_out_counter + 1;
        
        if (time_out_counter > WAIT_TLOCK_MAX && check_tlock_max == 1)
        begin
          time_tlock_max <= `DLY  1'b1;
        end

        if (time_out_counter == WAIT_TIMEOUT_500us)
        begin
          time_out_500us <= `DLY  1'b1;
        end

        if (time_out_counter == WAIT_TIMEOUT_1us)
        begin
          time_out_1us <= `DLY  1'b1;
        end

        if (time_out_counter == WAIT_TIMEOUT_100us)
        begin
          time_out_100us <= `DLY  1'b1;
        end

      end
  end

  always @(posedge STABLE_CLOCK)
  begin
    //The lock-signal from the MMCM is not immediately used but 
    //enabling a counter. Only when the counter hits its maximum,
    //the MMCM is considered as "really" locked. 
    //The counter avoids that the FSM already starts on only a 
    //coarse lock of the MMCM (=toggling of the LOCK-signal).
      if (mmcm_lock_i == 1'b0)
      begin
        mmcm_lock_count <= `DLY  0;
        mmcm_lock_reclocked   <= `DLY  1'b0;
      end
      else
      begin       
        if (mmcm_lock_count < MMCM_LOCK_CNT_MAX - 1)
          mmcm_lock_count <= `DLY  mmcm_lock_count + 1;
        else
          mmcm_lock_reclocked <= `DLY  1'b1;
      end
  end 
  

  //Clock Domain Crossing

 gtwizard_0_sync_block sync_run_phase_alignment_int 
        (
           .clk             (RXUSERCLK),
           .data_in         (run_phase_alignment_int),
           .data_out        (run_phase_alignment_int_s2)
        );

 gtwizard_0_sync_block sync_rx_fsm_reset_done_int 
        (
           .clk             (RXUSERCLK),
           .data_in         (rx_fsm_reset_done_int),
           .data_out        (rx_fsm_reset_done_int_s2)
        );


  always @(posedge RXUSERCLK)
  begin
     run_phase_alignment_int_s3 <= `DLY run_phase_alignment_int_s2;

     rx_fsm_reset_done_int_s3   <= `DLY rx_fsm_reset_done_int_s2;
  end

gtwizard_0_sync_block sync_time_out_wait_bypass 
        (
           .clk             (STABLE_CLOCK),
           .data_in         (time_out_wait_bypass),
           .data_out        (time_out_wait_bypass_s2)
        );

 gtwizard_0_sync_block sync_RXRESETDONE 
        (
           .clk             (STABLE_CLOCK),
           .data_in         (RXRESETDONE),
           .data_out        (rxresetdone_s2)
        );

 gtwizard_0_sync_block sync_mmcm_lock_reclocked
        (
           .clk             (STABLE_CLOCK),
           .data_in         (MMCM_LOCK),
           .data_out        (mmcm_lock_i)
        );

 gtwizard_0_sync_block sync_data_valid
        (
           .clk             (STABLE_CLOCK),
           .data_in         (DATA_VALID),
           .data_out        (data_valid_sync)
        );



 gtwizard_0_sync_block sync_pll0lock
        (
           .clk             (STABLE_CLOCK),
           .data_in         (PLL0LOCK),
           .data_out        (pll0lock_sync)
        );

 gtwizard_0_sync_block sync_pll1lock
        (
           .clk             (STABLE_CLOCK),
           .data_in         (PLL1LOCK),
           .data_out        (pll1lock_sync)
        );


  always @(posedge STABLE_CLOCK)
  begin
     time_out_wait_bypass_s3   <= `DLY time_out_wait_bypass_s2;

     rxresetdone_s3            <= `DLY rxresetdone_s2;
  end
 

  always @(posedge RXUSERCLK)
  begin
      if (run_phase_alignment_int_s3 == 1'b0)
      begin 
        wait_bypass_count     <= `DLY  0;
        time_out_wait_bypass  <= `DLY  1'b0;
      end
      else if ((run_phase_alignment_int_s3 == 1'b1) && (rx_fsm_reset_done_int_s3 == 1'b0))
      begin
        if (wait_bypass_count == MAX_WAIT_BYPASS - 1)
          time_out_wait_bypass <= `DLY  1'b1;
        else
          wait_bypass_count <= `DLY  wait_bypass_count + 1;
      end
  end


  assign refclk_lost = ( RX_PLL0_USED == "TRUE"  && PLL0REFCLKLOST == 1'b1) ? 1'b1 : 
                       ( RX_PLL0_USED == "FALSE" && PLL1REFCLKLOST == 1'b1) ? 1'b1 : 1'b0;

  always @(posedge STABLE_CLOCK )
  begin
    if((rx_state == ASSERT_ALL_RESETS) |
       (rx_state == RELEASE_MMCM_RESET))
    begin
        wait_time_cnt <= `DLY WAIT_TIME_MAX;
    end else if (wait_time_cnt != 16'h0)
    begin
        wait_time_cnt <= wait_time_cnt - 16'h1;
    end

  end

  assign wait_time_done = (wait_time_cnt == 16'h0);


  //FSM for resetting the GTX/GTH/GTP in the 7-series. 
  //~~~~~~~~~~~~~~~~~~~~~~~~~~~~~~~~~~~~~~~~~~
  //
  // Following steps are performed:
  // 1) After configuration wait for approximately 500 ns as specified in 
  //    answer-record 43482
  // 2) Assert all resets on the GT and on an MMCM potentially connected. 
  //    After that wait until a reference-clock has been detected.
  // 3) Release the reset to the GT and wait until the GT-PLL has locked.
  // 4) Release the MMCM-reset and wait until the MMCM has signalled lock.
  //    Also get info from the TX-side which PLL has been reset.
  // 5) Wait for the RESET_DONE-signal from the GT.
  // 6) Signal to start the phase-alignment procedure and wait for it to 
  //    finish.
  // 7) Reset-sequence has successfully run through. Signal this to the 
  //    rest of the design by asserting RX_FSM_RESET_DONE.
  
  always @(posedge STABLE_CLOCK) 
  begin
      if (SOFT_RESET == 1'b1)
      //if (SOFT_RESET == 1'b1 || (rx_state != INIT && rx_state != ASSERT_ALL_RESETS && refclk_lost == 1'b1))
      begin 
        rx_state                <= `DLY  INIT;
        RXUSERRDY               <= `DLY  1'b0;
        gtrxreset_i             <= `DLY  1'b0;
        mmcm_reset_i            <= `DLY  1'b0;
        rx_fsm_reset_done_int   <= `DLY  1'b0;
        PLL0_RESET              <= `DLY  1'b0;
        PLL1_RESET              <= `DLY  1'b0;
        pll_reset_asserted      <= `DLY  1'b0;
        reset_time_out          <= `DLY  1'b1;
        retry_counter_int       <= `DLY  0;
        run_phase_alignment_int <= `DLY  1'b0;
        check_tlock_max         <= `DLY  1'b0;
        RESET_PHALIGNMENT       <= `DLY  1'b1;
        recclk_mon_count_reset  <= `DLY  1'b1;
      end
      else
      begin
        
        case (rx_state)
           INIT :
           begin 
            //Initial state after configuration. This state will be left after
            //approx. 500 ns and not be re-entered. 
            if (init_wait_done == 1'b1)
              rx_state  <= `DLY  ASSERT_ALL_RESETS;
           end

           ASSERT_ALL_RESETS :
           begin 
            //This is the state into which the FSM will always jump back if any
            //time-outs will occur. 
            //The number of retries is reported on the output RETRY_COUNTER. In 
            //case the transceiver never comes up for some reason, this machine 
            //will still continue its best and rerun until the FPGA is turned off
            //or the transceivers come up correctly.
             if (RX_PLL0_USED == "TRUE" && TX_PLL0_USED == "FALSE")
             begin
              if ((pll_reset_asserted == 1'b0 && refclk_lost == 1'b0))
              begin
                PLL0_RESET          <= `DLY  1'b1;
                pll_reset_asserted  <= `DLY  1'b1;
              end
              else
                PLL0_RESET          <= `DLY  1'b0;
             end 
            else if (RX_PLL0_USED == "FALSE" && TX_PLL0_USED == "TRUE")
            begin
              if ((pll_reset_asserted == 1'b0 && refclk_lost == 1'b0))
              begin
                PLL1_RESET          <= `DLY  1'b1;
                pll_reset_asserted  <= `DLY  1'b1;
              end
              else
                PLL1_RESET          <= `DLY  1'b0;
            end
            RXUSERRDY               <= `DLY  1'b0;
            gtrxreset_i             <= `DLY  1'b1;
            mmcm_reset_i            <= `DLY  1'b1;
            run_phase_alignment_int <= `DLY  1'b0;    
            RESET_PHALIGNMENT       <= `DLY  1'b1;
            check_tlock_max         <= `DLY  1'b0;
            recclk_mon_count_reset  <= `DLY  1'b1;
            if ((RX_PLL0_USED  == "TRUE"  && TX_PLL0_USED == "FALSE"   && pll0lock_sync == 1'b0 && pll_reset_asserted) ||
                (RX_PLL0_USED  == "FALSE" && TX_PLL0_USED == "TRUE"    && pll1lock_sync == 1'b0 && pll_reset_asserted) ||
                (RX_PLL0_USED  == "TRUE"  && TX_PLL0_USED == "TRUE"  ) ||
                (RX_PLL0_USED  == "FALSE" && TX_PLL0_USED == "FALSE" )
               ) 
           begin
              rx_state              <= `DLY  WAIT_FOR_PLL_LOCK;
              reset_time_out        <= `DLY  1'b1;
           end 
           end           
           
           WAIT_FOR_PLL_LOCK :
           begin
              if(wait_time_done)
                 rx_state        <= `DLY RELEASE_PLL_RESET;  
           end     
 
           RELEASE_PLL_RESET : 
           begin
            //PLL-Reset of the GTX gets released and the time-out counter
            //starts running.
            pll_reset_asserted  <= `DLY  1'b0;
            reset_time_out      <= `DLY  1'b0;
            
            if ((RX_PLL0_USED == "TRUE"  && TX_PLL0_USED == "FALSE" && pll0lock_sync == 1'b1) ||
                (RX_PLL0_USED == "FALSE" && TX_PLL0_USED == "TRUE"  && pll1lock_sync == 1'b1)) 
            begin 
              rx_state                <= `DLY  VERIFY_RECCLK_STABLE;
              reset_time_out          <= `DLY  1'b1;
              recclk_mon_count_reset  <= `DLY  1'b0;
            end
            else if ((RX_PLL0_USED == "TRUE"  && pll0lock_sync == 1'b1) ||
                     (RX_PLL0_USED == "FALSE" && pll1lock_sync == 1'b1)) 
            begin 
              rx_state                <= `DLY  VERIFY_RECCLK_STABLE;
              reset_time_out          <= `DLY  1'b1;
              recclk_mon_count_reset  <= `DLY  1'b0;
            end
           
            if (time_out_2ms == 1'b1) 
            begin
              if (retry_counter_int == MAX_RETRIES) 
                // If too many retries are performed compared to what is specified in 
                // the generic, the counter simply wraps around.
                retry_counter_int <= `DLY  0;
              else
              begin
                retry_counter_int <= `DLY  retry_counter_int + 1;
              end
              rx_state            <= `DLY  ASSERT_ALL_RESETS; 
            end            
           end

           VERIFY_RECCLK_STABLE :
           begin
            //reset_time_out  <= `DLY  '0';
            //Time-out counter is not released in this state as here the FSM
            //does not wait for a certain period of time but checks on the number
            //of retries in the CDR PPM detector. 
            gtrxreset_i <= `DLY  1'b0;
            if (RECCLK_STABLE == 1'b1)
            begin
              rx_state        <= `DLY  RELEASE_MMCM_RESET;
              reset_time_out  <= `DLY  1'b1;
            end           

            if (recclk_mon_restart_count == 2)
            begin
              //If two retries are performed in the CDR "Lock" (=CDR PPM-detector) 
              //the whole initialisation-sequence gets restarted.
              if (retry_counter_int == MAX_RETRIES) 
                // If too many retries are performed compared to what is specified in 
                // the generic, the counter simply wraps around.
                retry_counter_int <= `DLY  0;
              else
              begin
                retry_counter_int <= `DLY  retry_counter_int + 1;
              end 
              rx_state            <= `DLY  ASSERT_ALL_RESETS; 
            end   
           end          
          
           RELEASE_MMCM_RESET :
           begin 
            //Release of the MMCM-reset. Waiting for the MMCM to lock.
            check_tlock_max <= `DLY  1'b1;
            
            mmcm_reset_i <= `DLY  1'b0;
            reset_time_out  <= `DLY  1'b0;
        
            if (mmcm_lock_reclocked == 1'b1)
            begin
              rx_state <= `DLY  WAIT_FOR_RXUSRCLK;
              reset_time_out  <= `DLY  1'b1;
            end           
            
            if (time_tlock_max == 1'b1 && reset_time_out  == 1'b0 )
            begin
              if (retry_counter_int == MAX_RETRIES)
                // If too many retries are performed compared to what is specified in 
                // the generic, the counter simply wraps around.
                retry_counter_int <= `DLY  0;
              else
              begin
                retry_counter_int <= `DLY  retry_counter_int + 1;
              end
              rx_state            <= `DLY  ASSERT_ALL_RESETS; 
            end 
           end            
           
           WAIT_FOR_RXUSRCLK :
           begin
              if(wait_time_done)
               rx_state <= `DLY WAIT_RESET_DONE;  
           end  

           WAIT_RESET_DONE :
           begin
           //When TXOUTCLK is the source for RXUSRCLK, RXUSERRDY depends on TXUSERRDY
           //If RXOUTCLK is the source for RXUSRCLK, TXUSERRDY can be tied to '1'

            if(TXUSERRDY)
               RXUSERRDY    <= `DLY  1'b1;
 
            reset_time_out  <= `DLY  1'b0;
            if (rxresetdone_s3 == 1'b1)
            begin
              rx_state        <= `DLY  DO_PHASE_ALIGNMENT; 
              reset_time_out  <= `DLY  1'b1;
            end           

            if (time_out_2ms == 1'b1 && reset_time_out  == 1'b0)
            begin
              if (retry_counter_int == MAX_RETRIES) 
                // If too many retries are performed compared to what is specified in 
                // the generic, the counter simply wraps around.
                retry_counter_int <= `DLY  0;
              else 
              begin
                retry_counter_int <= `DLY  retry_counter_int + 1;
              end 
              rx_state            <= `DLY  ASSERT_ALL_RESETS; 
            end 
           end            
          
           DO_PHASE_ALIGNMENT :
           begin 
            //The direct handling of the signals for the Phase Alignment is done outside
            //this state-machine. 
            RESET_PHALIGNMENT       <= `DLY  1'b0;
            run_phase_alignment_int <= `DLY  1'b1;
            reset_time_out          <= `DLY  1'b0;
            
            if (PHALIGNMENT_DONE == 1'b1)
            begin
              rx_state        <= `DLY  MONITOR_DATA_VALID;
              reset_time_out  <= `DLY  1'b1;
            end 
            
            if (time_out_wait_bypass_s3 == 1'b1)
            begin
              if (retry_counter_int == MAX_RETRIES)
                // If too many retries are performed compared to what is specified in 
                // the generic, the counter simply wraps around.
                retry_counter_int <= `DLY  0;
              else
              begin
                retry_counter_int <= `DLY   retry_counter_int + 1;
              end 
              rx_state            <= `DLY  ASSERT_ALL_RESETS; 
            end            
           end
         
           MONITOR_DATA_VALID :
           begin 
            reset_time_out  <= `DLY  1'b0;

            if (data_valid_sync == 1'b0 && time_out_100us == 1'b1 && DONT_RESET_ON_DATA_ERROR == 1'b0 && reset_time_out  == 1'b0)
            begin
              rx_state              <= `DLY  ASSERT_ALL_RESETS; 
              rx_fsm_reset_done_int <= `DLY  1'b0;
            end
            else if (data_valid_sync == 1'b1)
            begin
              rx_state              <= `DLY  FSM_DONE; 
              rx_fsm_reset_done_int <= `DLY  1'b0;
              reset_time_out        <= `DLY  1'b1;
            end

           end            
          
           FSM_DONE :
           begin 
            reset_time_out        <= `DLY  1'b0;

            if (data_valid_sync == 1'b0)
            begin
               rx_fsm_reset_done_int <= `DLY  1'b0;
               reset_time_out        <= `DLY  1'b1;
              rx_state              <= `DLY  ASSERT_ALL_RESETS; 
 
            end
            else if(time_out_1us == 1'b1 && reset_time_out  == 1'b0)  
               rx_fsm_reset_done_int <= `DLY  1'b1;

           end

           default:
             rx_state                <= `DLY  INIT;

        endcase
      end
  end 

endmodule
